natsfr/VNAV1.2/board/VNAV1/dxf/adccore-F.Cu.dxf

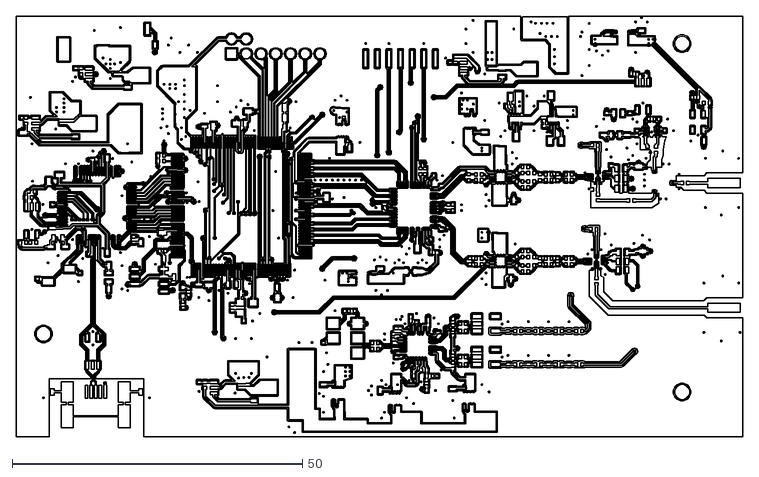
[picture p1: CAD file, 2022-05-22]
board/VNAV1/dxf/adccore-F.Cu.dxf
125.2 x 72.5
