natsfr/VNAV1.2/board/VNAV1/dxf/adccore-Edge.Cuts.dxf

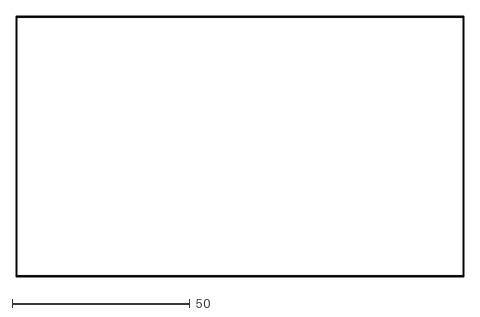
[picture p2: CAD file, 2022-05-22]
board/VNAV1/dxf/adccore-Edge.Cuts.dxf
125.9 x 73.1
