natsfr/VNAV1.2/(list of files, cad)

Other CAD files:
board/VNAV1/dxf/adccore-B.SilkS.dxf
