natsfr/VNAV1.2/board/VNAV1/doc/adccore.pdf

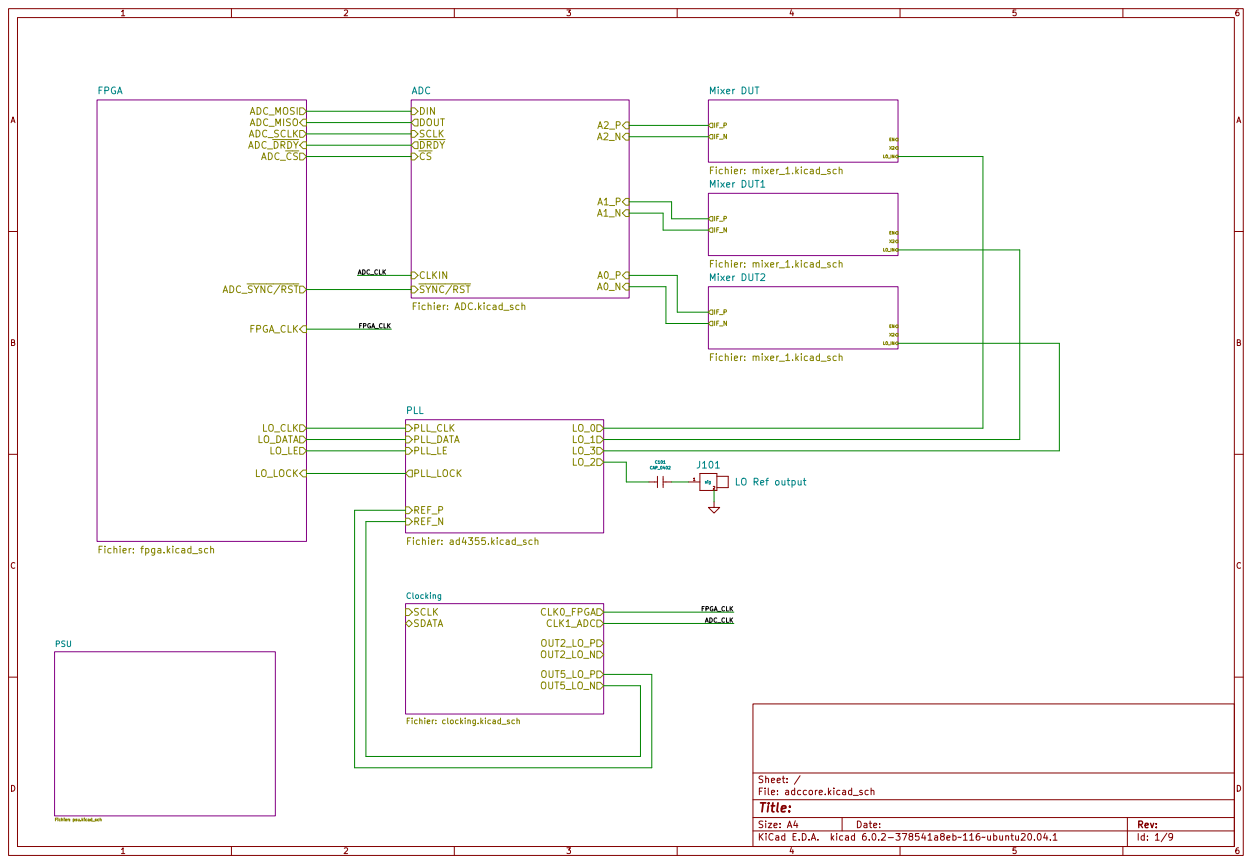
[picture p3: page 1]

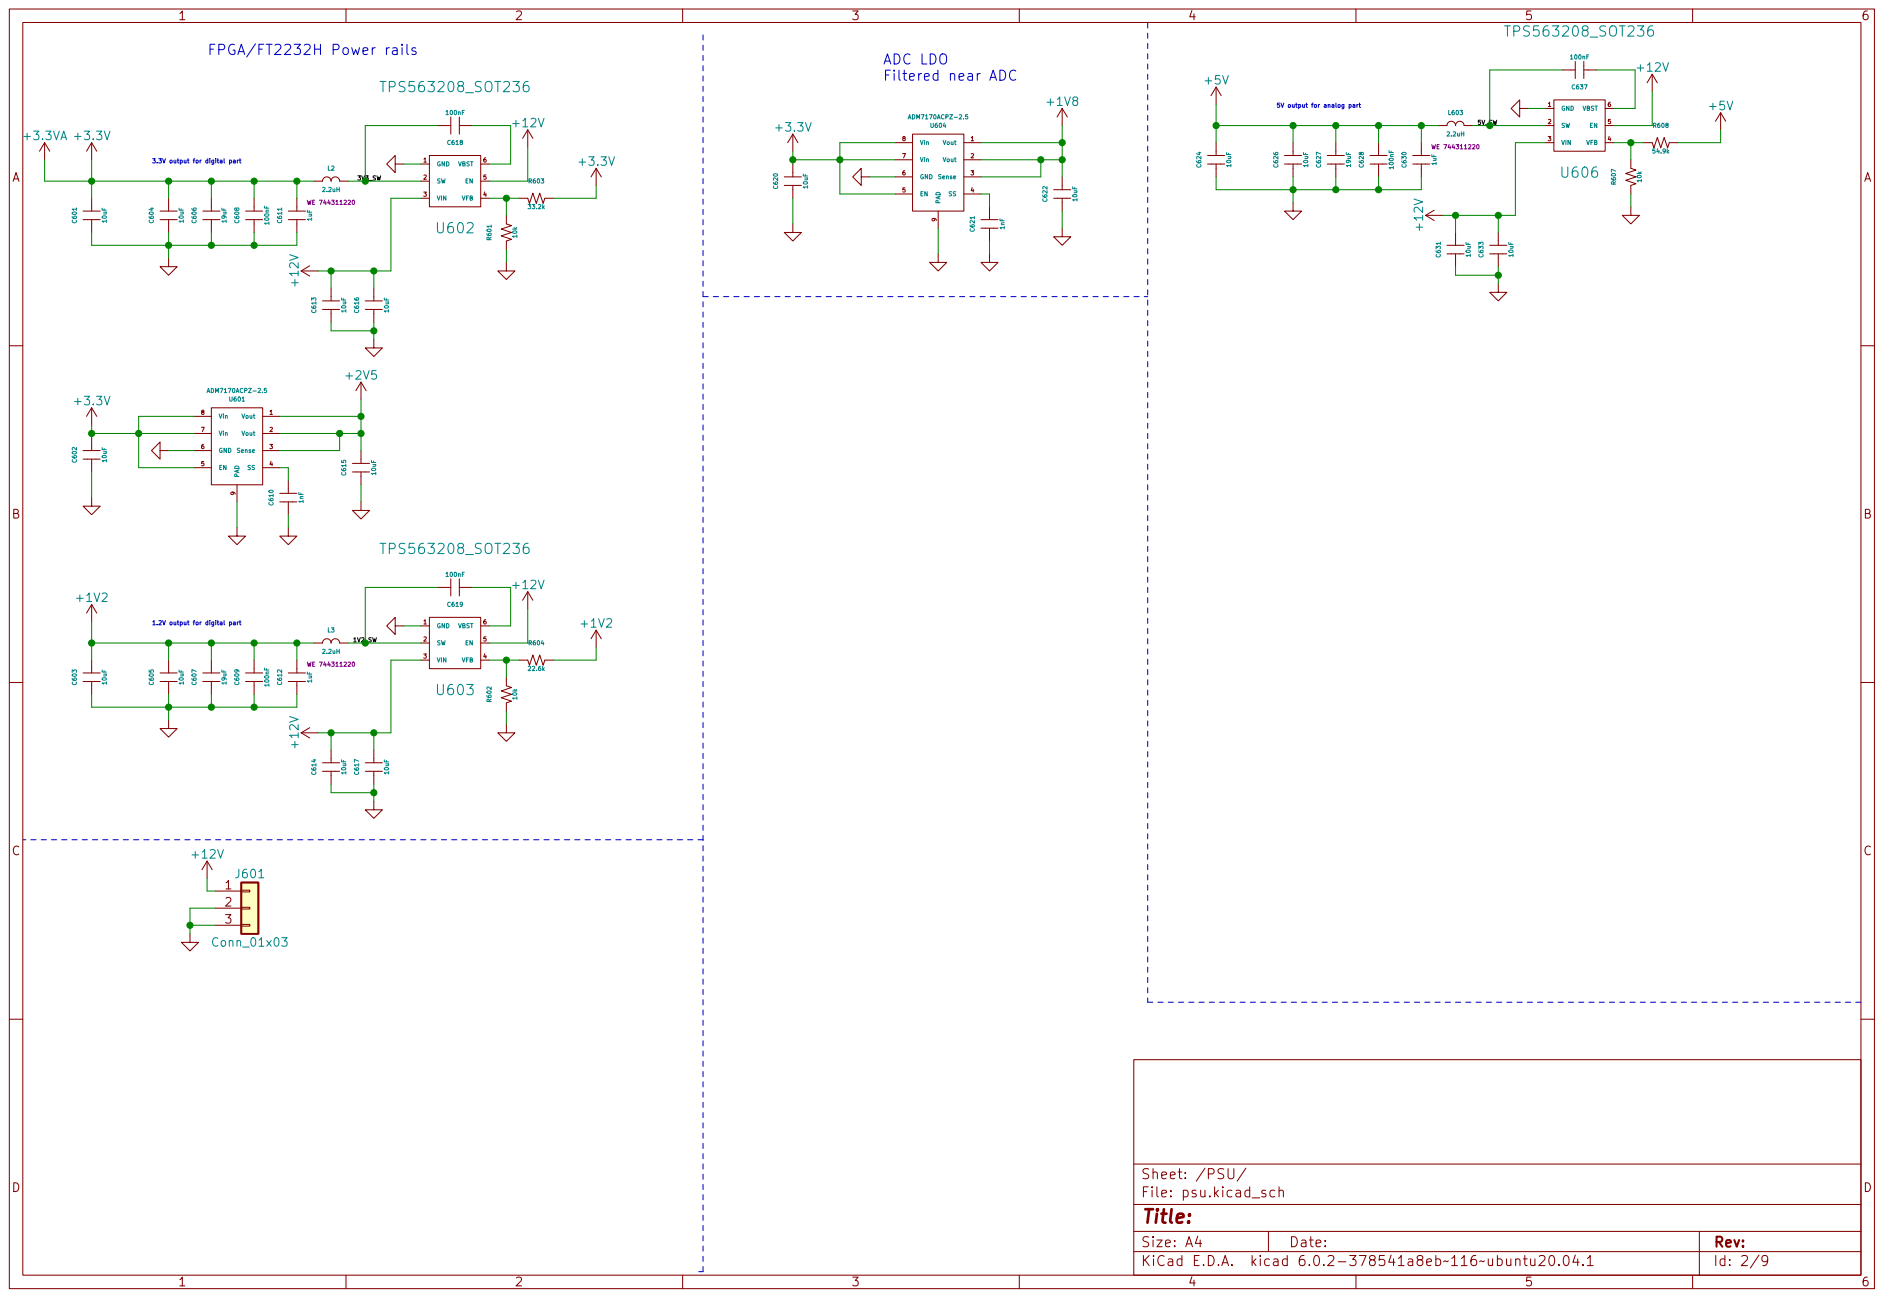
[picture p4: page 2]

5V output for analog part FPGA/FT2232H Power rails

1.2V output for digital part

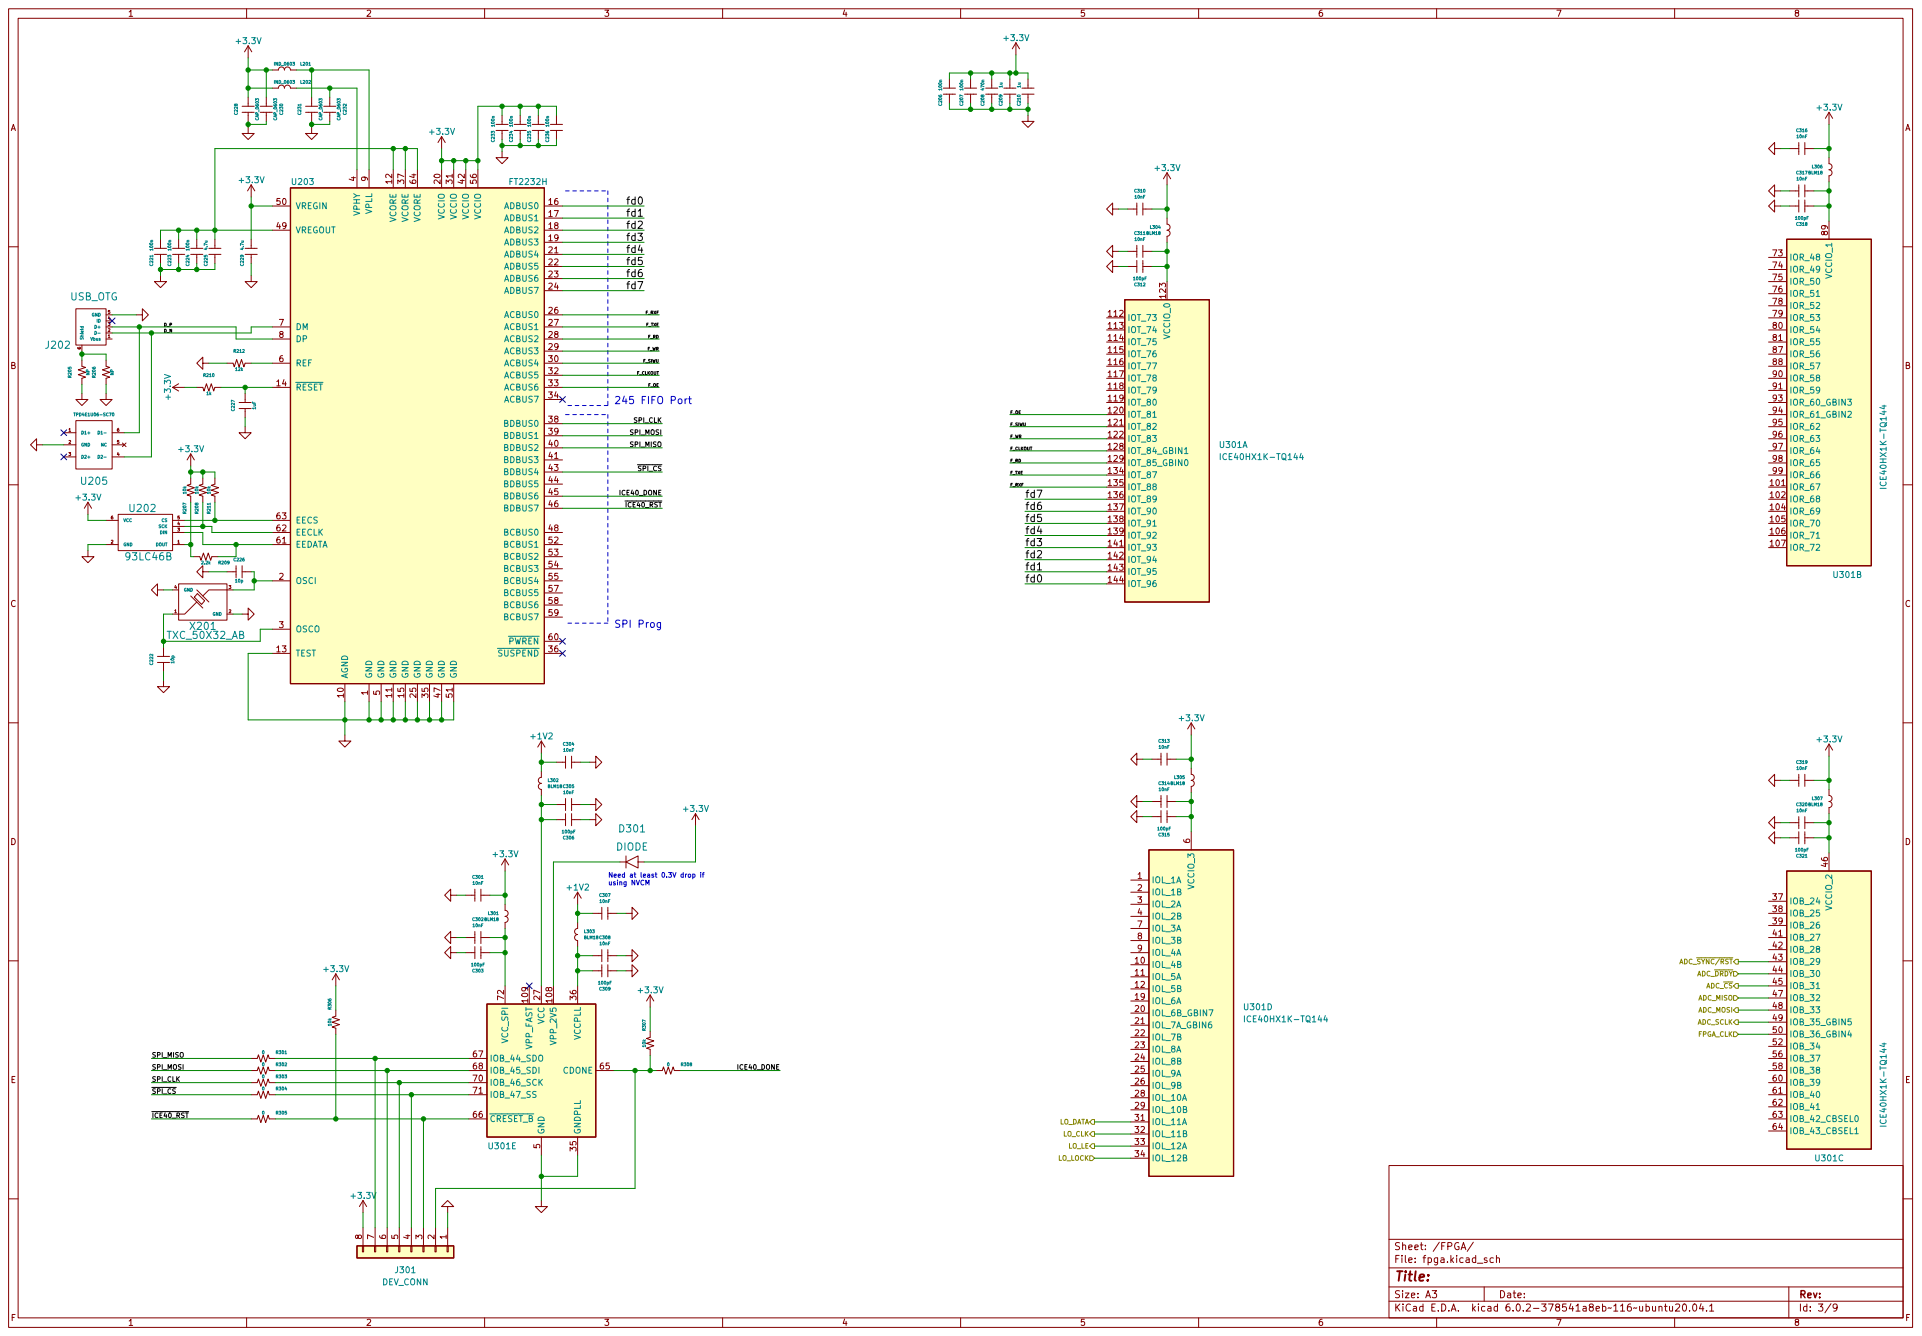
[picture p5: page 3]

File: fpga.kicad_sch Sheet: /FPGA/ C210 1u

fd1
fd2
fd3

Need at least 0.3V drop if using NVCM

ADC_~{DRDY} ADC_~{CS} ADC_MOSI ADC_~{SYNC/RST} ADC_MISO

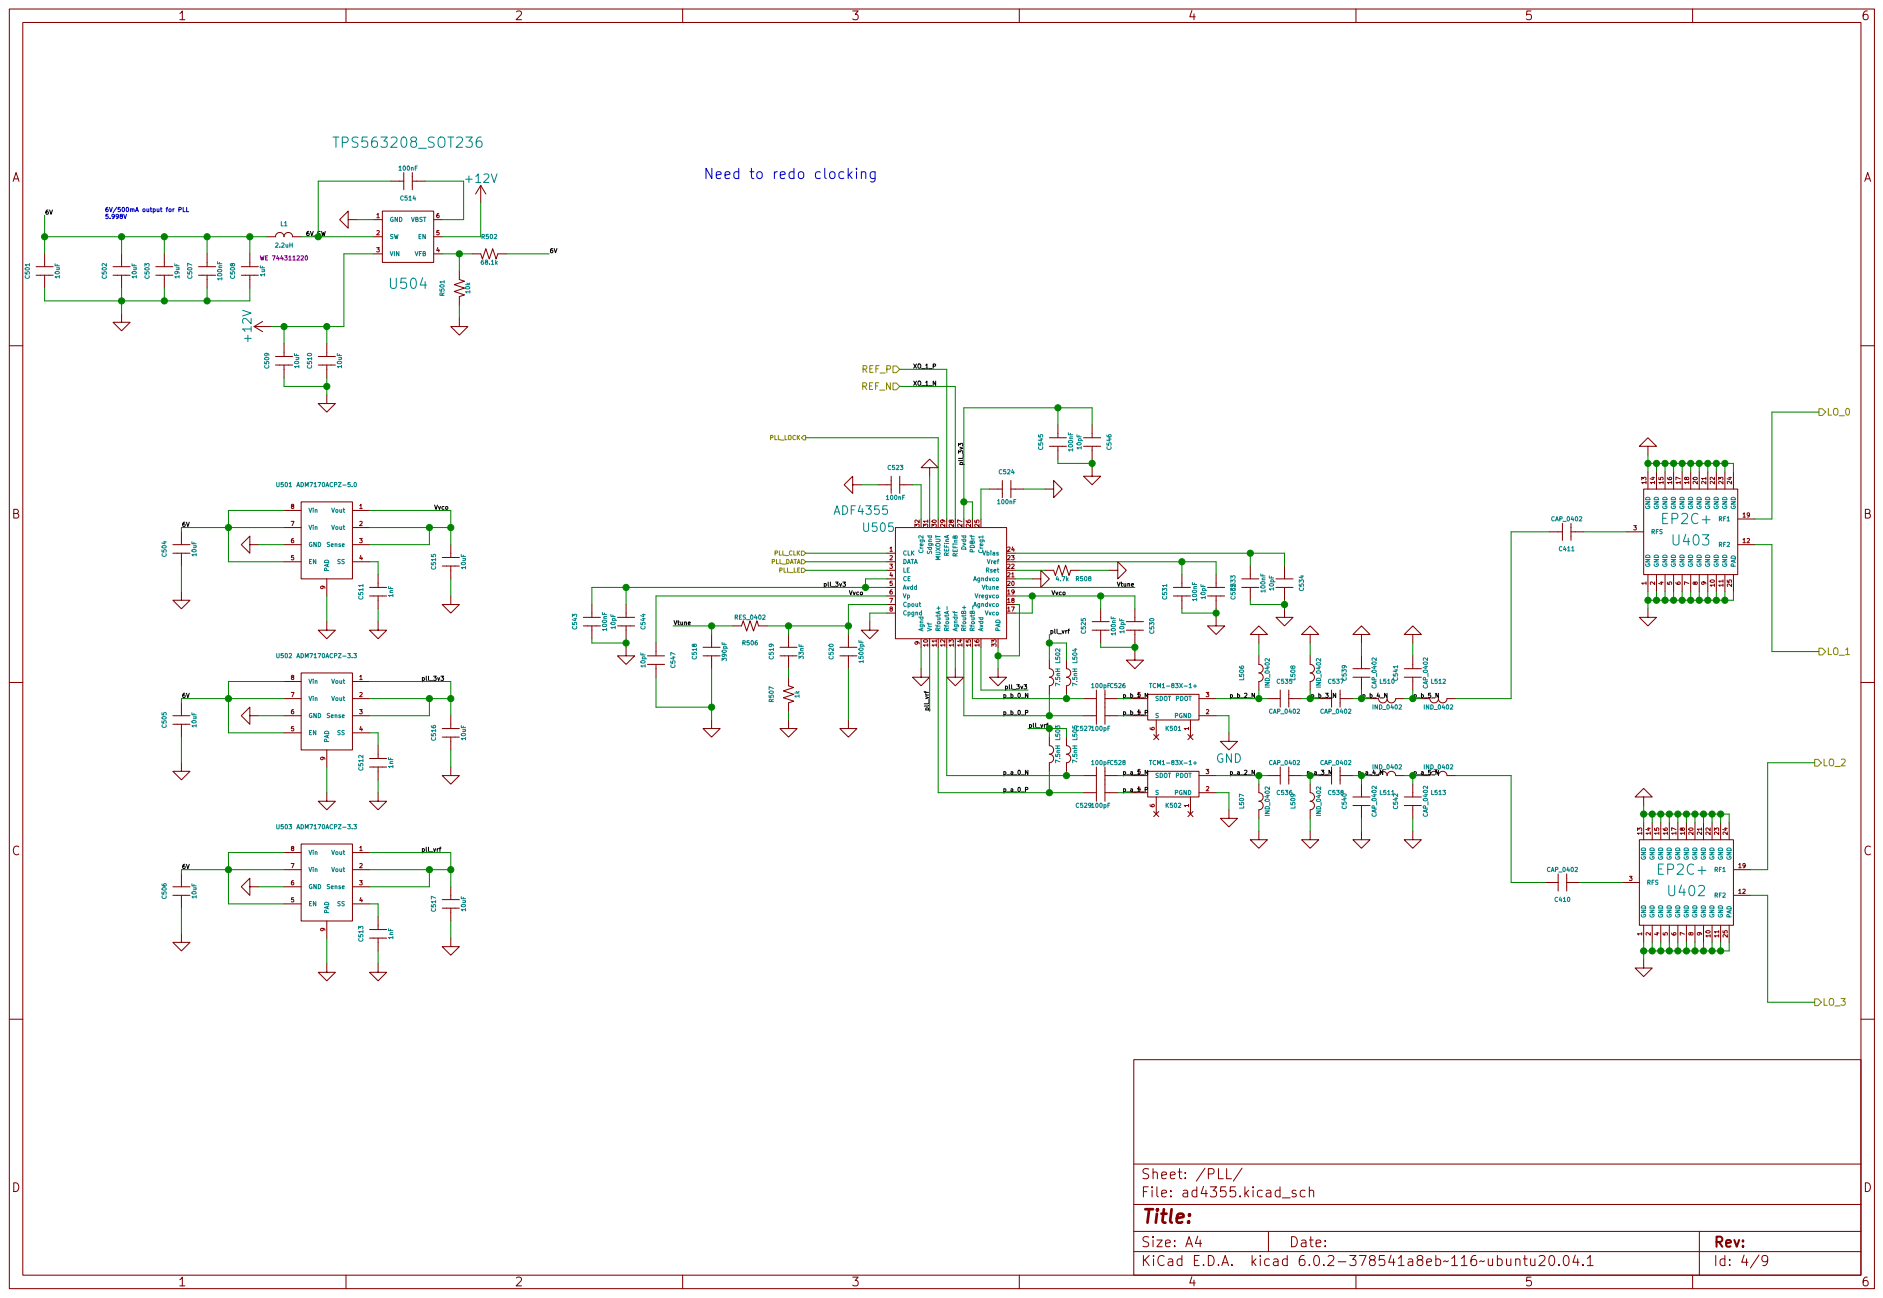
[picture p6: page 4]

9 U501 ADM7170ACPZ-5.0 C512 1nF C507 100nF C508 1uF C504 10uF C501 10uF C510 10uF C502 10uF C503 19uF +12V C509 10uF C515 10uF GND 1 SW 2 VIN 3 VFB 4 EN 5 VBST 6 U504 TPS563208_SOT236

2 GND 20 GND 21 GND 22 GND 23 GND 24 PAD 25 RFS 3 GND

1 GND 10 GND 11 RF2 12 GND 13 GND 14 GND 15 GND 16 GND 17 GND 18 RF1 19 GND

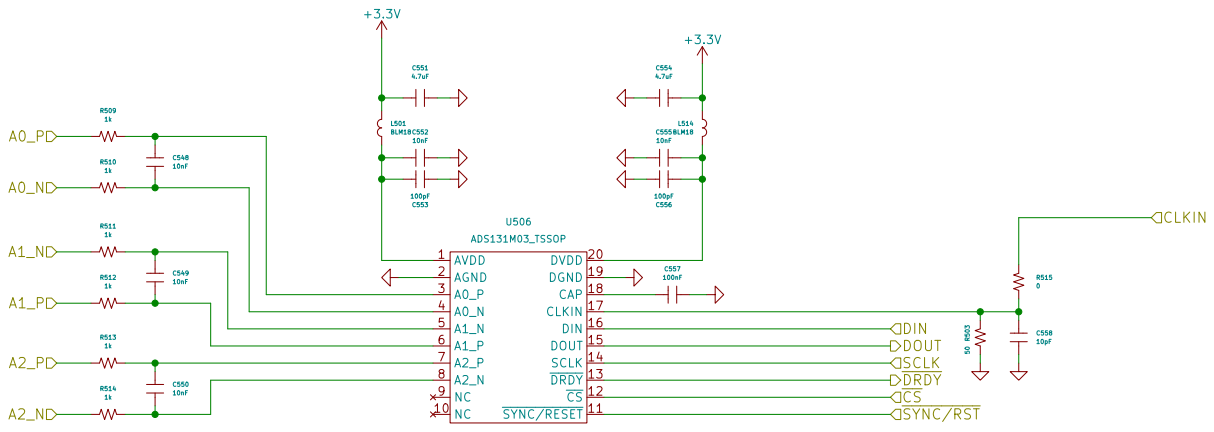
[picture p7: page 5]

File: ADC.kicad_sch Sheet: /ADC/
Id: 5/9 Title:

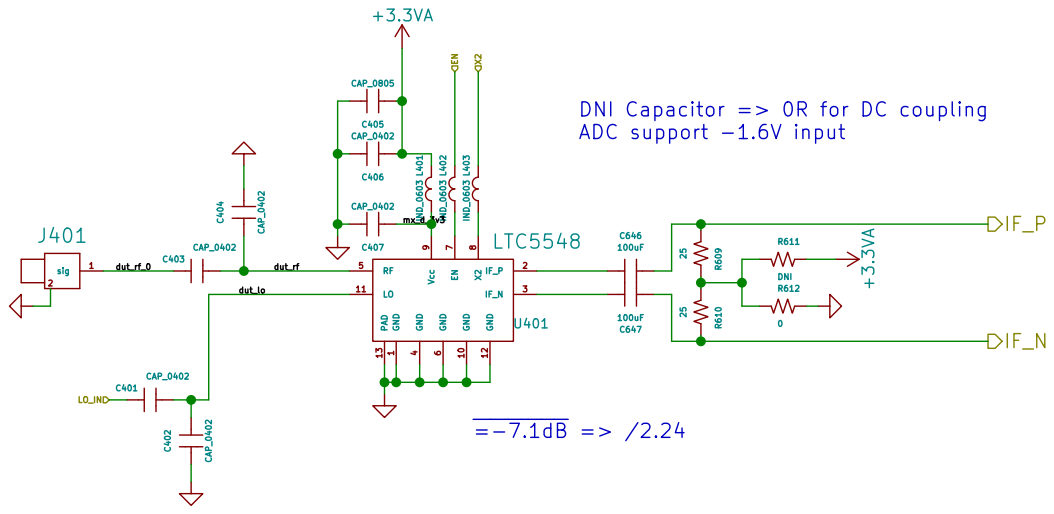
[picture p8: page 6]

File: mixer_1.kicad_sch Sheet: /Mixer DUT/
Id: 6/9 Title:

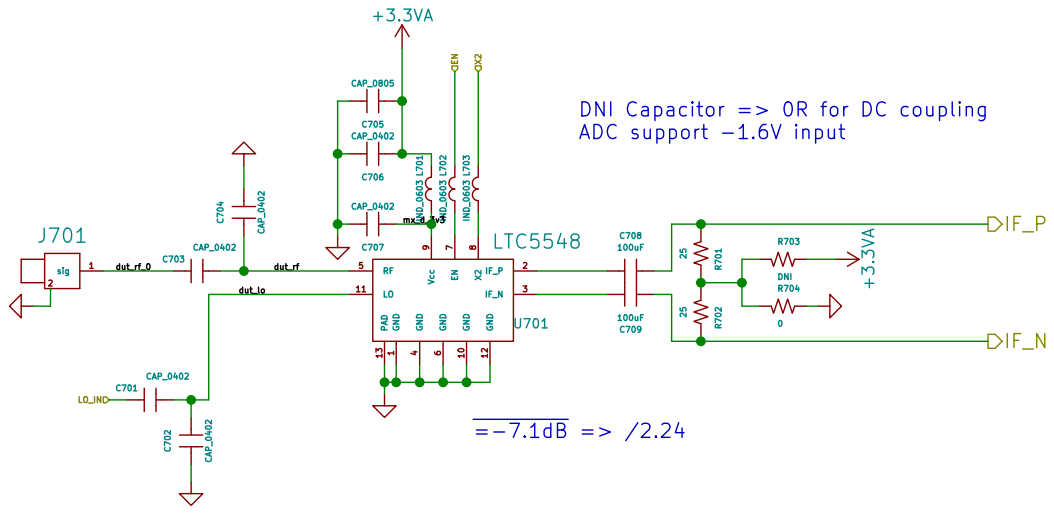
[picture p9: page 7]

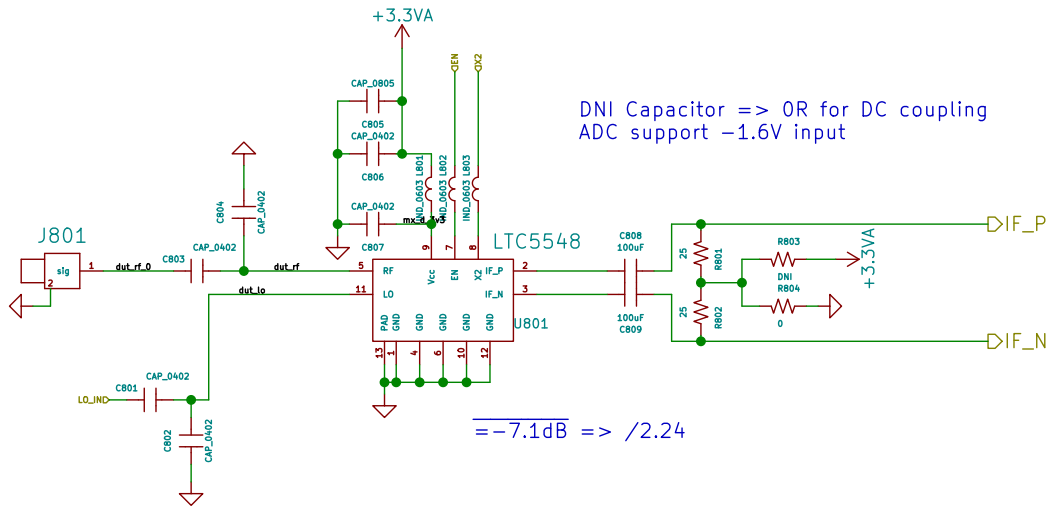
[picture p10: page 8]

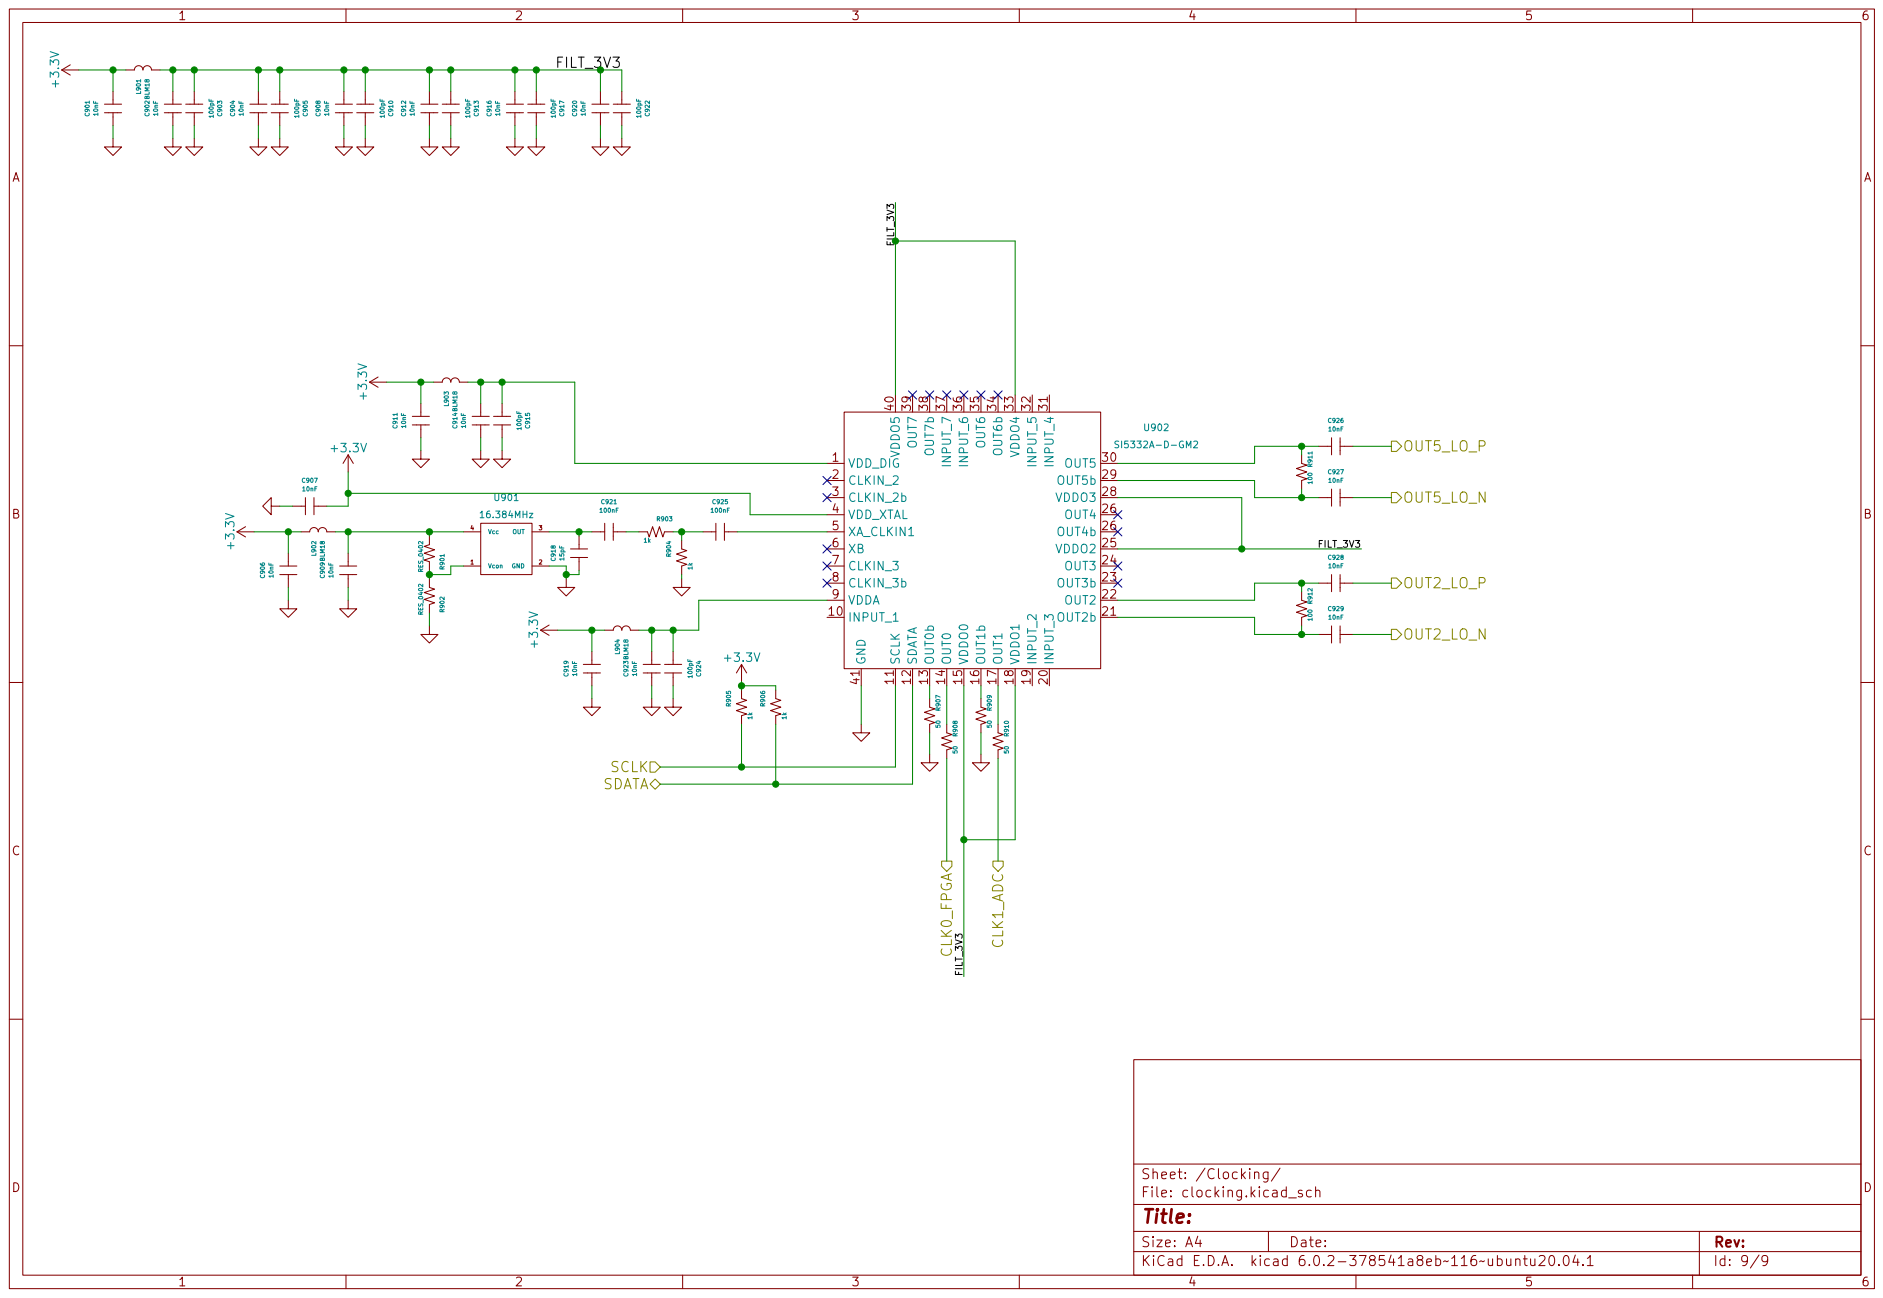
[picture p11: page 9]
