natsfr/VNAV1.2/board/VNAV1/adccore.kicad_pcb

## KiCad design board/VNAV1/adccore.kicad_pcb (2022-05-22)

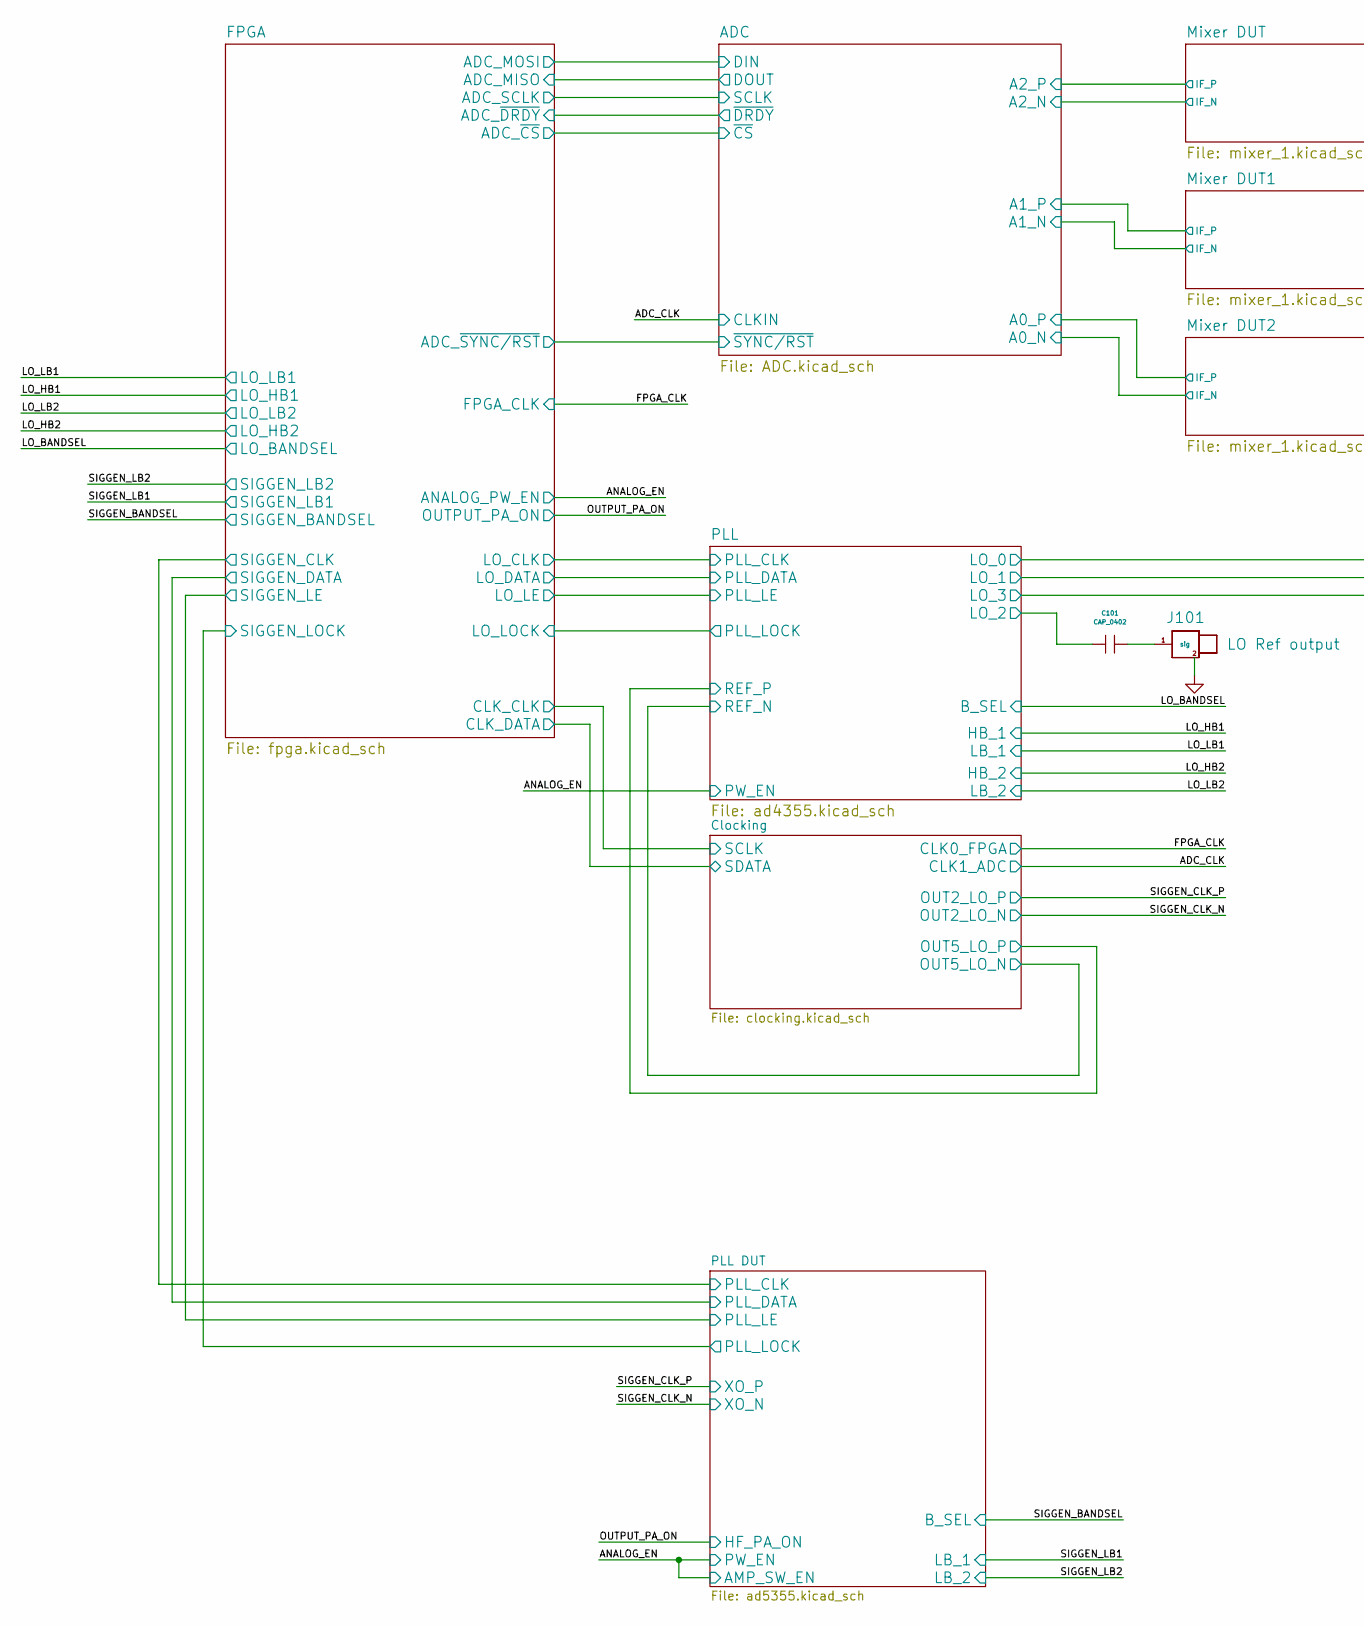
[picture p20: schematic adccore.kicad_sch, part in row 1, column 1]

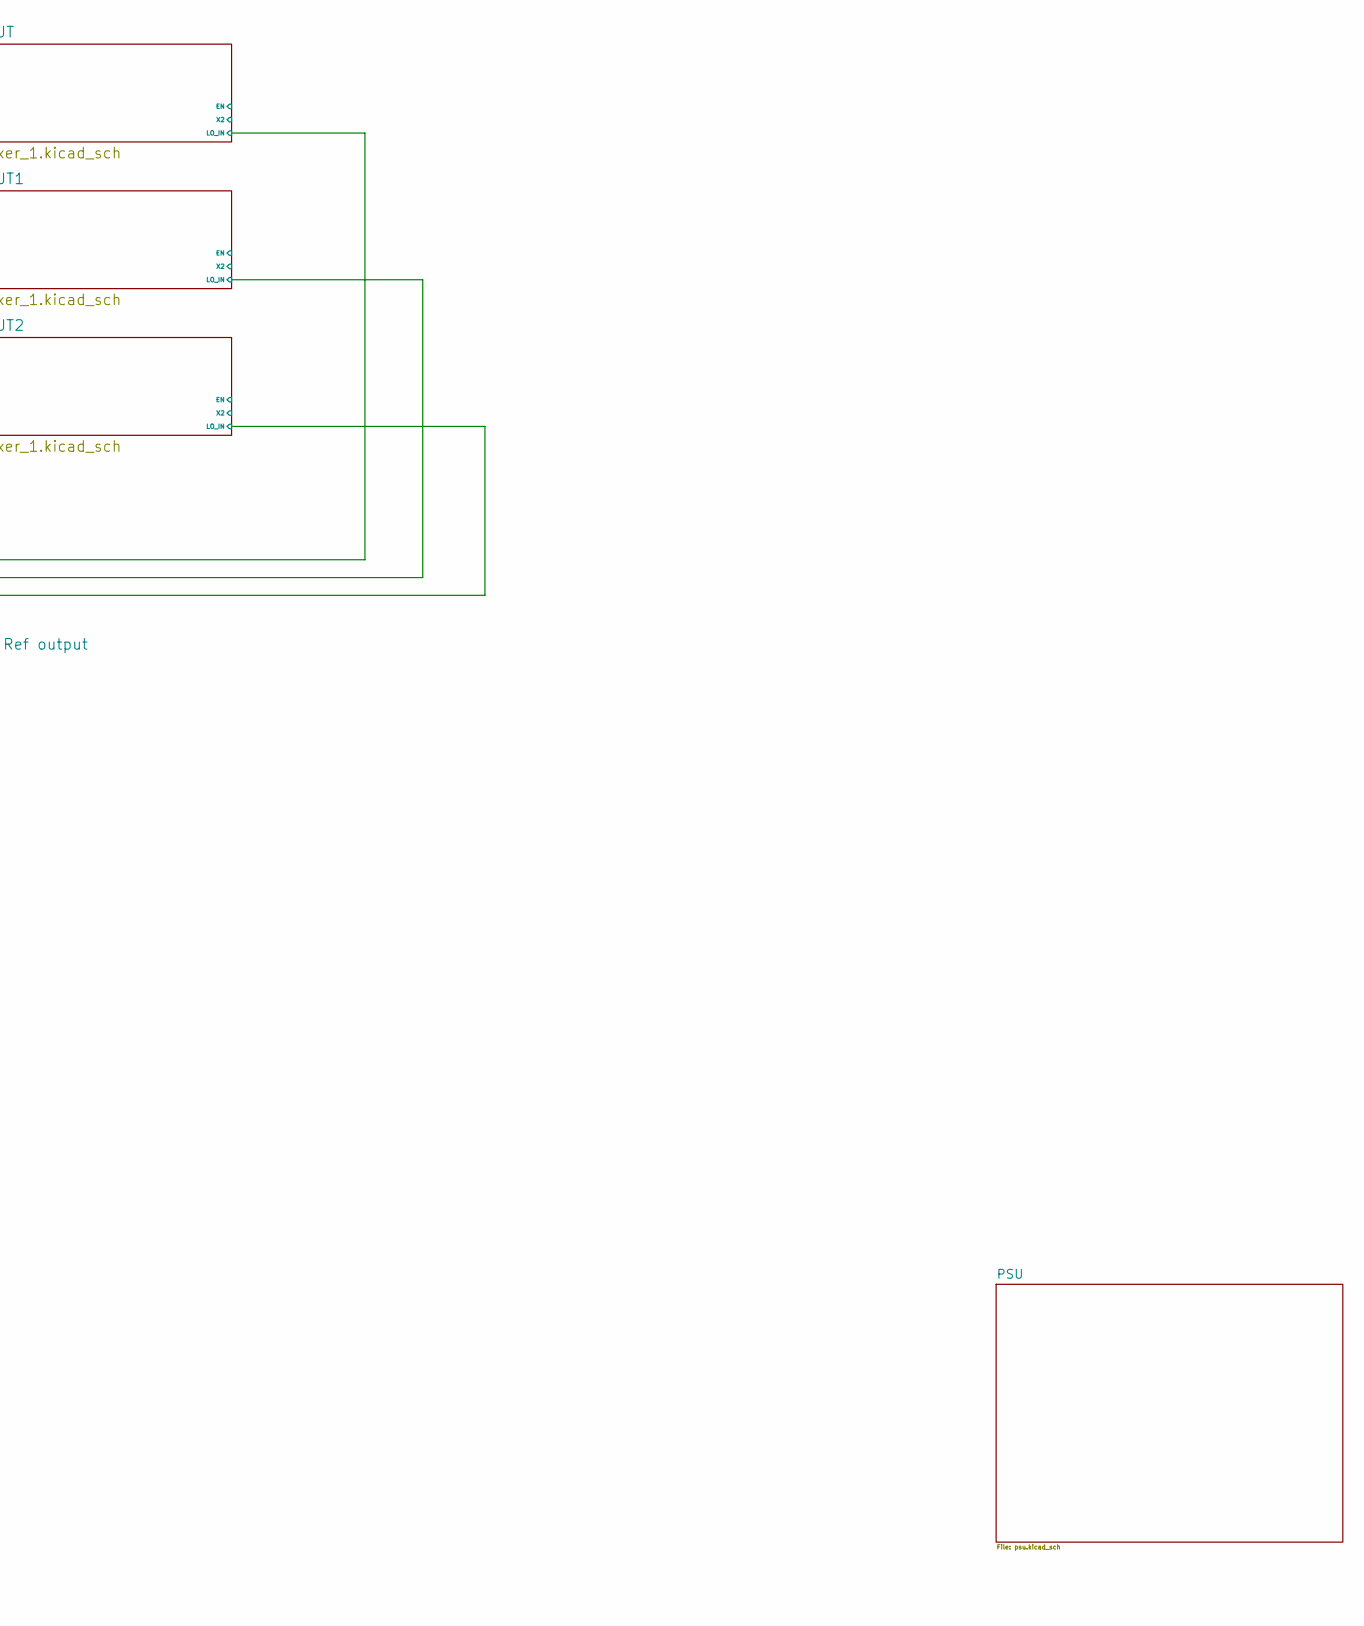
[picture p21: schematic adccore.kicad_sch, part in row 1, column 2]

Parts:
C101: CAP_0402; SM0402
J101: LO Ref output; SMA_AMP_132255-12

Connections:
/PLL/LO_2: C101.1; also elsewhere on the board
GND: J101.2; also elsewhere on the board
unnamed: C101.2, J101.1 (sig)

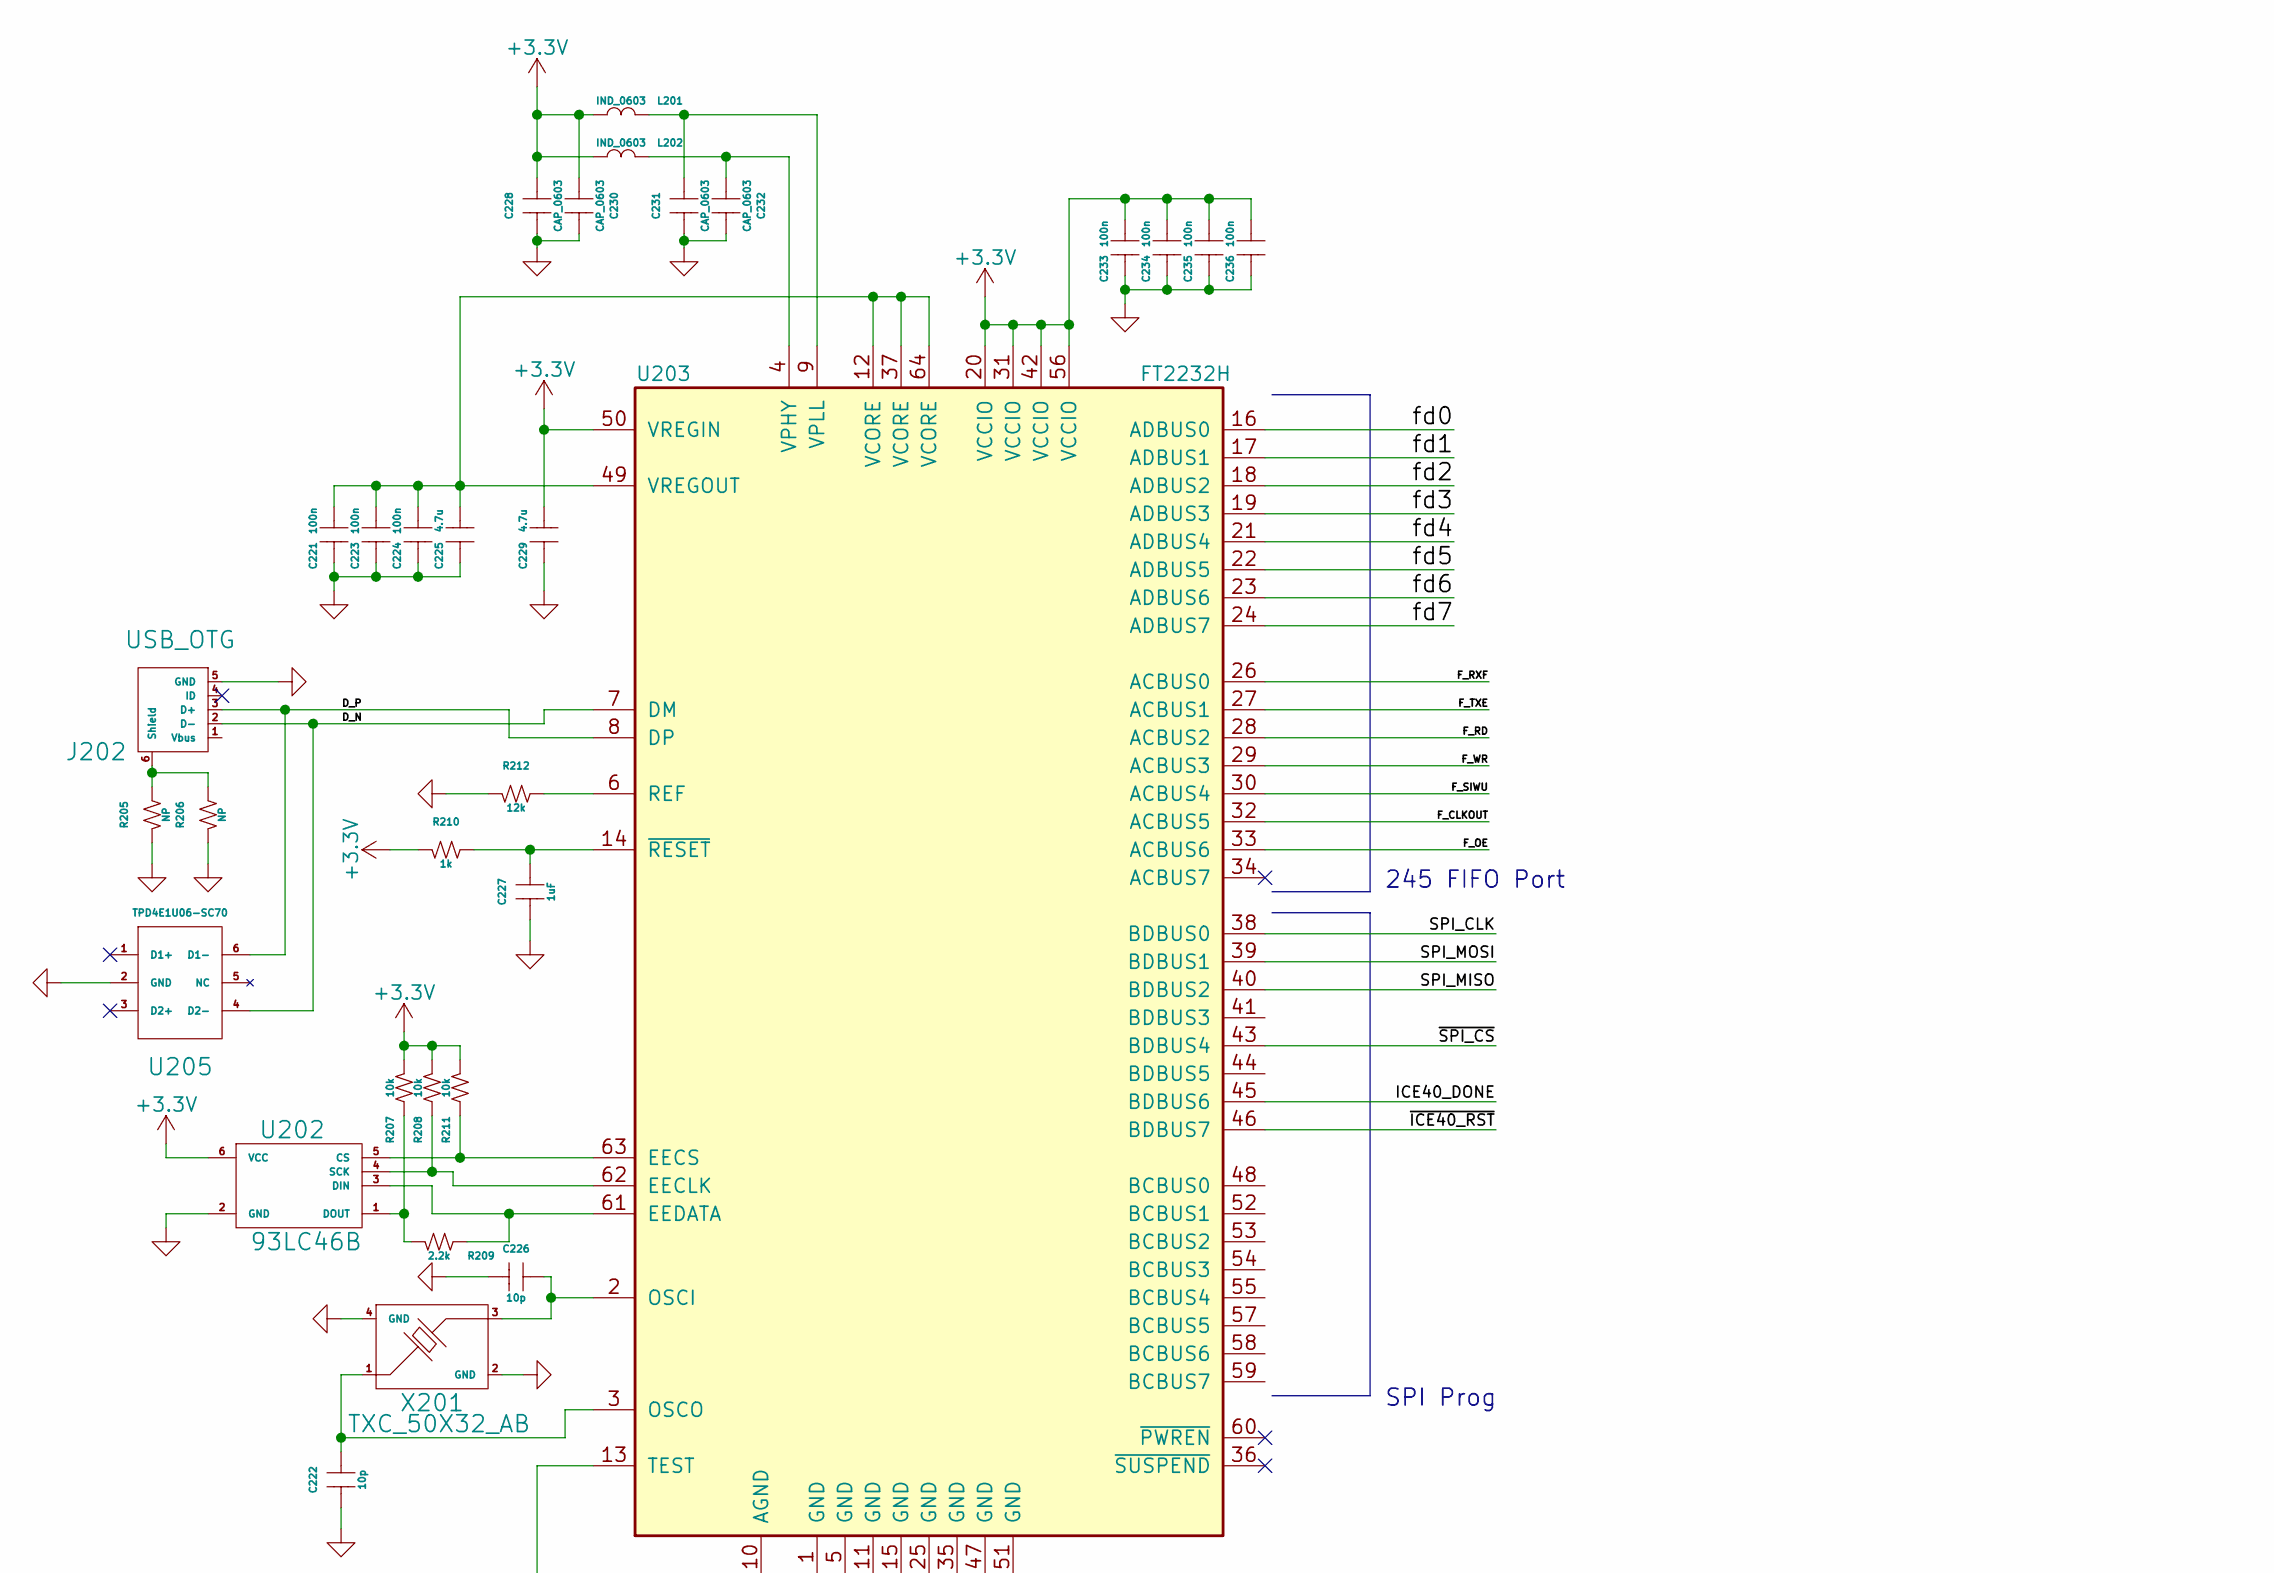
[picture p22: schematic fpga.kicad_sch, part in row 1, column 1]

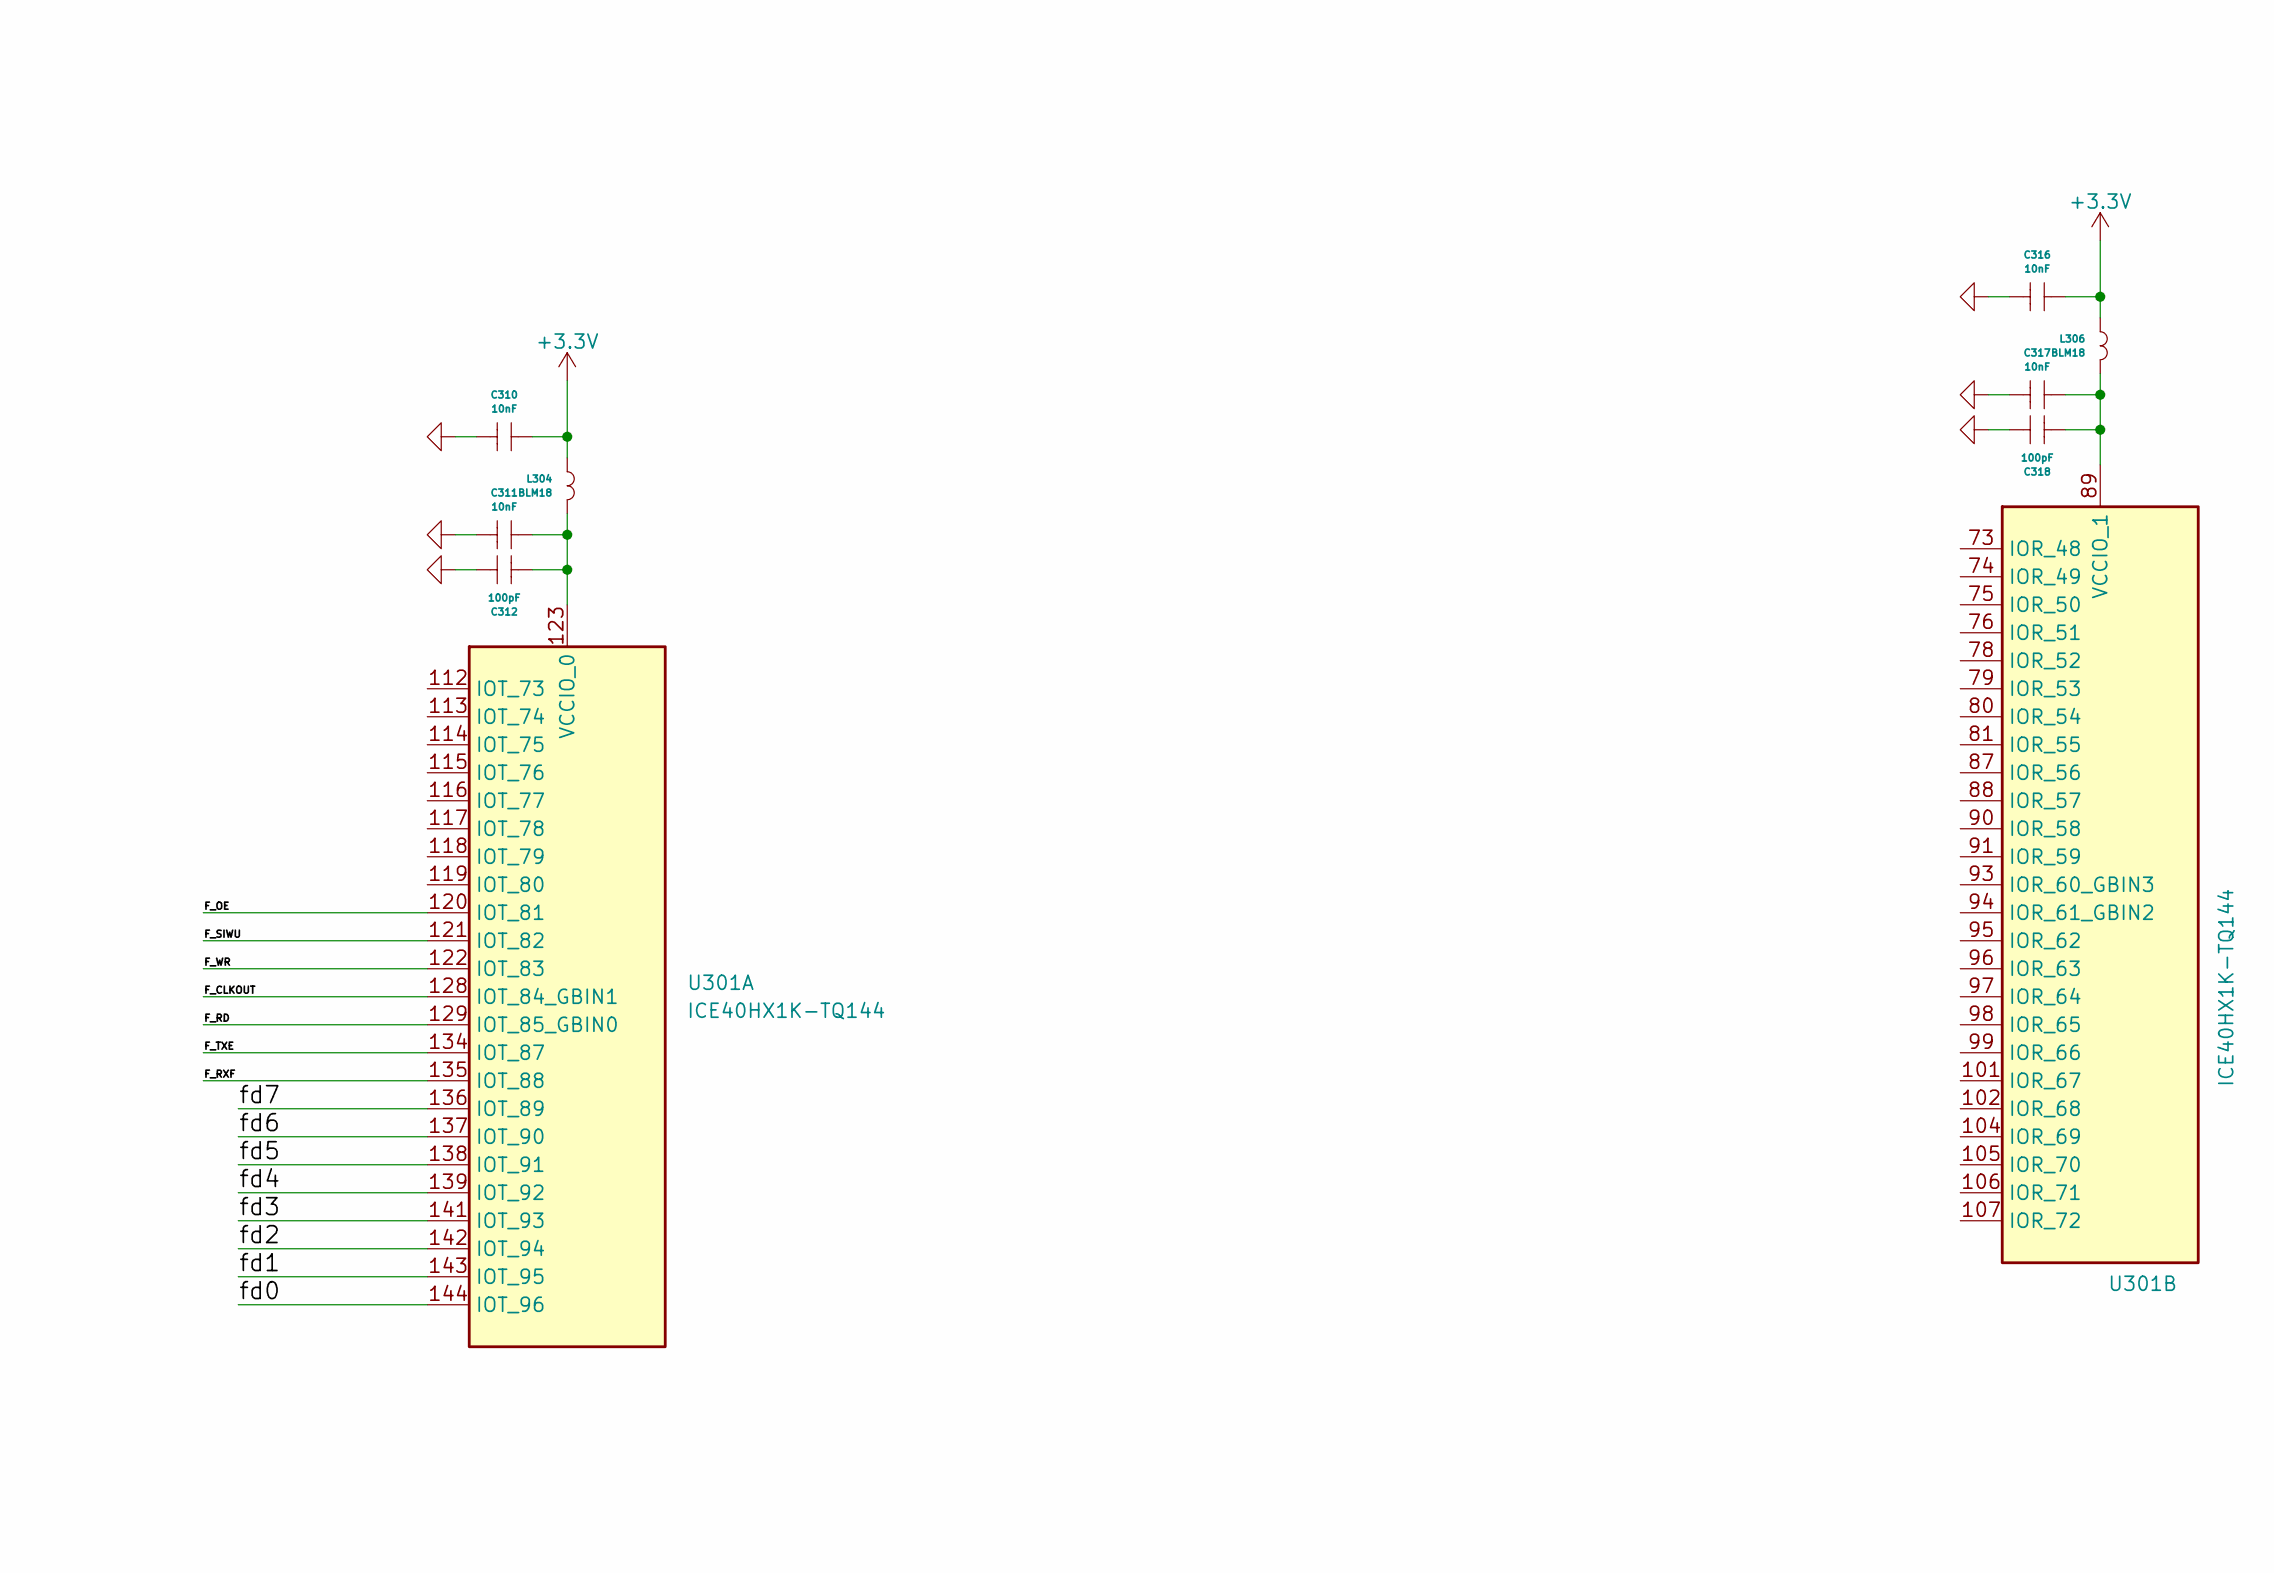
[picture p23: schematic fpga.kicad_sch, part in row 1, column 2]

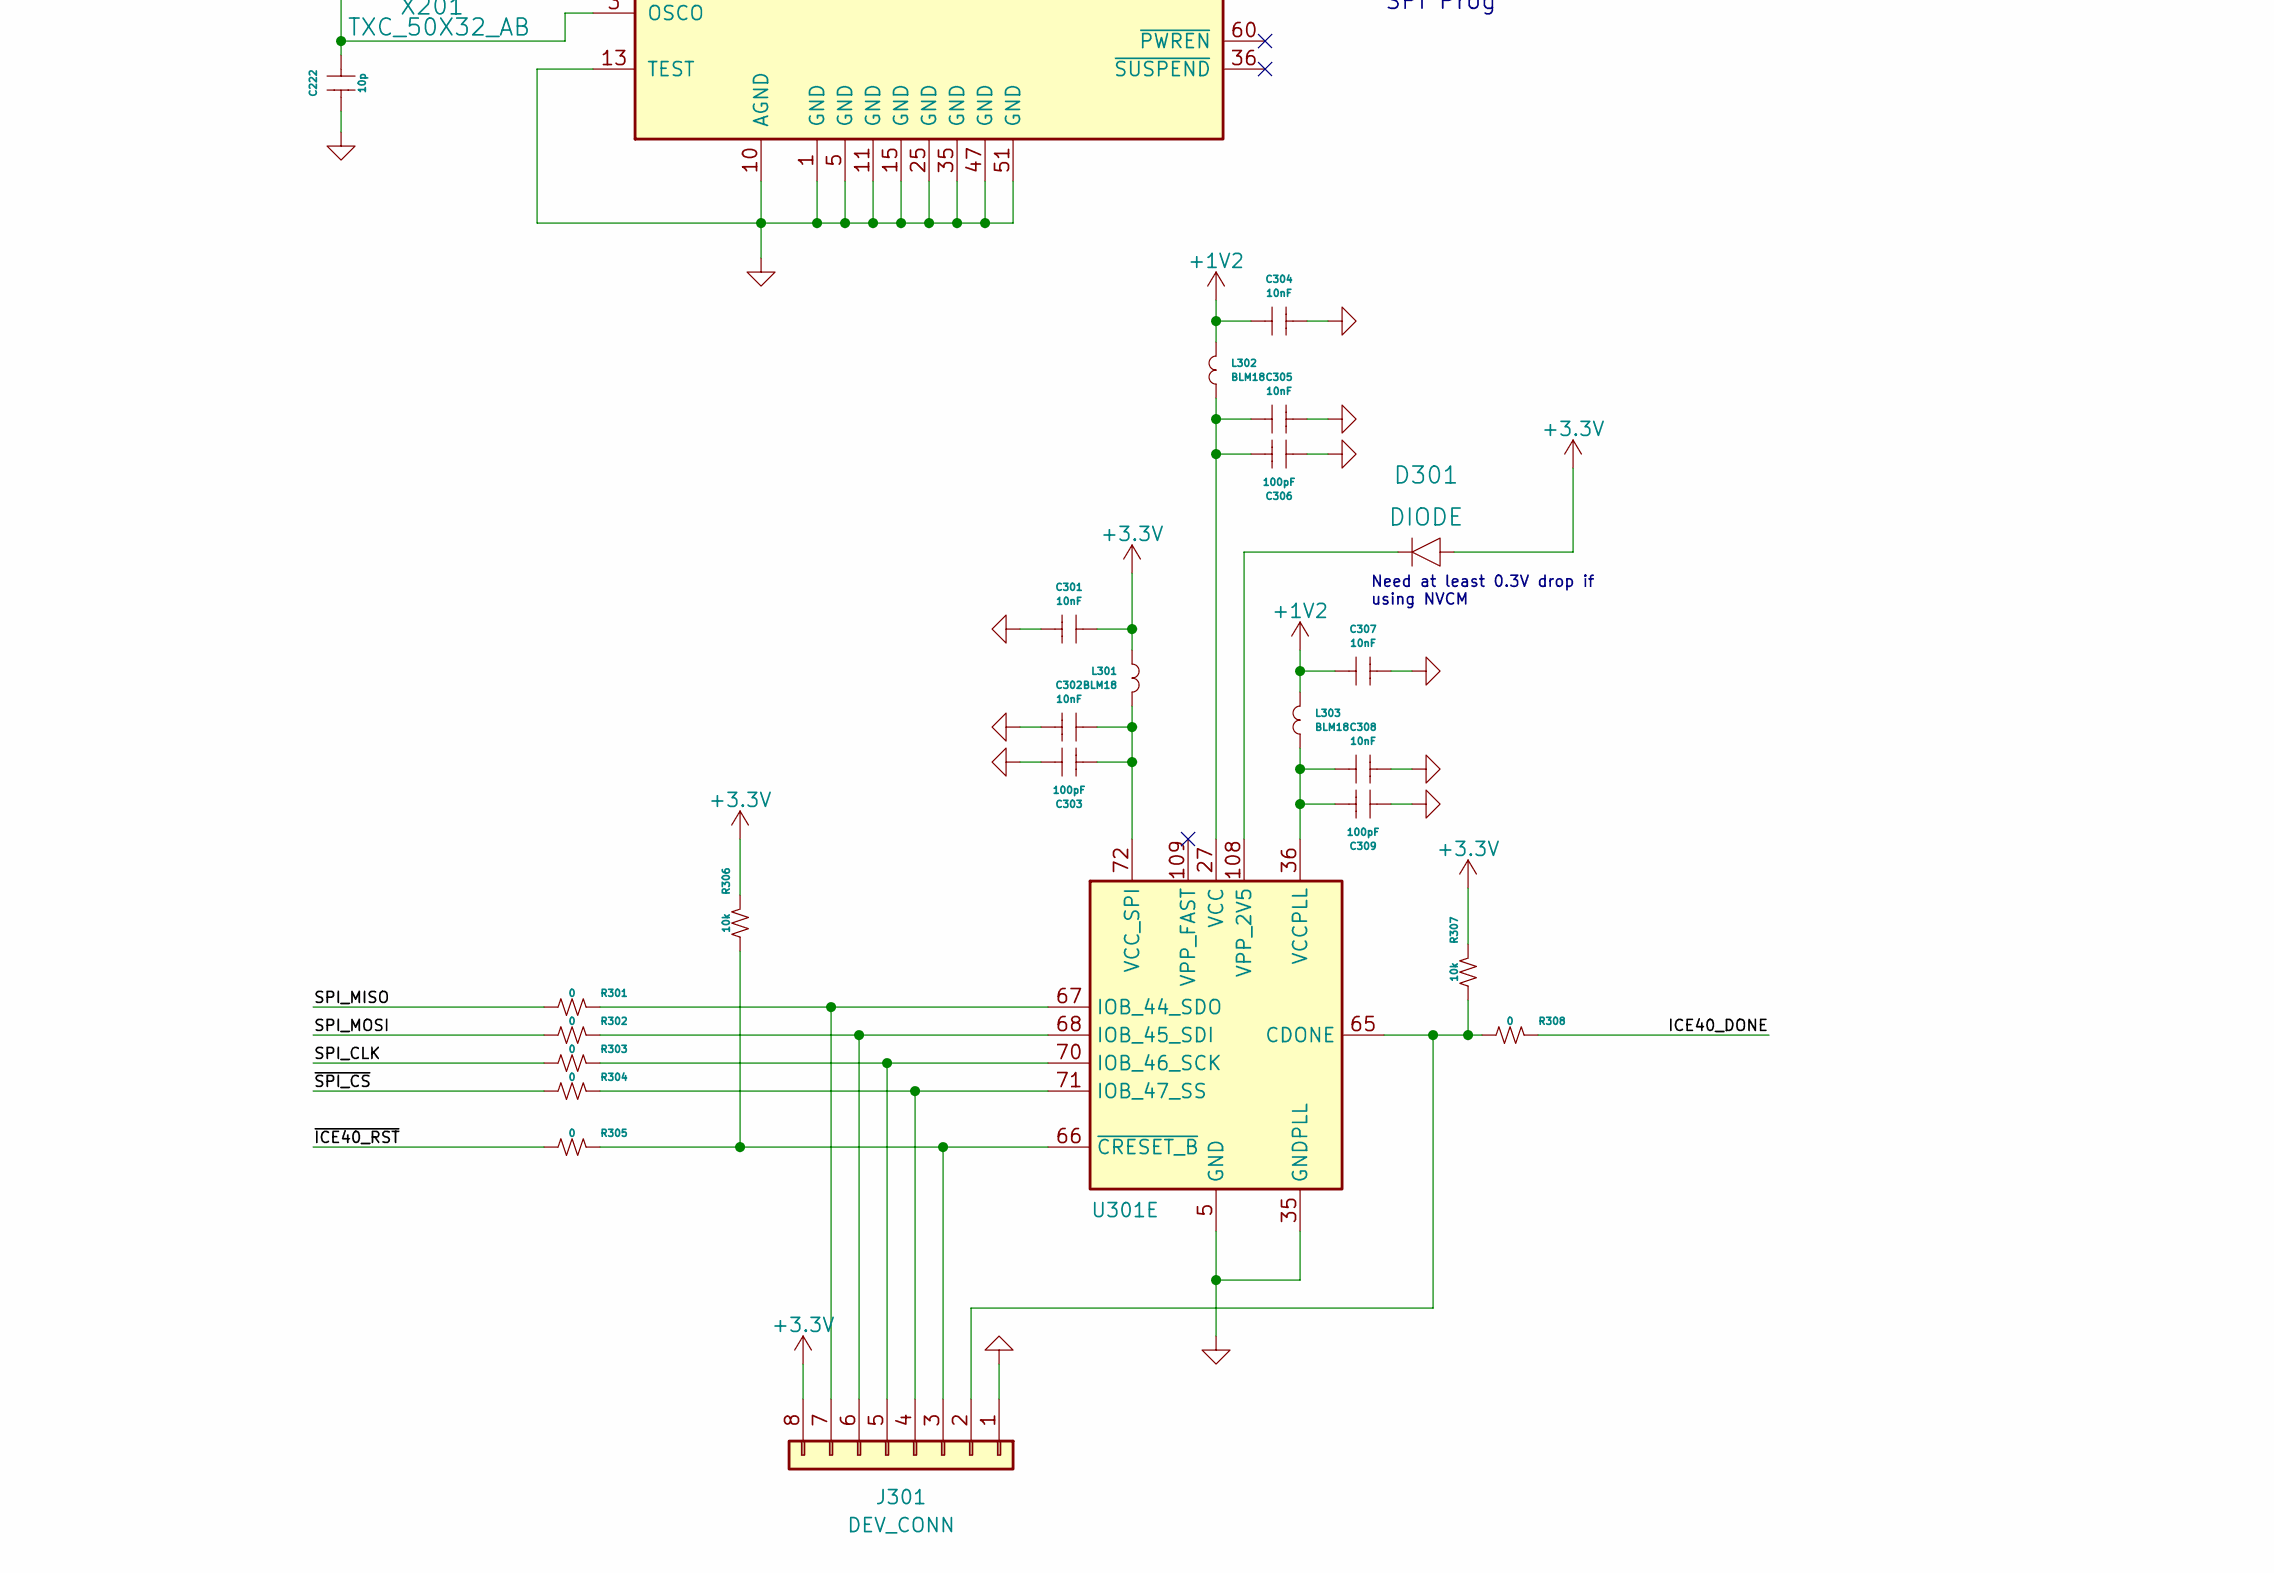
[picture p24: schematic fpga.kicad_sch, part in row 2, column 1]

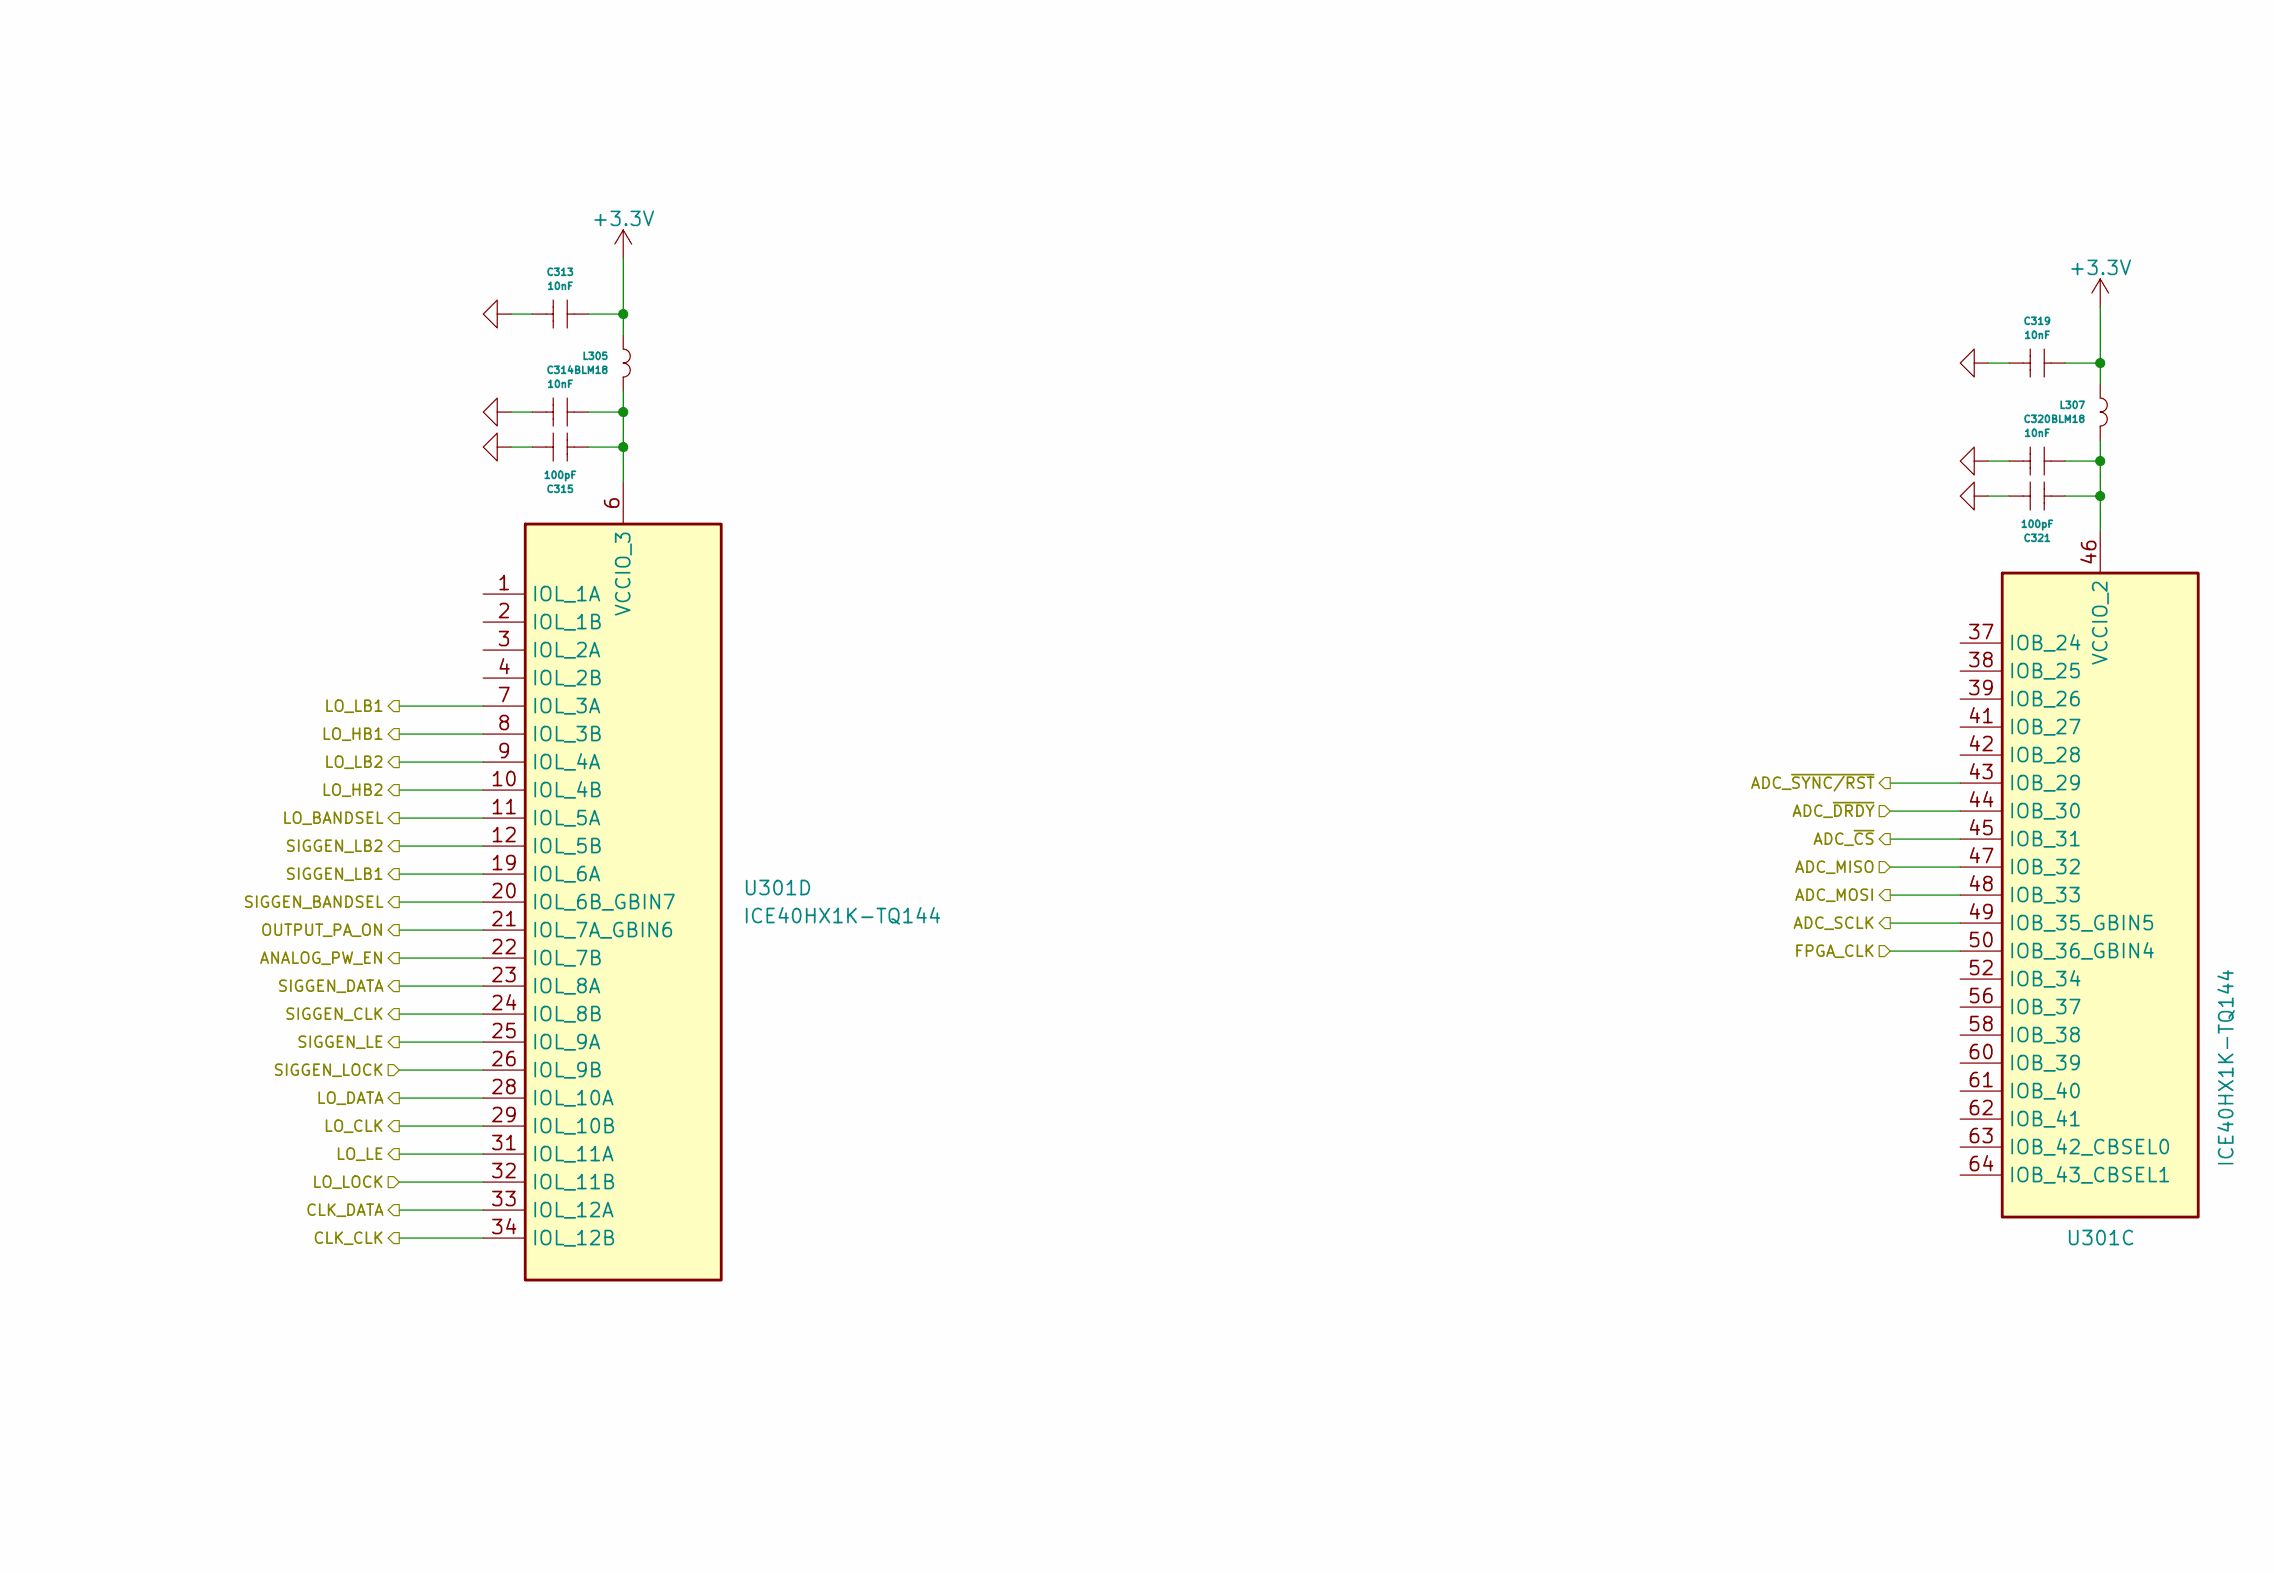
[picture p25: schematic fpga.kicad_sch, part in row 2, column 2]

Parts:
C221, C223, C224: 100n; SM0603
C222, C226: 10p; SM0402
C225, C229: 4.7u; SM0805
C227: 1uF; SM0603
C228, C230, C231, C232: CAP_0603; SM0603
C233, C234, C235, C236: 100n; SM0402
C301, C302, C304, C305, C307, C308, C310, C311, C313, C314, C316, C317, C319, C320: 10nF; SM0402
C303, C306, C309, C312, C315, C318, C321: 100pF; SM0402
D301: DIODE; SOD-123
J202: USB_OTG; USB_Micro-B_Wuerth_629105150521_CircularHoles
J301: DEV_CONN
L201, L202: IND_0603; SM0603
L301, L302, L303, L304, L305, L306, L307: BLM18; SM0603
R205, R206: NP; SM0603
R207, R208, R211, R306, R307: 10k; SM0402
R209: 2.2k; SM0402
R210: 1k; SM0402
R212: 12k; SM0402
R301, R302, R303, R304, R305, R308: 0; SM0402
U202: 93LC46B; SOT-236-095mm
U203: FT2232H; LQFP_64
U205: TPD4E1U06-SC70; SOT-236-095mm
U301: ICE40HX1K-TQ144; TQFP-144_20x20mm_P0.5mm
X201: TXC_50X32_AB; XTAL_5.0x3.2mm

Connections:
+1V2: C304.1, C307.1, L302.2, L303.2; also elsewhere on the board
+3.3VA: C228.1, C229.2, C230.1, C233.1, C234.1, C235.1, C236.1, C301.1, C310.1, C313.1, C316.1, C319.1, D301.A, J301.8, L201.1, L202.1, L301.2, L304.2, L305.2, L306.2, L307.2, R207.2, R208.2, R210.2, R211.2, R306.1, R307.1, U202.6 (VCC), U203.20 (VCCIO), U203.31 (VCCIO), U203.42 (VCCIO), U203.50 (VREGIN), U203.56 (VCCIO); also elsewhere on the board
/ADC/DIN: U301.48 (IOB_33); also elsewhere on the board
/ADC/DOUT: U301.47 (IOB_32); also elsewhere on the board
/ADC/SCLK: U301.49 (IOB_35_GBIN5); also elsewhere on the board
/ADC/~CS: U301.45 (IOB_31); also elsewhere on the board
/ADC/~DRDY: U301.44 (IOB_30); also elsewhere on the board
/ADC/~SYNC/RST: U301.43 (IOB_29); also elsewhere on the board
/ANALOG_EN: U301.22 (IOL_7B); also elsewhere on the board
/Clocking/SCLK: U301.34 (IOL_12B); also elsewhere on the board
/Clocking/SDATA: U301.33 (IOL_12A); also elsewhere on the board
/FPGA/D_N: J202.2 (D-), U203.7 (DM), U205.4 (D2-)
/FPGA/D_P: J202.3 (D+), U203.8 (DP), U205.6 (D1-)
/FPGA/F_CLKOUT: U203.32 (ACBUS5), U301.128 (IOT_84_GBIN1)
/FPGA/F_OE: U203.33 (ACBUS6), U301.120 (IOT_81)
/FPGA/F_RD: U203.28 (ACBUS2), U301.129 (IOT_85_GBIN0)
/FPGA/F_RXF: U203.26 (ACBUS0), U301.135 (IOT_88)
/FPGA/F_SIWU: U203.30 (ACBUS4), U301.121 (IOT_82)
/FPGA/F_TXE: U203.27 (ACBUS1), U301.134 (IOT_87)
/FPGA/F_WR: U203.29 (ACBUS3), U301.122 (IOT_83)
/FPGA/ICE40_DONE: R308.1, U203.45 (BDBUS6)
/FPGA/LO_CLK: U301.29 (IOL_10B); also elsewhere on the board
/FPGA/LO_DATA: U301.28 (IOL_10A); also elsewhere on the board
/FPGA/LO_LE: U301.31 (IOL_11A); also elsewhere on the board
/FPGA/LO_LOCK: U301.32 (IOL_11B); also elsewhere on the board
/FPGA/SIGGEN_CLK: U301.24 (IOL_8B); also elsewhere on the board
/FPGA/SIGGEN_DATA: U301.23 (IOL_8A); also elsewhere on the board
/FPGA/SIGGEN_LE: U301.25 (IOL_9A); also elsewhere on the board
/FPGA/SIGGEN_LOCK: U301.26 (IOL_9B); also elsewhere on the board
/FPGA/SPI_CLK: R303.2, U203.38 (BDBUS0)
/FPGA/SPI_MISO: R301.2, U203.40 (BDBUS2)
/FPGA/SPI_MOSI: R302.2, U203.39 (BDBUS1)
/FPGA/fd0: U203.16 (ADBUS0), U301.144 (IOT_96)
/FPGA/fd1: U203.17 (ADBUS1), U301.143 (IOT_95)
/FPGA/fd2: U203.18 (ADBUS2), U301.142 (IOT_94)
/FPGA/fd3: U203.19 (ADBUS3), U301.141 (IOT_93)
/FPGA/fd4: U203.21 (ADBUS4), U301.139 (IOT_92)
/FPGA/fd5: U203.22 (ADBUS5), U301.138 (IOT_91)
/FPGA/fd6: U203.23 (ADBUS6), U301.137 (IOT_90)
/FPGA/fd7: U203.24 (ADBUS7), U301.136 (IOT_89)
/FPGA/~ICE40_RST: R305.2, U203.46 (BDBUS7)
/FPGA/~SPI_CS: R304.2, U203.43 (BDBUS4)
/FPGA_CLK: U301.50 (IOB_36_GBIN4); also elsewhere on the board
/LO_BANDSEL: U301.11 (IOL_5A); also elsewhere on the board
/LO_HB1: U301.8 (IOL_3B); also elsewhere on the board
/LO_HB2: U301.10 (IOL_4B); also elsewhere on the board
/LO_LB1: U301.7 (IOL_3A); also elsewhere on the board
/LO_LB2: U301.9 (IOL_4A); also elsewhere on the board
/OUTPUT_PA_ON: U301.21 (IOL_7A_GBIN6); also elsewhere on the board
/SIGGEN_BANDSEL: U301.20 (IOL_6B_GBIN7); also elsewhere on the board
/SIGGEN_LB1: U301.19 (IOL_6A); also elsewhere on the board
/SIGGEN_LB2: U301.12 (IOL_5B); also elsewhere on the board
GND: C221.2, C222.2, C223.2, C224.2, C225.1, C226.2, C227.2, C228.2, C229.1, C230.2, C231.2, C232.2, C233.2, C234.2, C235.2, C236.2, C301.2, C302.2, C303.1, C304.2, C305.2, C306.1, C307.2, C308.2, C309.1, C310.2, C311.2, C312.1, C313.2, C314.2, C315.1, C316.2, C317.2, C318.1, C319.2, C320.2, C321.1, J202.5 (GND), J301.1, R205.2, R206.2, R212.2, U202.2 (GND), U203.1 (GND), U203.5 (GND), U203.10 (AGND), U203.11 (GND), U203.13 (TEST), U203.15 (GND), U203.25 (GND), U203.35 (GND), U203.47 (GND), U203.51 (GND), U205.2 (GND), U301.5 (GND), U301.13 (GND), U301.14 (GND), U301.35 (GNDPLL), U301.59 (GND), U301.69 (GND), U301.86 (GND), U301.103 (GND), U301.132 (GND), U301.140 (GND), X201.2 (GND), X201.4 (GND); also elsewhere on the board
unnamed: C221.1, C223.1, C224.1, C225.2, U203.12 (VCORE), U203.37 (VCORE), U203.49 (VREGOUT), U203.64 (VCORE)
unnamed: C222.1, U203.3 (OSCO), X201.1
unnamed: C226.1, U203.2 (OSCI), X201.3
unnamed: C227.1, R210.1, U203.14 (~RESET)
unnamed: C231.1, L201.2, U203.9 (VPLL)
unnamed: C232.1, L202.2, U203.4 (VPHY)
unnamed: C302.1, C303.2, L301.1, U301.72 (VCC_SPI)
unnamed: C305.1, C306.2, L302.1, U301.27 (VCC), U301.51 (VCC), U301.92 (VCC), U301.111 (VCC)
unnamed: C308.1, C309.2, L303.1, U301.36 (VCCPLL)
unnamed: C311.1, C312.2, L304.1, U301.123 (VCCIO_0), U301.133 (VCCIO_0)
unnamed: C314.1, C315.2, L305.1, U301.6 (VCCIO_3), U301.30 (VCCIO_3)
unnamed: C317.1, C318.2, L306.1, U301.89 (VCCIO_1), U301.100 (VCCIO_1)
unnamed: C320.1, C321.2, L307.1, U301.46 (VCCIO_2), U301.57 (VCCIO_2)
unnamed: D301.K, U301.108 (VPP_2V5)
unnamed: J202.6 (Shield), R205.1, R206.1
unnamed: J301.2, R307.2, R308.2, U301.65 (CDONE)
unnamed: J301.3, R305.1, R306.2, U301.66 (~CRESET_B)
unnamed: J301.4, R304.1, U301.71 (IOB_47_SS)
unnamed: J301.5, R303.1, U301.70 (IOB_46_SCK)
unnamed: J301.6, R302.1, U301.68 (IOB_45_SDI)
unnamed: J301.7, R301.1, U301.67 (IOB_44_SDO)
unnamed: R207.1, R209.2, U202.1 (DOUT)
unnamed: R208.1, U202.4 (SCK), U203.62 (EECLK)
unnamed: R209.1, U202.3 (DIN), U203.61 (EEDATA)
unnamed: R211.1, U202.5 (CS), U203.63 (EECS)
unnamed: R212.1, U203.6 (REF)

Notes on the sheet:
245 FIFO Port
Need at least 0.3V drop if using NVCM
SPI Prog
