natsfr/VNAV1.2/board/VNAV1/adccore.kicad_pcb

## KiCad design board/VNAV1/adccore.kicad_pcb (continued)

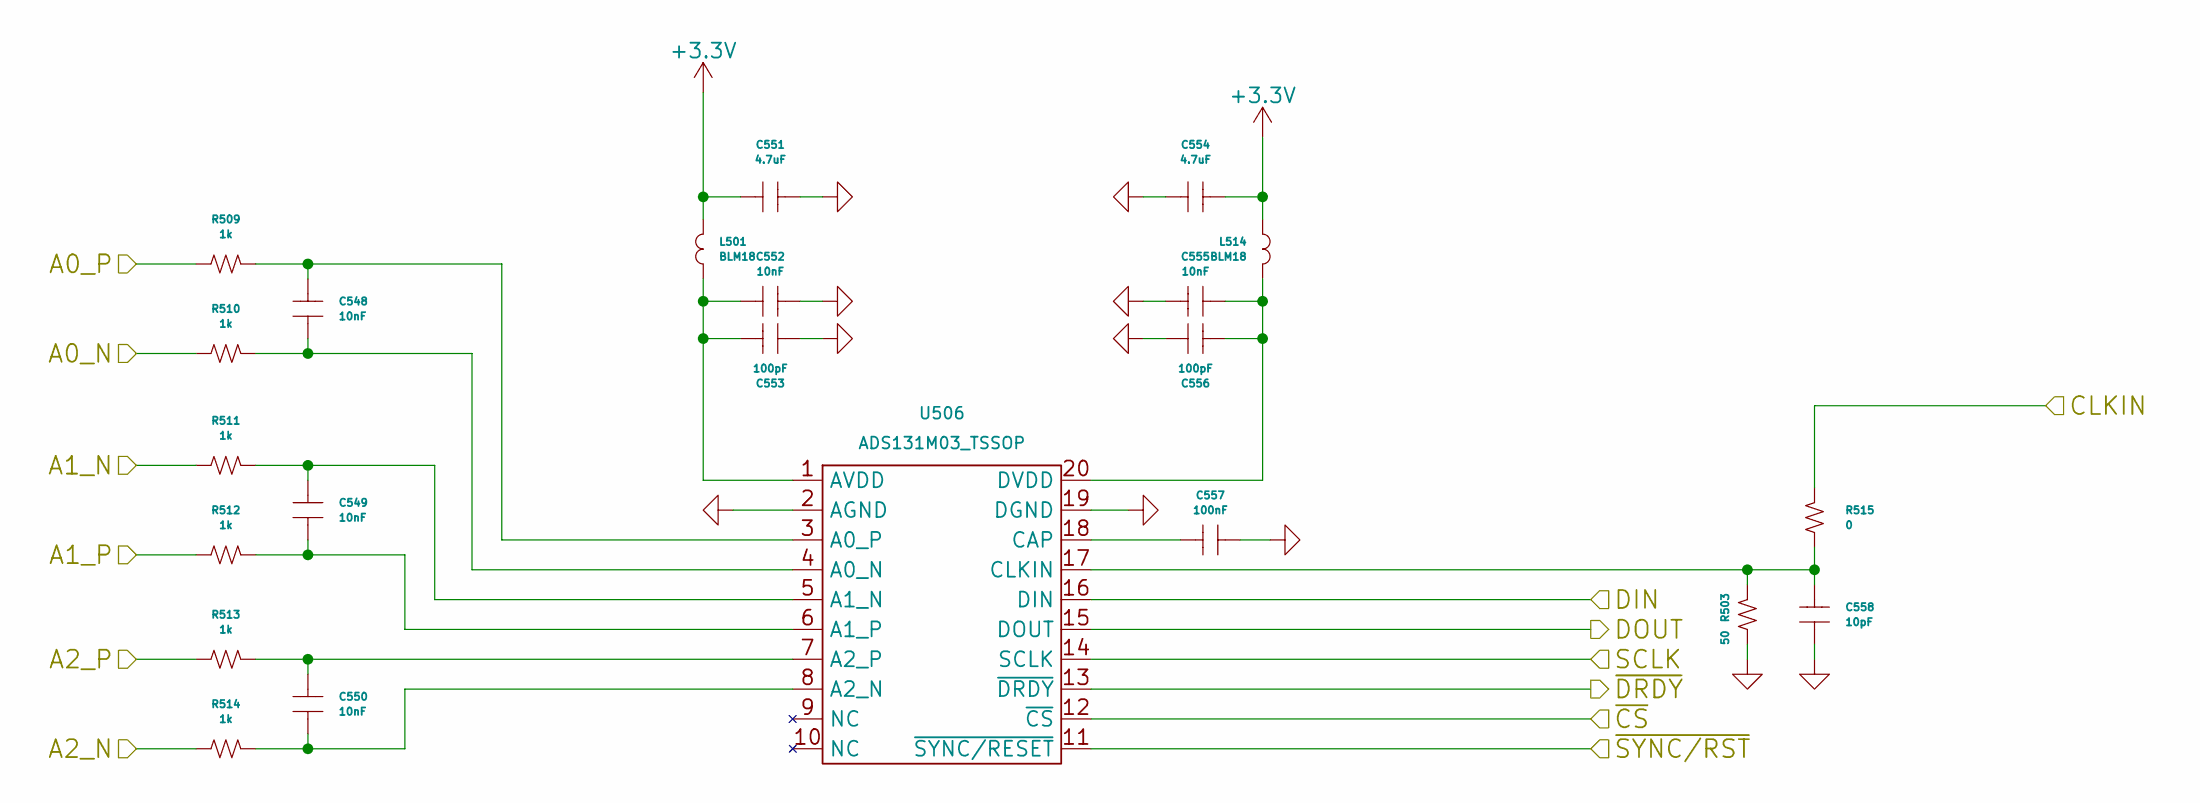
[picture p26: schematic ADC.kicad_sch]

Parts:
C548, C549, C550, C552, C555: 10nF; SM0402
C551, C554: 4.7uF; SM0805
C553, C556: 100pF; SM0402
C557: 100nF; SM0402
C558: 10pF; SM0402
L501, L514: BLM18; SM0603
R503: 50; SM0402
R509, R510, R511, R512, R513, R514: 1k; SM0402
R515: 0; SM0402
U506: ADS131M03_TSSOP; TSSOP20_5.8W

Connections:
+3.3VA: C551.1, C554.2, L501.2, L514.2; also elsewhere on the board
/ADC/A0_N: R510.1; also elsewhere on the board
/ADC/A0_P: R509.1; also elsewhere on the board
/ADC/A1_N: R511.1; also elsewhere on the board
/ADC/A1_P: R512.1; also elsewhere on the board
/ADC/A2_N: R514.1; also elsewhere on the board
/ADC/A2_P: R513.1; also elsewhere on the board
/ADC/DIN: U506.16 (DIN); also elsewhere on the board
/ADC/DOUT: U506.15 (DOUT); also elsewhere on the board
/ADC/SCLK: U506.14 (SCLK); also elsewhere on the board
/ADC/~CS: U506.12 (~CS); also elsewhere on the board
/ADC/~DRDY: U506.13 (~DRDY); also elsewhere on the board
/ADC/~SYNC/RST: U506.11 (~SYNC/RESET); also elsewhere on the board
/ADC_CLK: R515.2; also elsewhere on the board
GND: C551.2, C552.2, C553.1, C554.1, C555.2, C556.1, C557.1, C558.1, R503.1, U506.2 (AGND), U506.19 (DGND); also elsewhere on the board
unnamed: C548.1, R510.2, U506.4 (A0_N)
unnamed: C548.2, R509.2, U506.3 (A0_P)
unnamed: C549.1, R512.2, U506.6 (A1_P)
unnamed: C549.2, R511.2, U506.5 (A1_N)
unnamed: C550.1, R514.2, U506.8 (A2_N)
unnamed: C550.2, R513.2, U506.7 (A2_P)
unnamed: C552.1, C553.2, L501.1, U506.1 (AVDD)
unnamed: C555.1, C556.2, L514.1, U506.20 (DVDD)
unnamed: C557.2, U506.18 (CAP)
unnamed: C558.2, R503.2, R515.1, U506.17 (CLKIN)

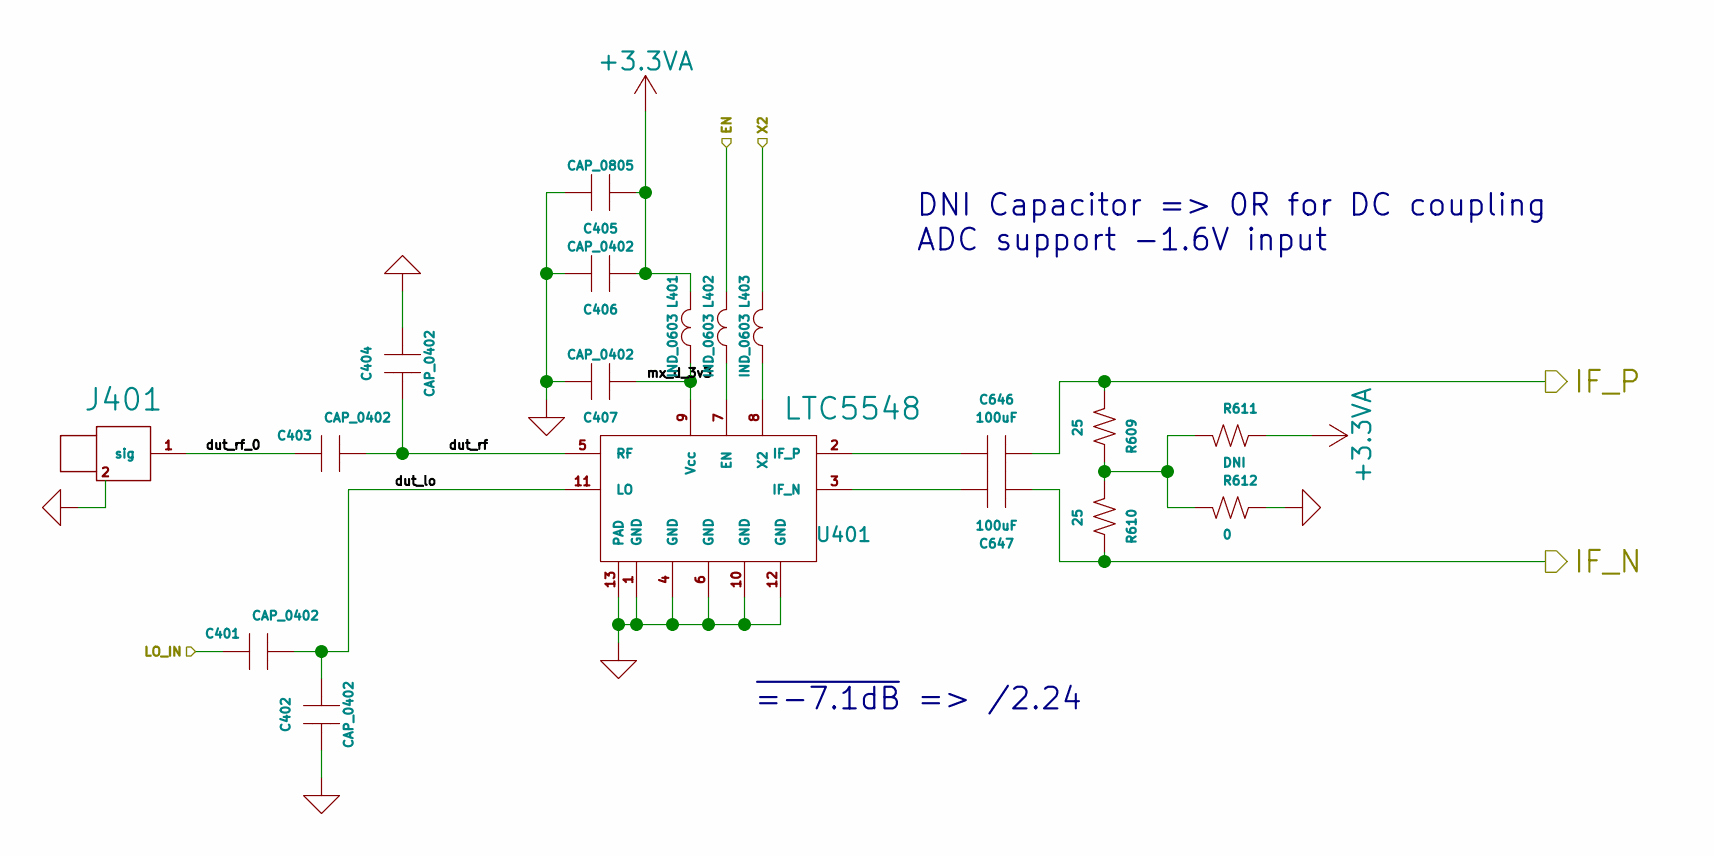
[picture p27: schematic mixer_1.kicad_sch]

Parts:
C401, C402, C403, C404, C406, C407: CAP_0402; SM0402
C405: CAP_0805; SM0805
C646, C647: 100uF; SM0805
J401: SMA_PCB; SMA_AMP_132255-12
L401, L402, L403: IND_0603; SM0603
R609, R610: 25; SM0402
R611: DNI; SM0402
R612: 0; SM0402
U401: LTC5548; QFN12_2x3mm_UDB_LT

Connections:
+3.3VA: C405.2, C406.2, L401.2, R611.1; also elsewhere on the board
/ADC/A2_N: C647.2, R610.1; also elsewhere on the board
/ADC/A2_P: C646.2, R609.2; also elsewhere on the board
/Mixer DUT/EN: L402.2
/Mixer DUT/X2: L403.2
/Mixer DUT/dut_lo: C401.2, C402.1, U401.11 (LO)
/Mixer DUT/dut_rf: C403.2, C404.2, U401.5 (RF)
/Mixer DUT/dut_rf_0: C403.1, J401.1 (sig)
/Mixer DUT/mx_d_3v3: C407.2, L401.1, U401.9 (Vcc)
/PLL/LO_0: C401.1; also elsewhere on the board
GND: C402.2, C404.1, C405.1, C406.1, C407.1, J401.2, R612.1, U401.1 (GND), U401.4 (GND), U401.6 (GND), U401.10 (GND), U401.12 (GND), U401.13 (PAD); also elsewhere on the board
unnamed: C646.1, U401.2 (IF_P)
unnamed: C647.1, U401.3 (IF_N)
unnamed: L402.1, U401.7 (EN)
unnamed: L403.1, U401.8 (X2)
unnamed: R609.1, R610.2, R611.2, R612.2

Notes on the sheet:
DNI Capacitor => 0R for DC coupling ADC support -1.6V input
~{=-7.1dB} => /2.24

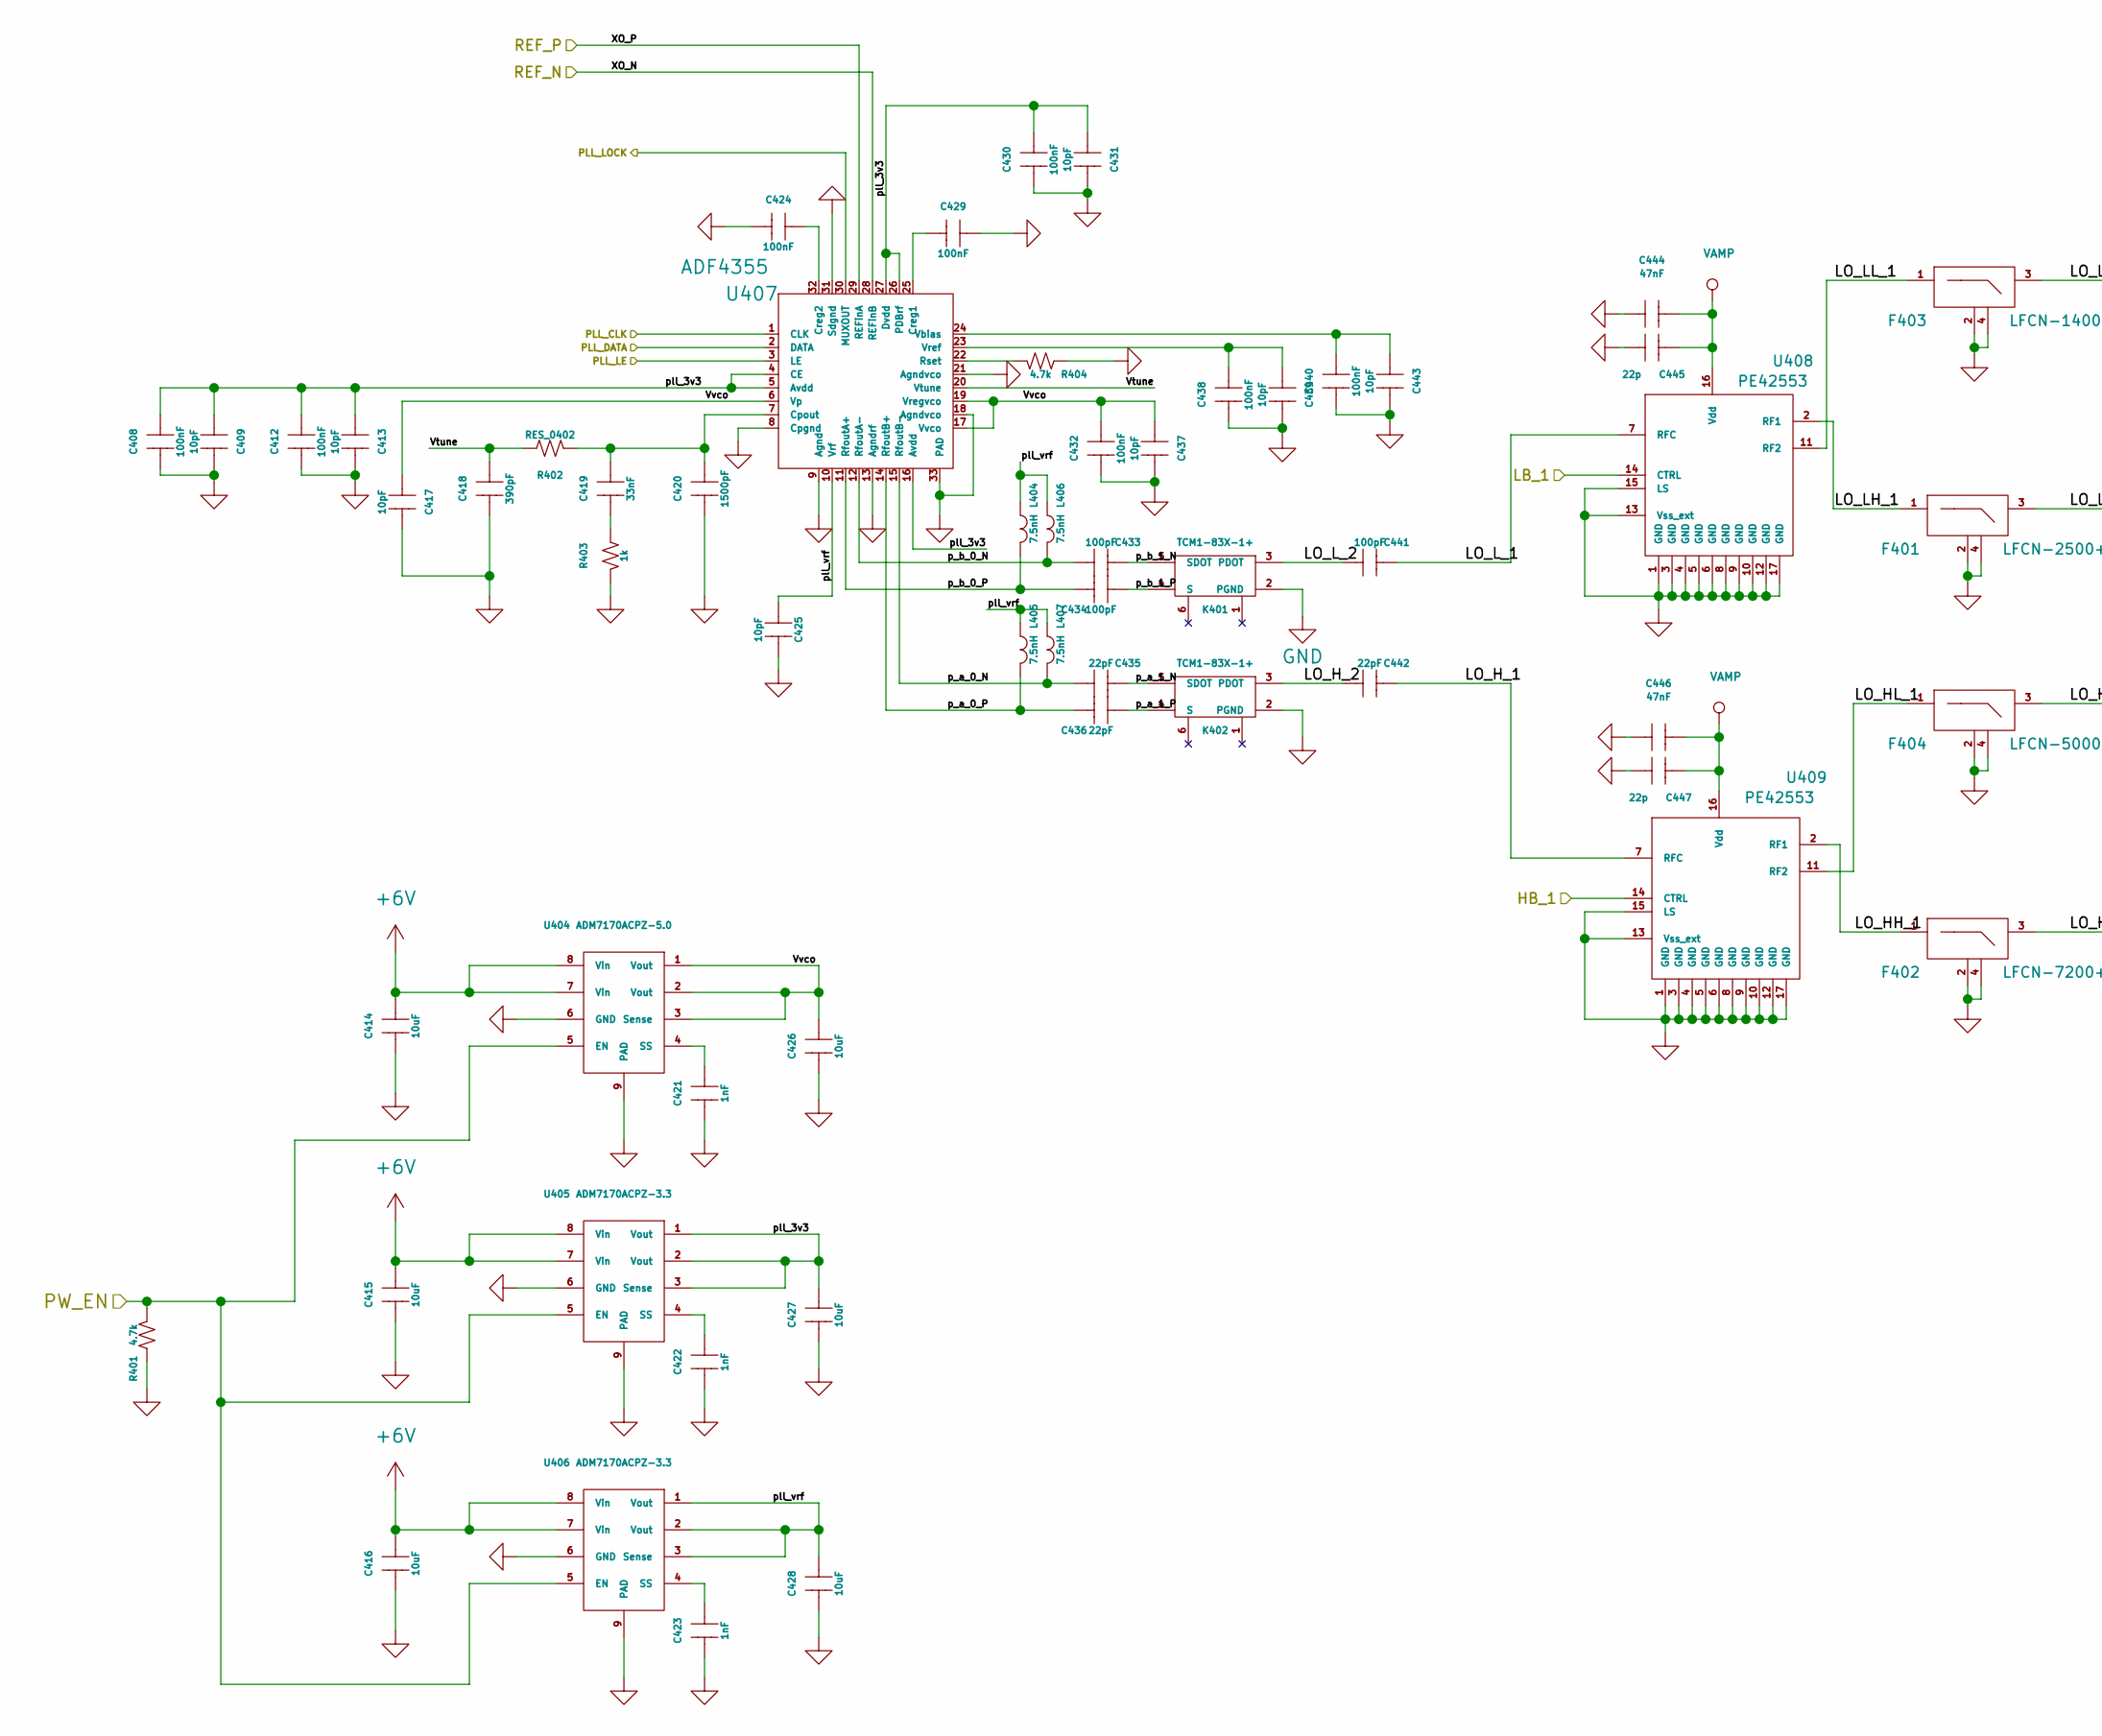
[picture p28: schematic ad4355.kicad_sch, part in row 1, column 1]

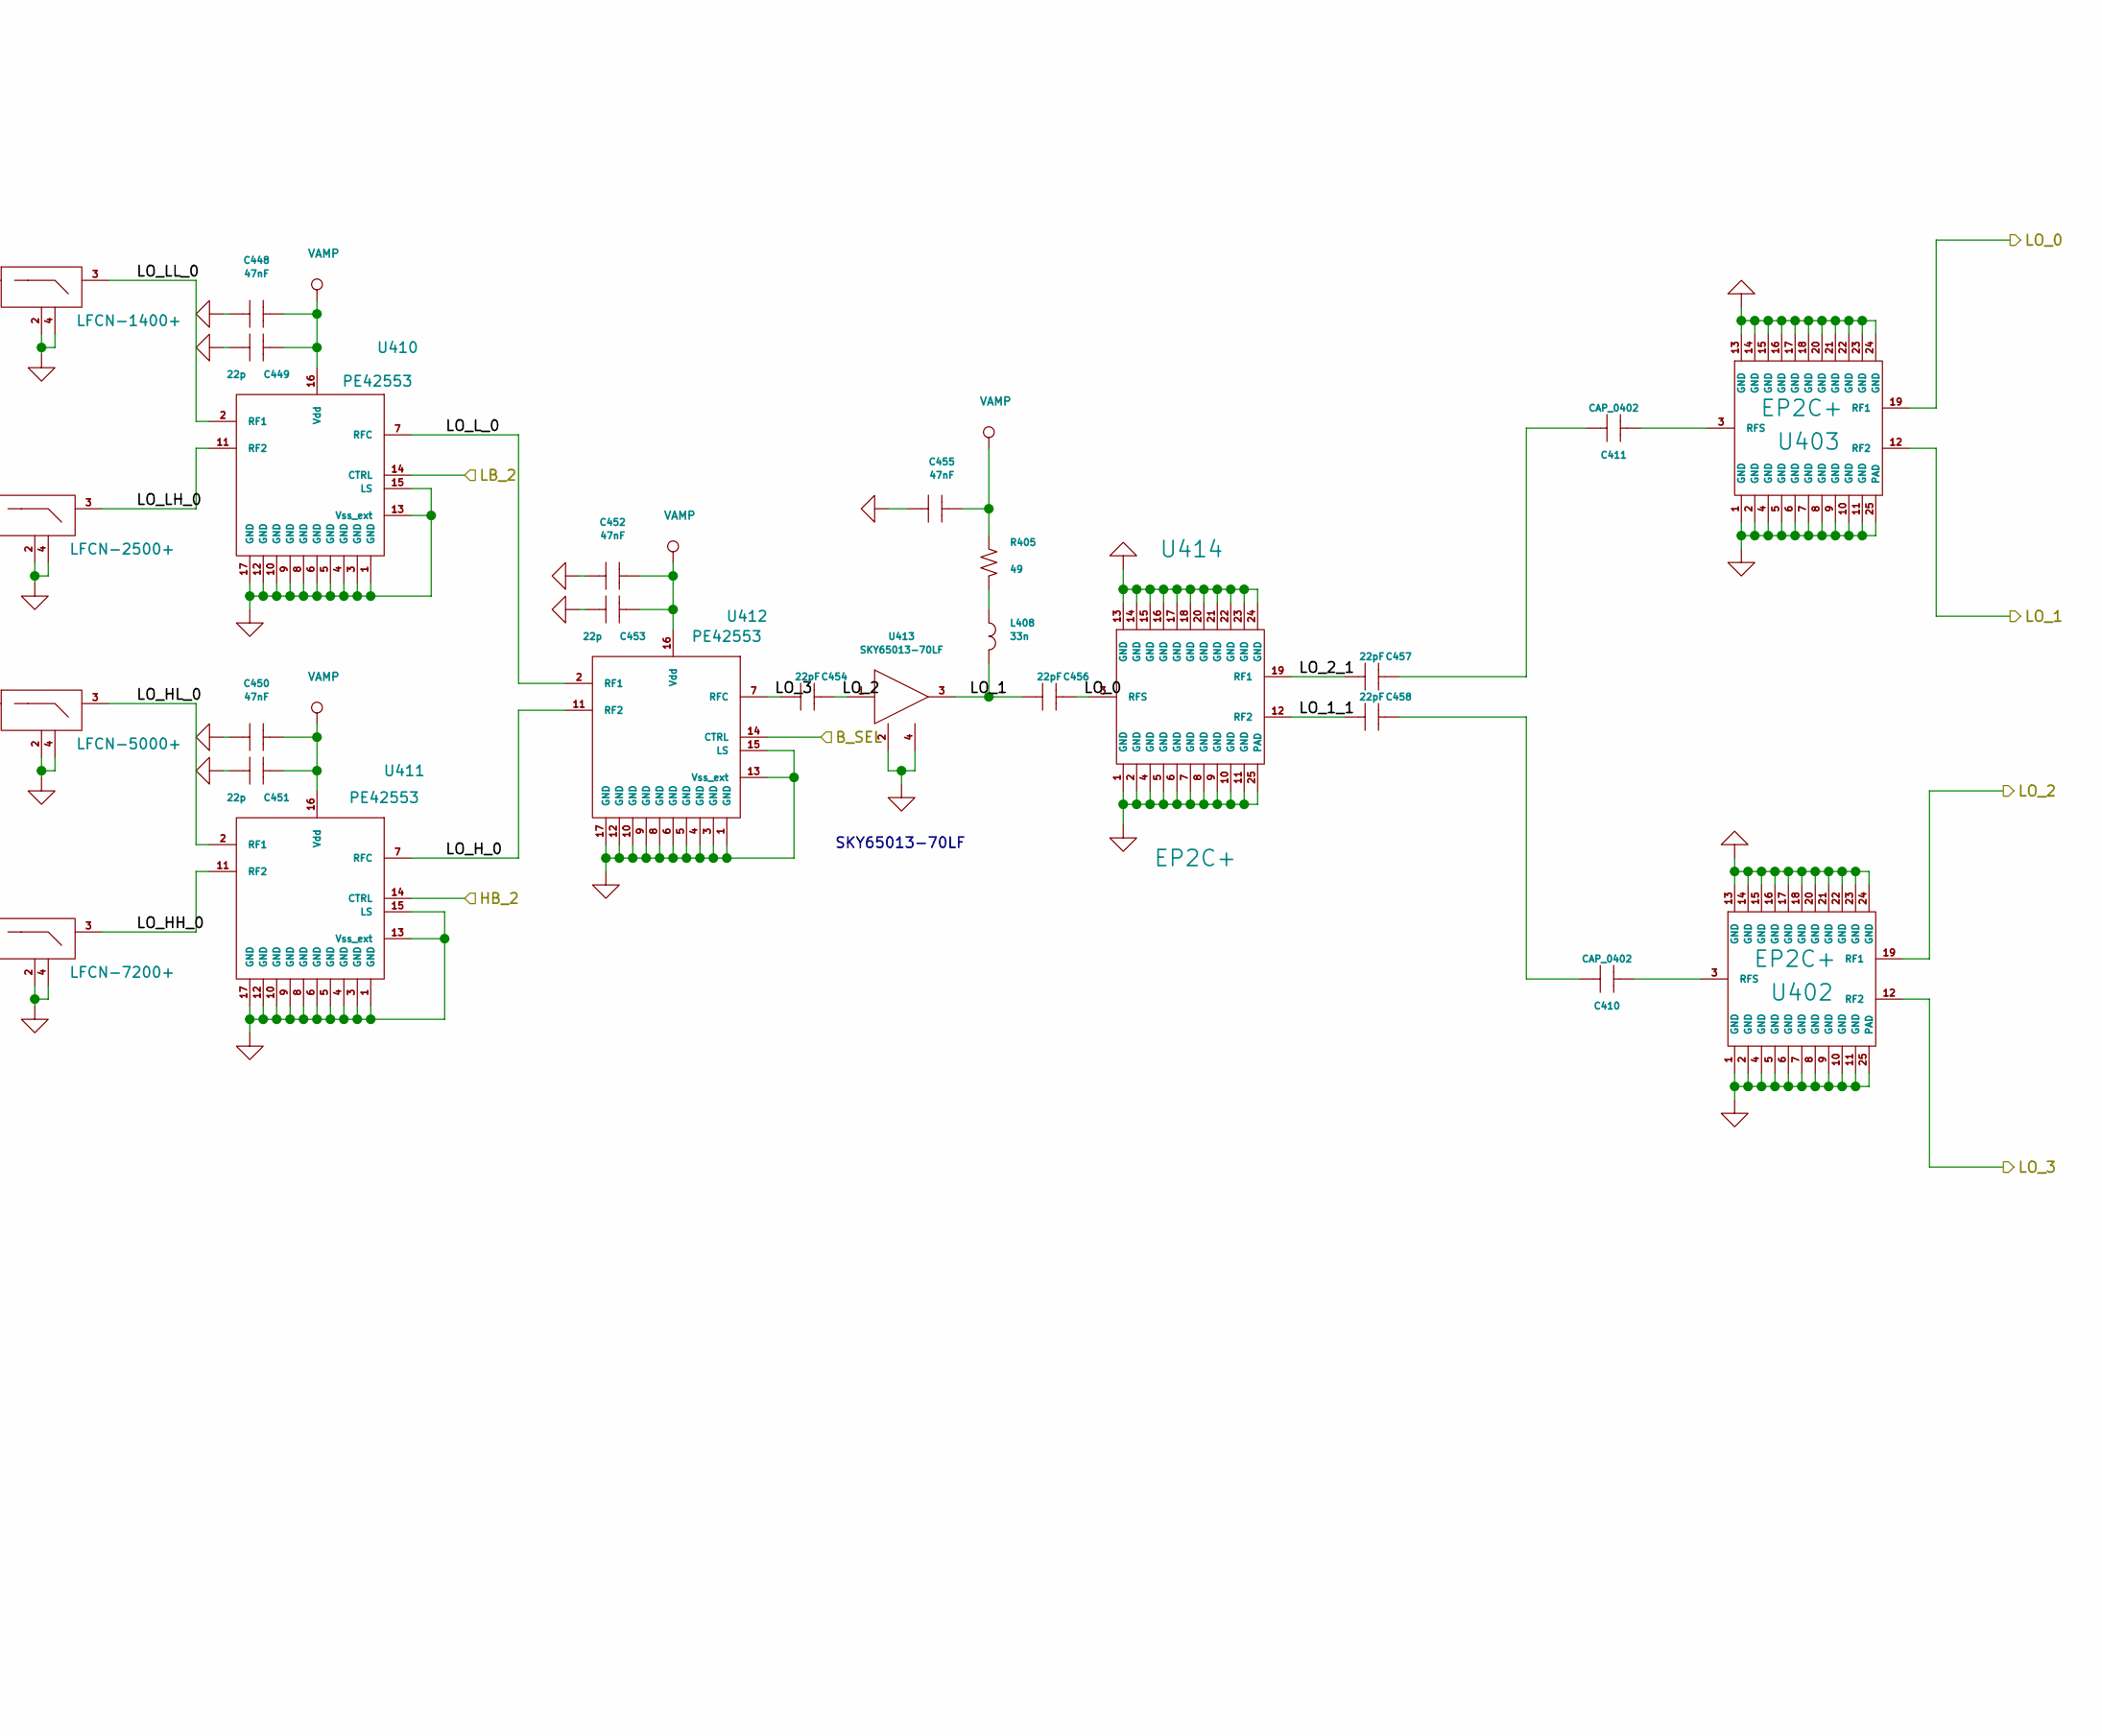
[picture p29: schematic ad4355.kicad_sch, part in row 1, column 2]

Parts:
C408, C412, C424, C429, C430, C432, C438, C440: 100nF; SM0402
C409, C413, C417, C425, C431, C437, C439, C443: 10pF; SM0402
C410, C411: CAP_0402; SM0402
C414, C415, C416, C426, C427, C428: 10uF; SM0805
C418: 390pF; SM0402
C419: 33nF; SM0402
C420: 1500pF; SM0402
C421, C422, C423: 1nF; SM0603
C433, C434, C441: 100pF; SM0402
C435, C436, C442, C454, C456, C457, C458: 22pF; SM0402
C444, C446, C448, C450, C452, C455: 47nF; SM0603
C445, C447, C449, C451, C453: 22p; SM0402
F401: LFCN-2500+; FV1206
F402: LFCN-7200+; FV1206
F403: LFCN-1400+; FV1206
F404: LFCN-5000+; FV1206
K401, K402: TCM1-83X-1+; DB1627
L404, L405, L406, L407: 7.5nH; SM0402
L408: 33n; SM0603
R401, R404: 4.7k; SM0402
R402: RES_0402; SM0402
R403: 1k; SM0402
R405: 49; SM0603
U402, U403, U414: EP2C+; QFN24_4x4_0.5mm
U404: ADM7170ACPZ-5.0; DFN8_3x3mm
U405, U406: ADM7170ACPZ-3.3; DFN8_3x3mm
U407: ADF4355; QFN32_5x5mm_3.6mm
U408, U409, U410, U411, U412: PE42553; QFN-16_EP_3x3_Pitch0.5mm
U413: SKY65013-70LF; SOT89-SKY65013-70

Connections:
+6V: C414.1, C415.1, C416.1, U404.7 (Vin), U404.8 (Vin), U405.7 (Vin), U405.8 (Vin), U406.7 (Vin), U406.8 (Vin); also elsewhere on the board
/ANALOG_EN: R401.2, U404.5 (EN), U405.5 (EN), U406.5 (EN); also elsewhere on the board
/FPGA/LO_CLK: U407.1 (CLK); also elsewhere on the board
/FPGA/LO_DATA: U407.2 (DATA); also elsewhere on the board
/FPGA/LO_LE: U407.3 (LE); also elsewhere on the board
/FPGA/LO_LOCK: U407.30 (MUXOUT); also elsewhere on the board
/LO_BANDSEL: U412.14 (CTRL); also elsewhere on the board
/LO_HB1: U409.14 (CTRL); also elsewhere on the board
/LO_HB2: U411.14 (CTRL); also elsewhere on the board
/LO_LB1: U408.14 (CTRL); also elsewhere on the board
/LO_LB2: U410.14 (CTRL); also elsewhere on the board
/PLL/LO_0: C456.2, U403.19 (RF1), U414.3 (RFS); also elsewhere on the board
/PLL/LO_1: C456.1, L408.2, U403.12 (RF2), U413.3 (OUT); also elsewhere on the board
/PLL/LO_1_1: C458.1, U414.12 (RF2)
/PLL/LO_2: C454.2, U402.19 (RF1), U413.1 (IN); also elsewhere on the board
/PLL/LO_2_1: C457.1, U414.19 (RF1)
/PLL/LO_3: C454.1, U402.12 (RF2), U412.7 (RFC); also elsewhere on the board
/PLL/LO_HH_0: F402.3 (RFOUT), U411.11 (RF2)
/PLL/LO_HH_1: F402.1 (RFIN), U409.2 (RF1)
/PLL/LO_HL_0: F404.3 (RFOUT), U411.2 (RF1)
/PLL/LO_HL_1: F404.1 (RFIN), U409.11 (RF2)
/PLL/LO_H_0: U411.7 (RFC), U412.11 (RF2)
/PLL/LO_H_1: C442.2, U409.7 (RFC)
/PLL/LO_H_2: C442.1, K402.3 (PDOT)
/PLL/LO_LH_0: F401.3 (RFOUT), U410.11 (RF2)
/PLL/LO_LH_1: F401.1 (RFIN), U408.2 (RF1)
/PLL/LO_LL_0: F403.3 (RFOUT), U410.2 (RF1)
/PLL/LO_LL_1: F403.1 (RFIN), U408.11 (RF2)
/PLL/LO_L_0: U410.7 (RFC), U412.2 (RF1)
/PLL/LO_L_1: C441.2, U408.7 (RFC)
/PLL/LO_L_2: C441.1, K401.3 (PDOT)
/PLL/Vtune: C418.1, R402.1, U407.20 (Vtune)
/PLL/Vvco: C417.1, C426.1, C432.1, C437.1, U404.1 (Vout), U404.2 (Vout), U404.3 (Sense), U407.6 (Vp), U407.17 (Vvco), U407.19 (Vregvco)
/PLL/XO_N: U407.28 (REFinB); also elsewhere on the board
/PLL/XO_P: U407.29 (REFinA); also elsewhere on the board
/PLL/p_a_0_N: C435.1, L407.2, U407.15 (RfoutB-)
/PLL/p_a_0_P: C436.2, L405.2, U407.14 (RfoutB+)
/PLL/p_a_1_N: C435.2, K402.5 (SDOT)
/PLL/p_a_1_P: C436.1, K402.4 (S)
/PLL/p_b_0_N: C433.1, L406.2, U407.12 (RfoutA-)
/PLL/p_b_0_P: C434.2, L404.2, U407.11 (RfoutA+)
/PLL/p_b_1_N: C433.2, K401.5 (SDOT)
/PLL/p_b_1_P: C434.1, K401.4 (S)
/PLL/pll_3v3: C408.1, C409.1, C412.1, C413.1, C427.1, C430.1, C431.1, U405.1 (Vout), U405.2 (Vout), U405.3 (Sense), U407.4 (CE), U407.5 (Avdd), U407.16 (Avdd), U407.26 (PDBrf), U407.27 (Dvdd)
/PLL/pll_vrf: C425.1, C428.1, L404.1, L405.1, L406.1, L407.1, U406.1 (Vout), U406.2 (Vout), U406.3 (Sense), U407.10 (Vrf)
GND: C408.2, C409.2, C412.2, C413.2, C414.2, C415.2, C416.2, C417.2, C418.2, C420.2, C421.2, C422.2, C423.2, C424.2, C425.2, C426.2, C427.2, C428.2, C429.1, C430.2, C431.2, C432.2, C437.2, C438.2, C439.2, C440.2, C443.2, C444.1, C445.1, C446.1, C447.1, C448.1, C449.1, C450.1, C451.1, C452.1, C453.1, C455.1, F401.2 (GND), F401.4 (GND), F402.2 (GND), F402.4 (GND), F403.2 (GND), F403.4 (GND), F404.2 (GND), F404.4 (GND), K401.2 (PGND), K402.2 (PGND), R401.1, R403.2, R404.1, U402.1 (GND), U402.2 (GND), U402.4 (GND), U402.5 (GND), U402.6 (GND), U402.7 (GND), U402.8 (GND), U402.9 (GND), U402.10 (GND), U402.11 (GND), U402.13 (GND), U402.14 (GND), U402.15 (GND), U402.16 (GND), U402.17 (GND), U402.18 (GND), U402.20 (GND), U402.21 (GND), U402.22 (GND), U402.23 (GND), U402.24 (GND), U402.25 (PAD), U403.1 (GND), U403.2 (GND), U403.4 (GND), U403.5 (GND), U403.6 (GND), U403.7 (GND), U403.8 (GND), U403.9 (GND), U403.10 (GND), U403.11 (GND), U403.13 (GND), U403.14 (GND), U403.15 (GND), U403.16 (GND), U403.17 (GND), U403.18 (GND), U403.20 (GND), U403.21 (GND), U403.22 (GND), U403.23 (GND), U403.24 (GND), U403.25 (PAD), U404.6 (GND), U404.9 (PAD), U405.6 (GND), U405.9 (PAD), U406.6 (GND), U406.9 (PAD), U407.8 (Cpgnd), U407.9 (Agnd), U407.13 (Agndrf), U407.18 (Agndvco), U407.21 (Agndvco), U407.31 (Sdgnd), U407.33 (PAD), U408.1 (GND), U408.3 (GND), U408.4 (GND), U408.5 (GND), U408.6 (GND), U408.8 (GND), U408.9 (GND), U408.10 (GND), U408.12 (GND), U408.13 (Vss_ext), U408.15 (LS), U408.17 (GND), U409.1 (GND), U409.3 (GND), U409.4 (GND), U409.5 (GND), U409.6 (GND), U409.8 (GND), U409.9 (GND), U409.10 (GND), U409.12 (GND), U409.13 (Vss_ext), U409.15 (LS), U409.17 (GND), U410.1 (GND), U410.3 (GND), U410.4 (GND), U410.5 (GND), U410.6 (GND), U410.8 (GND), U410.9 (GND), U410.10 (GND), U410.12 (GND), U410.13 (Vss_ext), U410.15 (LS), U410.17 (GND), U411.1 (GND), U411.3 (GND), U411.4 (GND), U411.5 (GND), U411.6 (GND), U411.8 (GND), U411.9 (GND), U411.10 (GND), U411.12 (GND), U411.13 (Vss_ext), U411.15 (LS), U411.17 (GND), U412.1 (GND), U412.3 (GND), U412.4 (GND), U412.5 (GND), U412.6 (GND), U412.8 (GND), U412.9 (GND), U412.10 (GND), U412.12 (GND), U412.13 (Vss_ext), U412.15 (LS), U412.17 (GND), U413.2 (GND), U413.4 (GND), U414.1 (GND), U414.2 (GND), U414.4 (GND), U414.5 (GND), U414.6 (GND), U414.7 (GND), U414.8 (GND), U414.9 (GND), U414.10 (GND), U414.11 (GND), U414.13 (GND), U414.14 (GND), U414.15 (GND), U414.16 (GND), U414.17 (GND), U414.18 (GND), U414.20 (GND), U414.21 (GND), U414.22 (GND), U414.23 (GND), U414.24 (GND), U414.25 (PAD); also elsewhere on the board
unnamed: C410.1, C458.2
unnamed: C410.2, U402.3 (RFS)
unnamed: C411.1, C457.2
unnamed: C411.2, U403.3 (RFS)
unnamed: C419.1, C420.1, R402.2, U407.7 (Cpout)
unnamed: C419.2, R403.1
unnamed: C421.1, U404.4 (SS)
unnamed: C422.1, U405.4 (SS)
unnamed: C423.1, U406.4 (SS)
unnamed: C424.1, U407.32 (Creg2)
unnamed: C429.2, U407.25 (Creg1)
unnamed: C438.1, C439.1, U407.23 (Vref)
unnamed: C440.1, C443.1, U407.24 (Vbias)
unnamed: L408.1, R405.2
unnamed: R404.2, U407.22 (Rset)
VAMP: C444.2, C445.2, C446.2, C447.2, C448.2, C449.2, C450.2, C451.2, C452.2, C453.2, C455.2, R405.1, U408.16 (Vdd), U409.16 (Vdd), U410.16 (Vdd), U411.16 (Vdd), U412.16 (Vdd); also elsewhere on the board

Notes on the sheet:
SKY65013-70LF
