natsfr/VNAV1.2/board/VNAV1/adccore.kicad_pcb

## KiCad design board/VNAV1/adccore.kicad_pcb (continued)

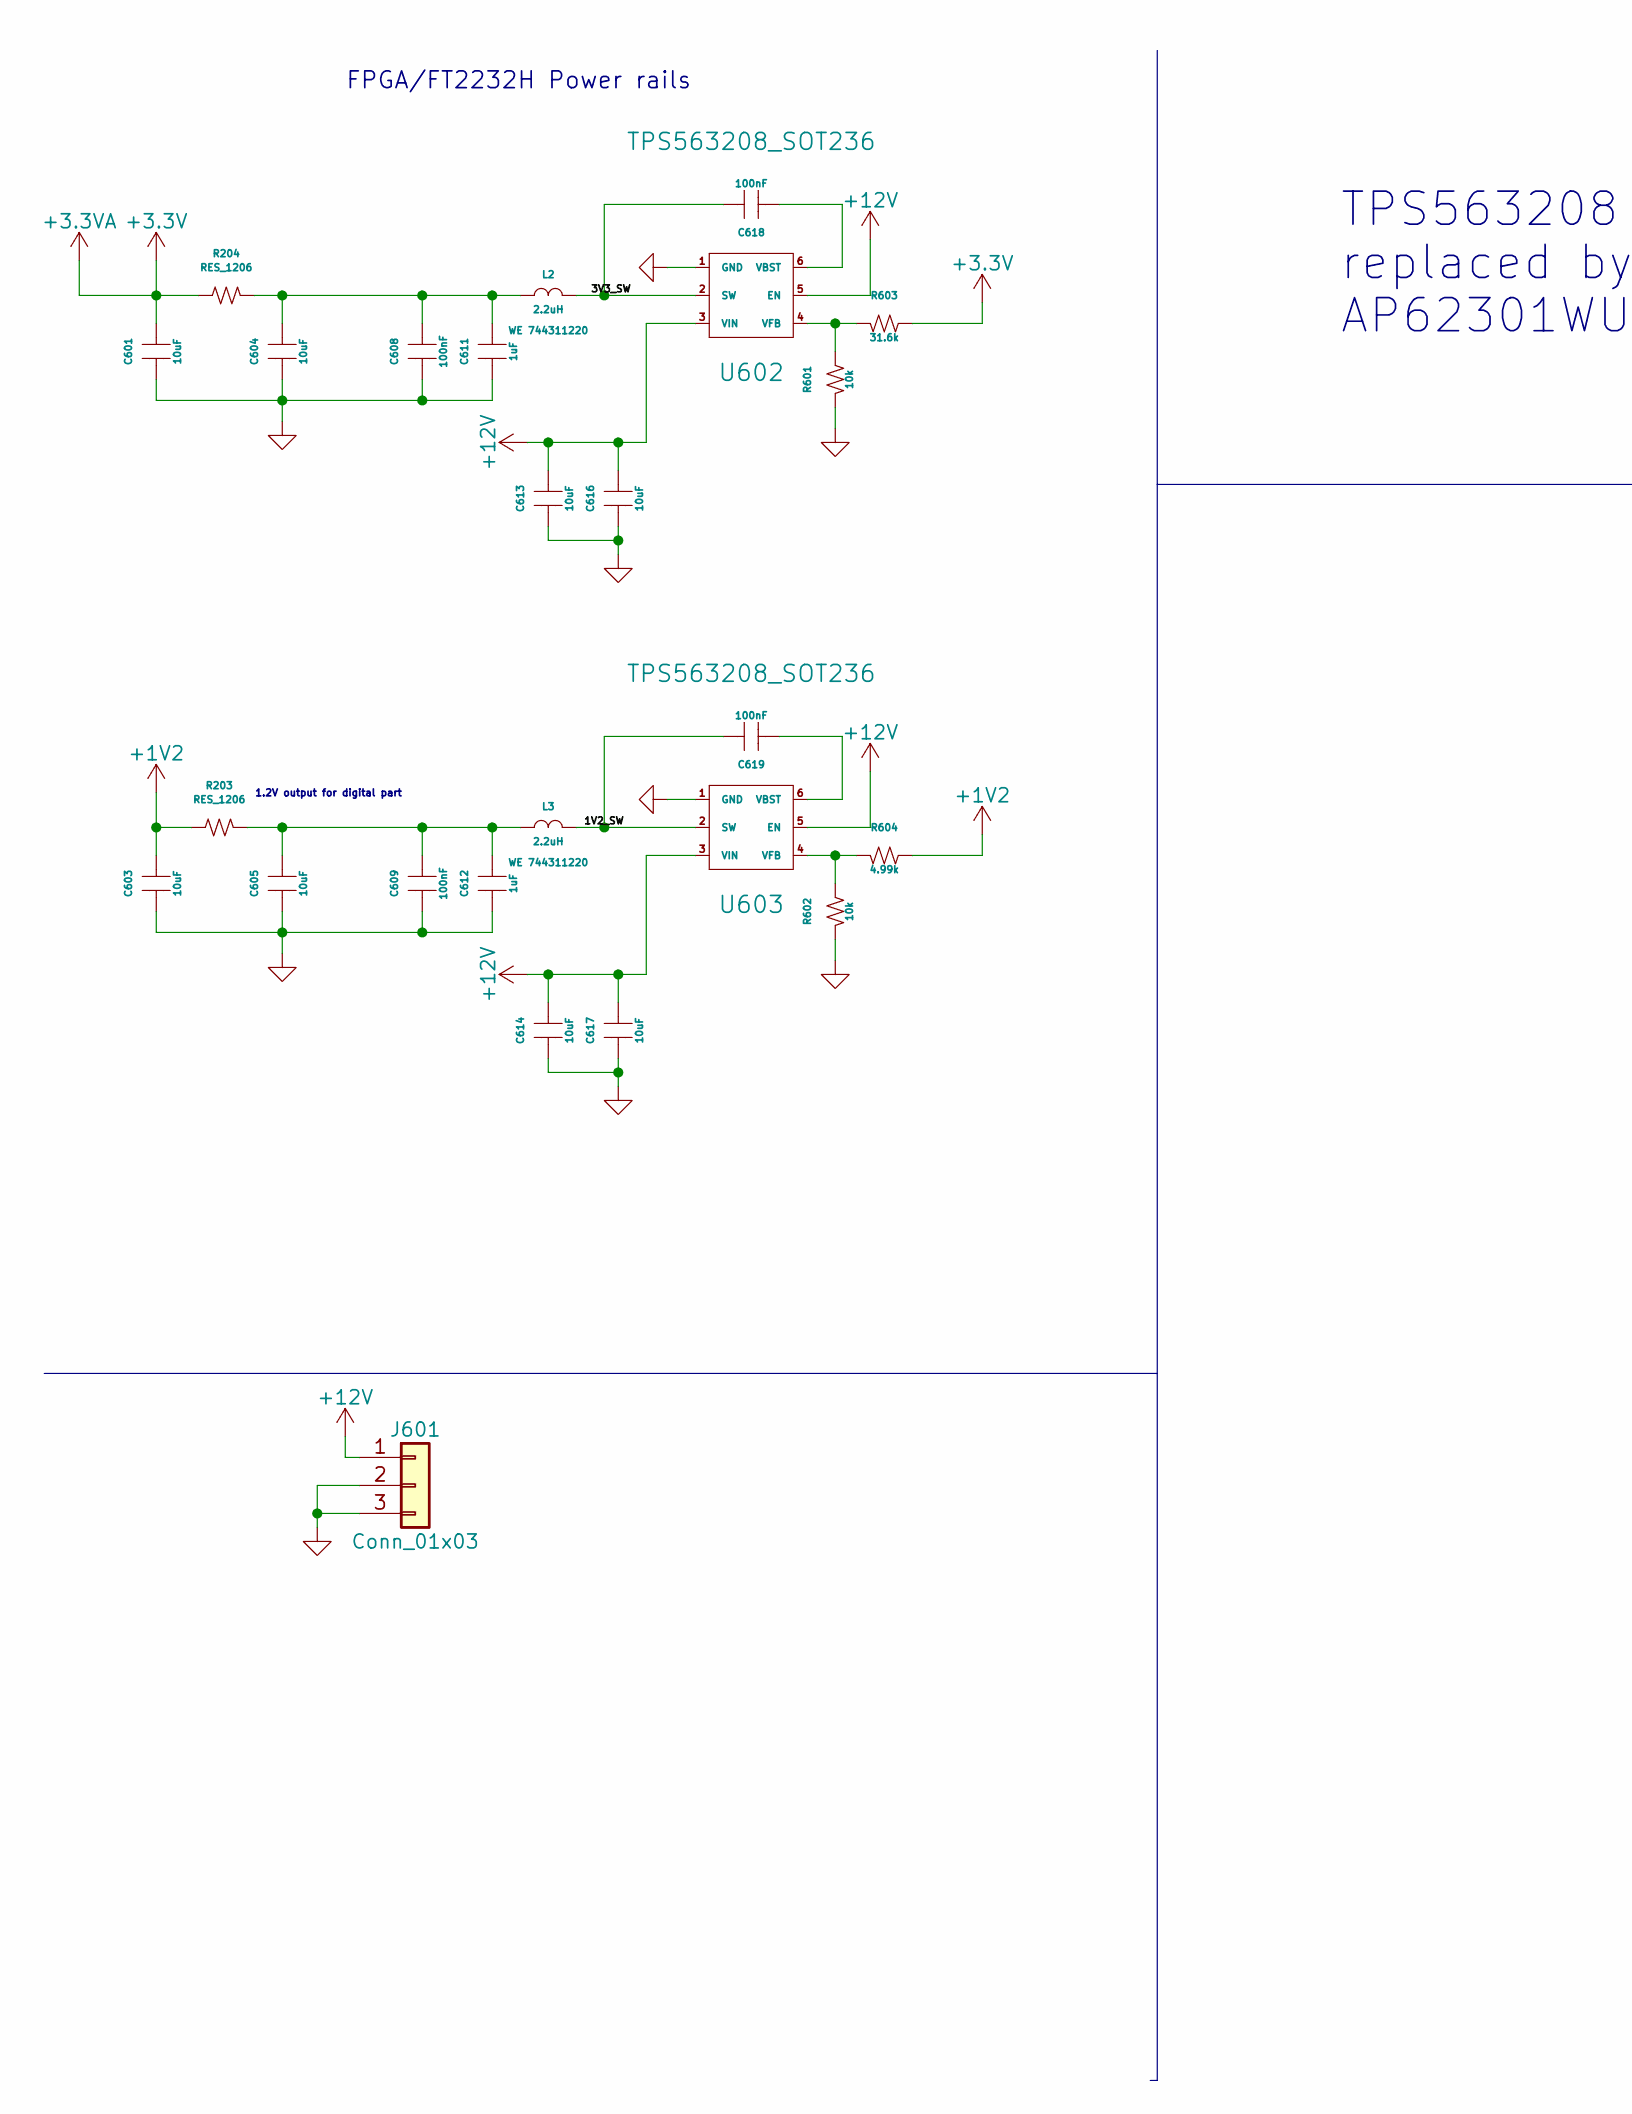
[picture p30: schematic psu.kicad_sch, part in row 1, column 1]

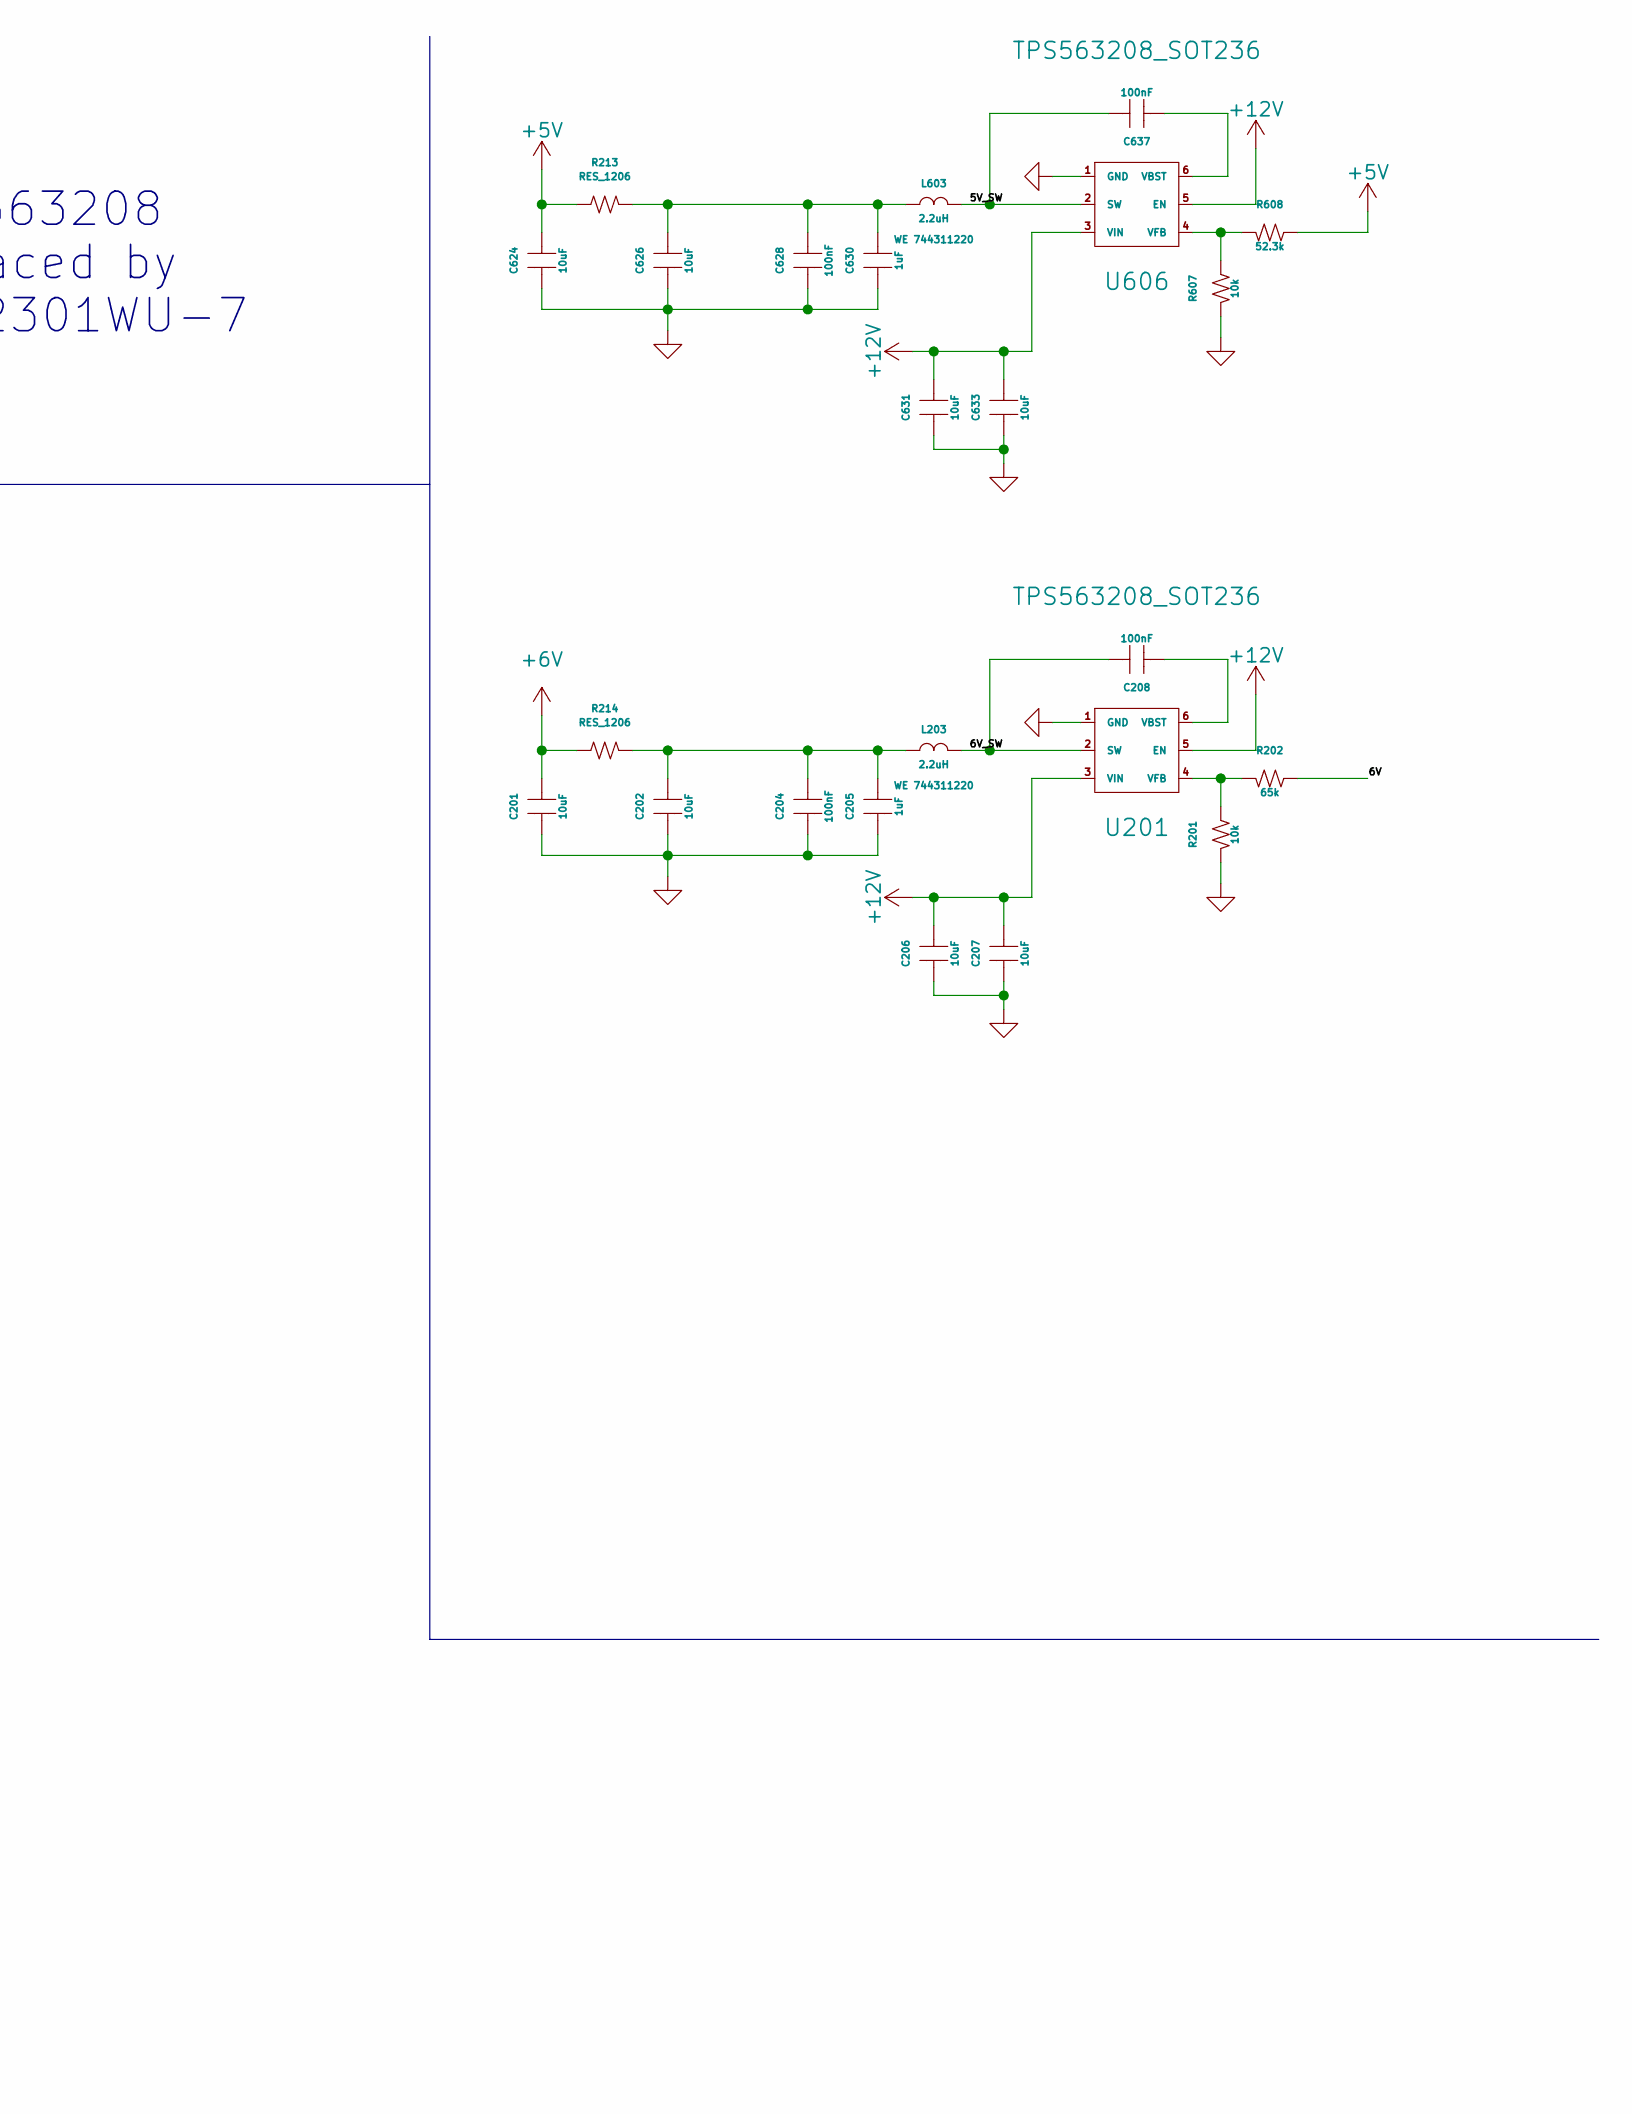
[picture p31: schematic psu.kicad_sch, part in row 1, column 2]

Parts:
C201, C202, C206, C207, C601, C603, C604, C605, C613, C614, C616, C617, C624, C626, C631, C633: 10uF; SM1206
C204, C608, C609, C628: 100nF; SM0805
C205, C611, C612, C630: 1uF; SM0805
C208, C618, C619, C637: 100nF; SM0603
J601: Conn_01x03; MICROFIT_3POS_FEM_43650-0303
L2, L3, L203, L603: 2.2uH; IND_7x7x4.5
R201, R601, R602, R607: 10k; SM0402
R202: 65k; SM0402
R203, R204, R213, R214: RES_1206; SM1206
R603: 31.6k; SM0402
R604: 4.99k; SM0402
R608: 52.3k; SM0402
U201, U602, U603, U606: TPS563208_SOT236; SOT-236-095mm

Connections:
+1V2: C603.1, R203.1, R604.1; also elsewhere on the board
+3.3VA: C601.1, R204.1, R603.1; also elsewhere on the board
+5V: C624.1, R213.1, R608.1
+6V: C201.1, R214.1; also elsewhere on the board
+12V: C206.1, C207.1, C613.1, C614.1, C616.1, C617.1, C631.1, C633.1, J601.1, U201.3 (VIN), U201.5 (EN), U602.3 (VIN), U602.5 (EN), U603.3 (VIN), U603.5 (EN), U606.3 (VIN), U606.5 (EN)
/PSU/1V2_SW: C619.1, L3.2, U603.2 (SW)
/PSU/3V3_SW: C618.1, L2.2, U602.2 (SW)
/PSU/5V_SW: C637.1, L603.2, U606.2 (SW)
/PSU/6V: R202.1
/PSU/6V_SW: C208.1, L203.2, U201.2 (SW)
GND: C201.2, C202.2, C204.2, C205.2, C206.2, C207.2, C601.2, C603.2, C604.2, C605.2, C608.2, C609.2, C611.2, C612.2, C613.2, C614.2, C616.2, C617.2, C624.2, C626.2, C628.2, C630.2, C631.2, C633.2, J601.2, J601.3, R201.2, R601.2, R602.2, R607.2, U201.1 (GND), U602.1 (GND), U603.1 (GND), U606.1 (GND); also elsewhere on the board
unnamed: C202.1, C204.1, C205.1, L203.1, R214.2
unnamed: C208.2, U201.6 (VBST)
unnamed: C604.1, C608.1, C611.1, L2.1, R204.2
unnamed: C605.1, C609.1, C612.1, L3.1, R203.2
unnamed: C618.2, U602.6 (VBST)
unnamed: C619.2, U603.6 (VBST)
unnamed: C626.1, C628.1, C630.1, L603.1, R213.2
unnamed: C637.2, U606.6 (VBST)
unnamed: R201.1, R202.2, U201.4 (VFB)
unnamed: R601.1, R603.2, U602.4 (VFB)
unnamed: R602.1, R604.2, U603.4 (VFB)
unnamed: R607.1, R608.2, U606.4 (VFB)

Notes on the sheet:
FPGA/FT2232H Power rails
1.2V output for digital part
TPS563208 replaced by AP62301WU-7
