natsfr/VNAV1.2/board/VNAV1/adccore.kicad_pcb

## KiCad design board/VNAV1/adccore.kicad_pcb (continued)

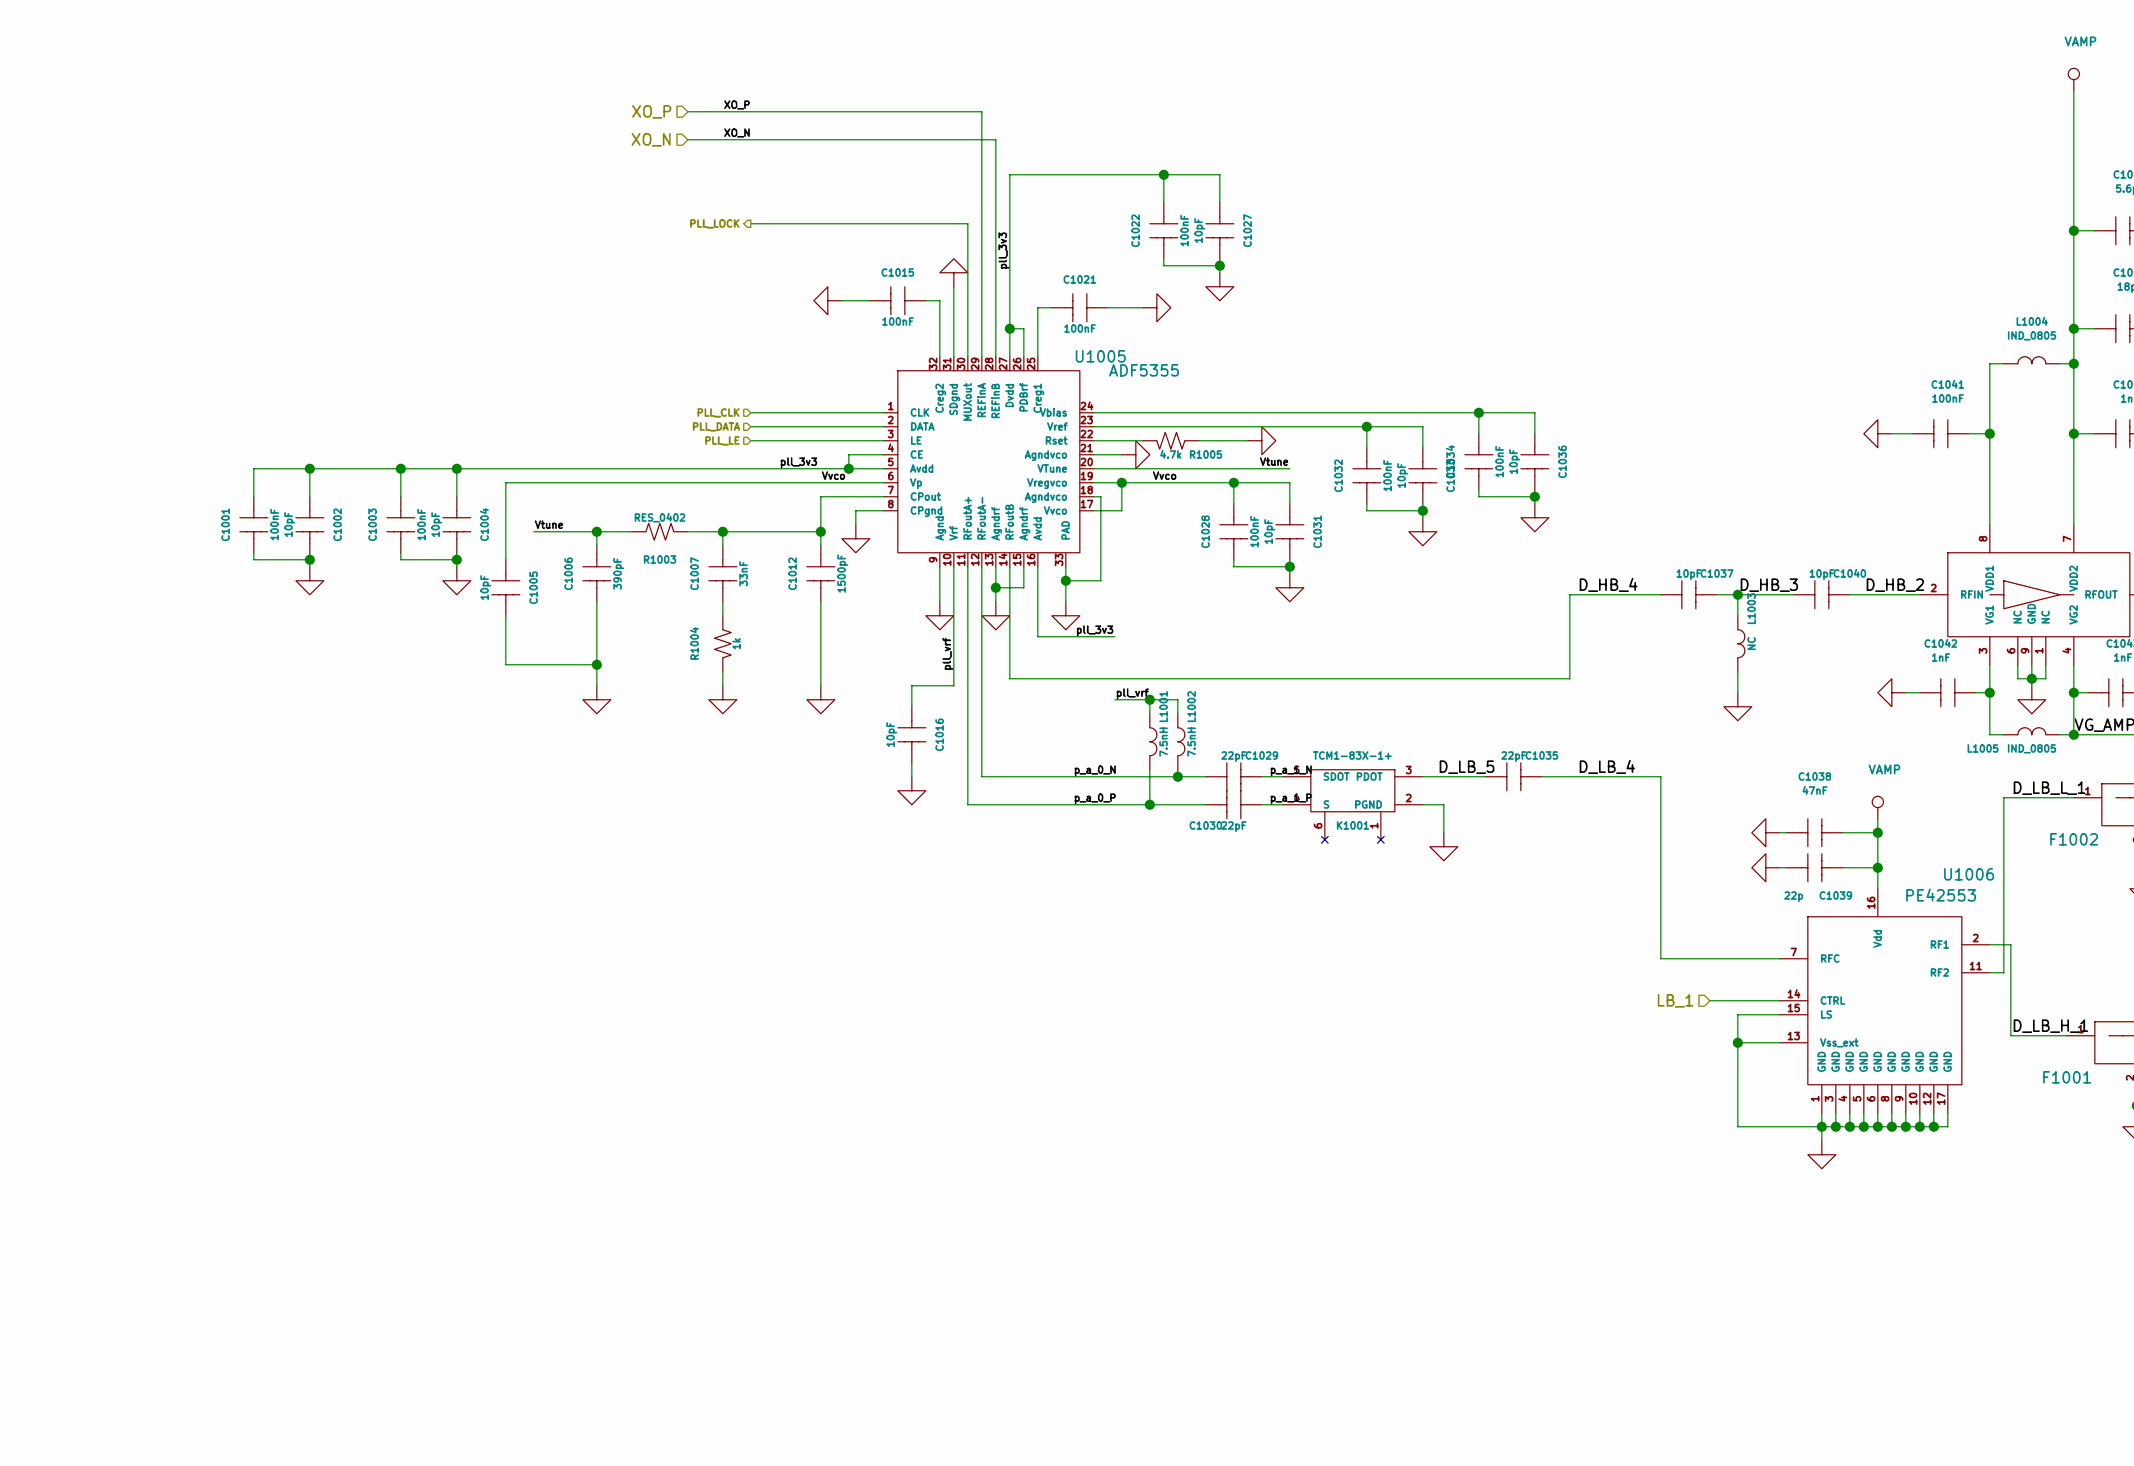
[picture p32: schematic ad5355.kicad_sch, part in row 1, column 1]

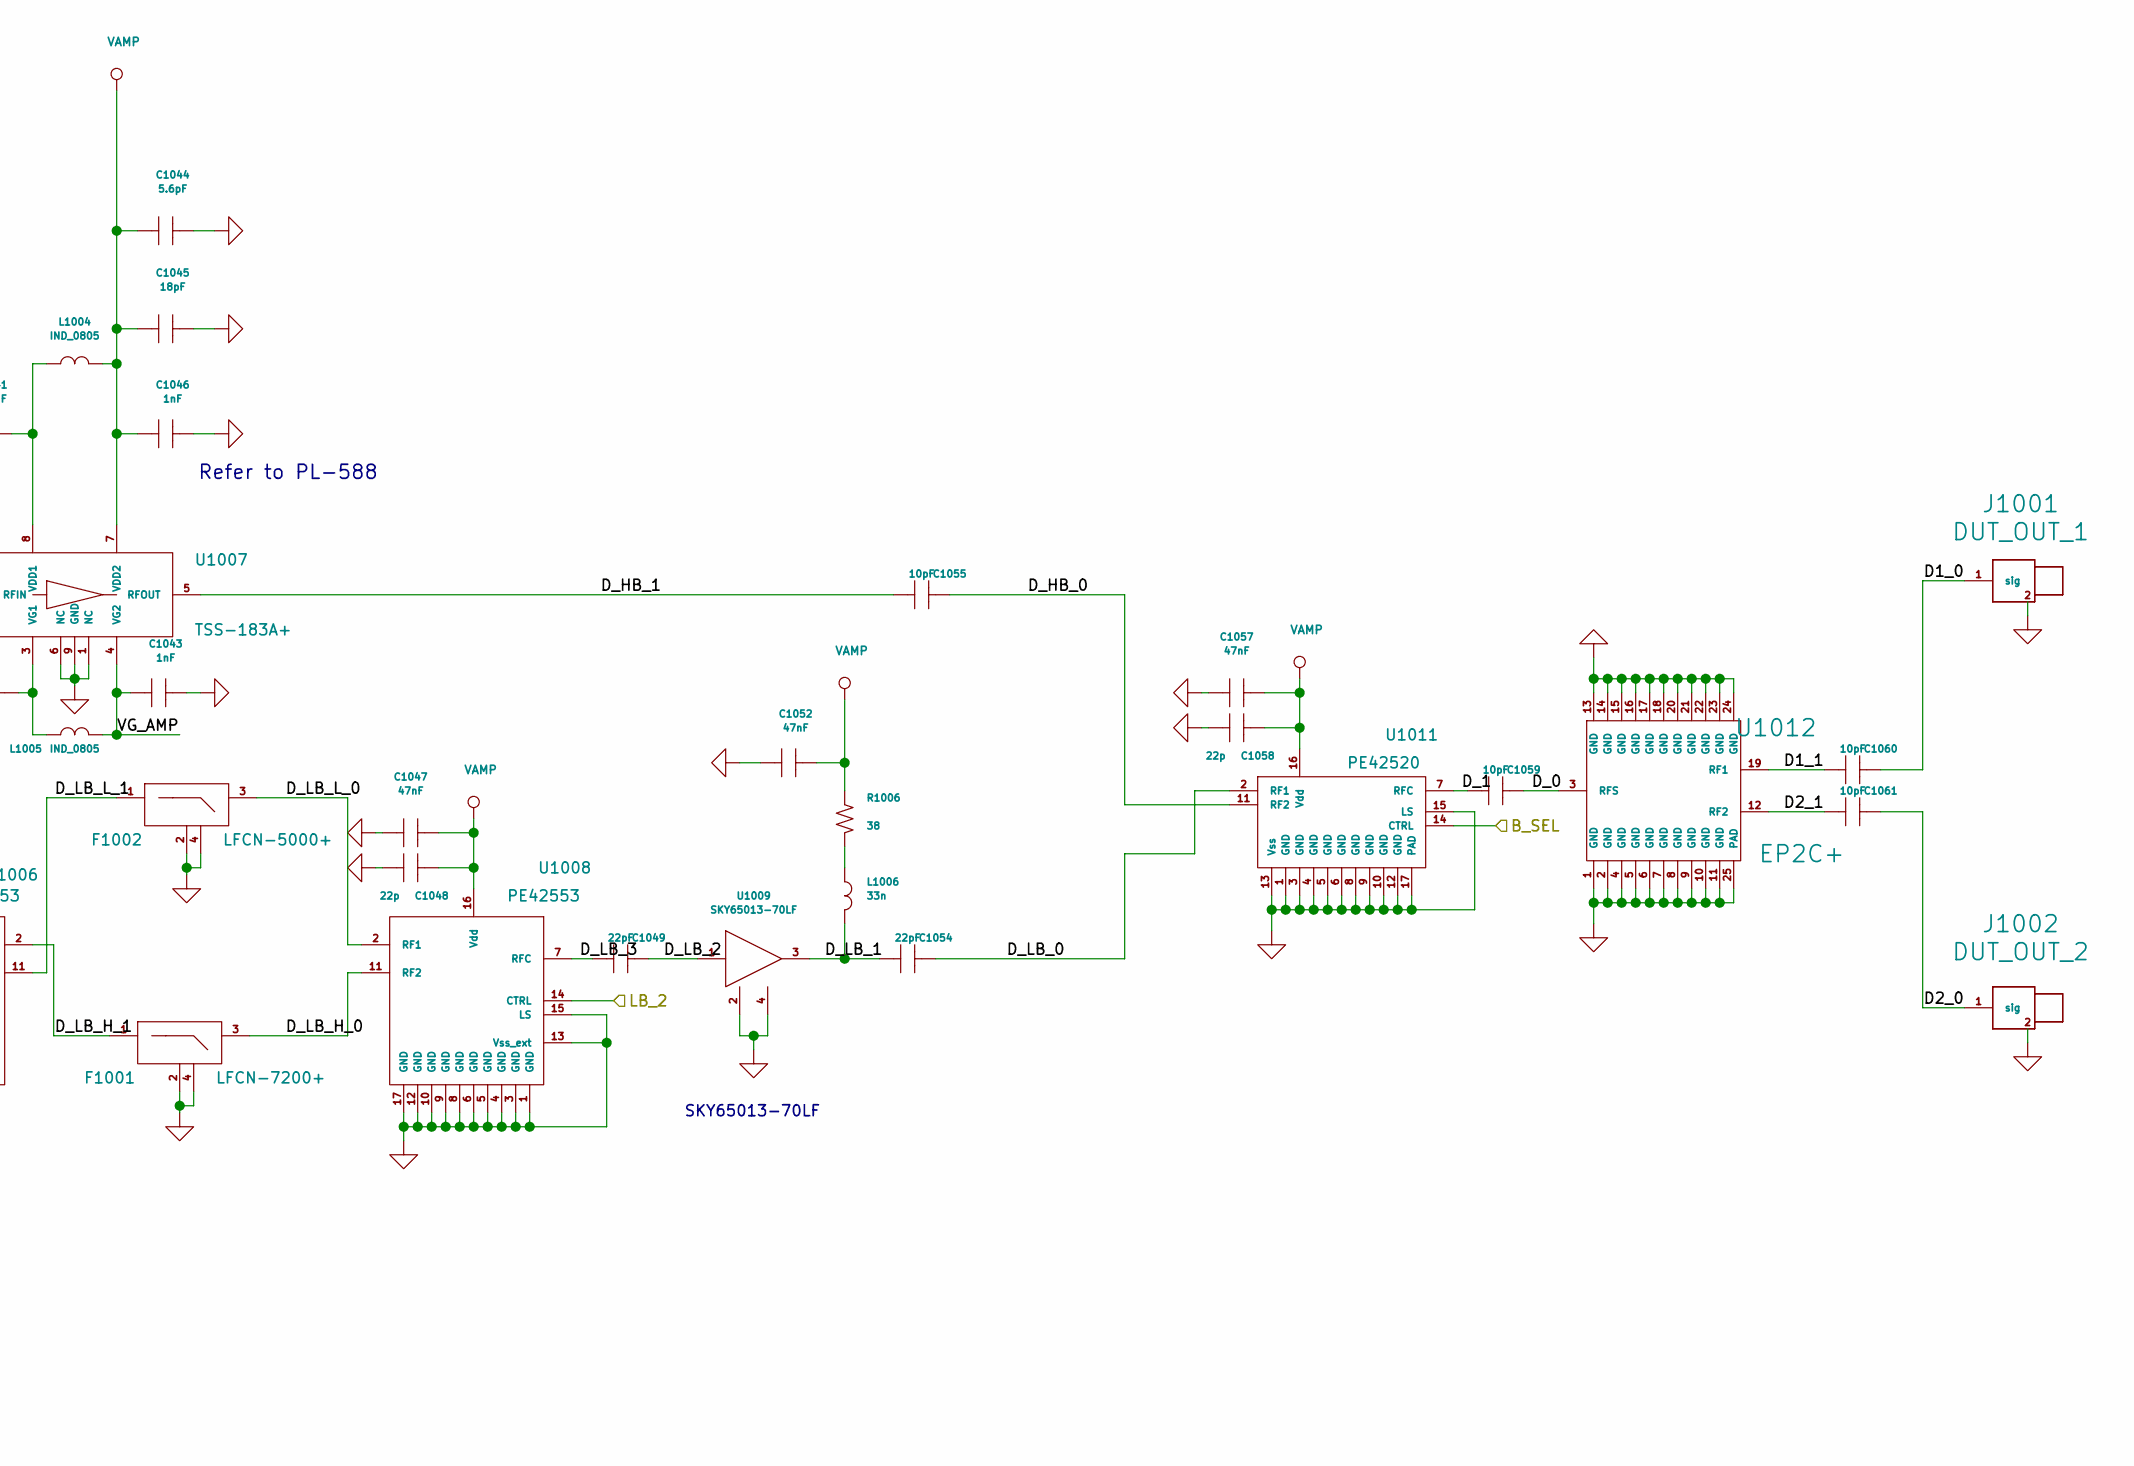
[picture p33: schematic ad5355.kicad_sch, part in row 1, column 2]

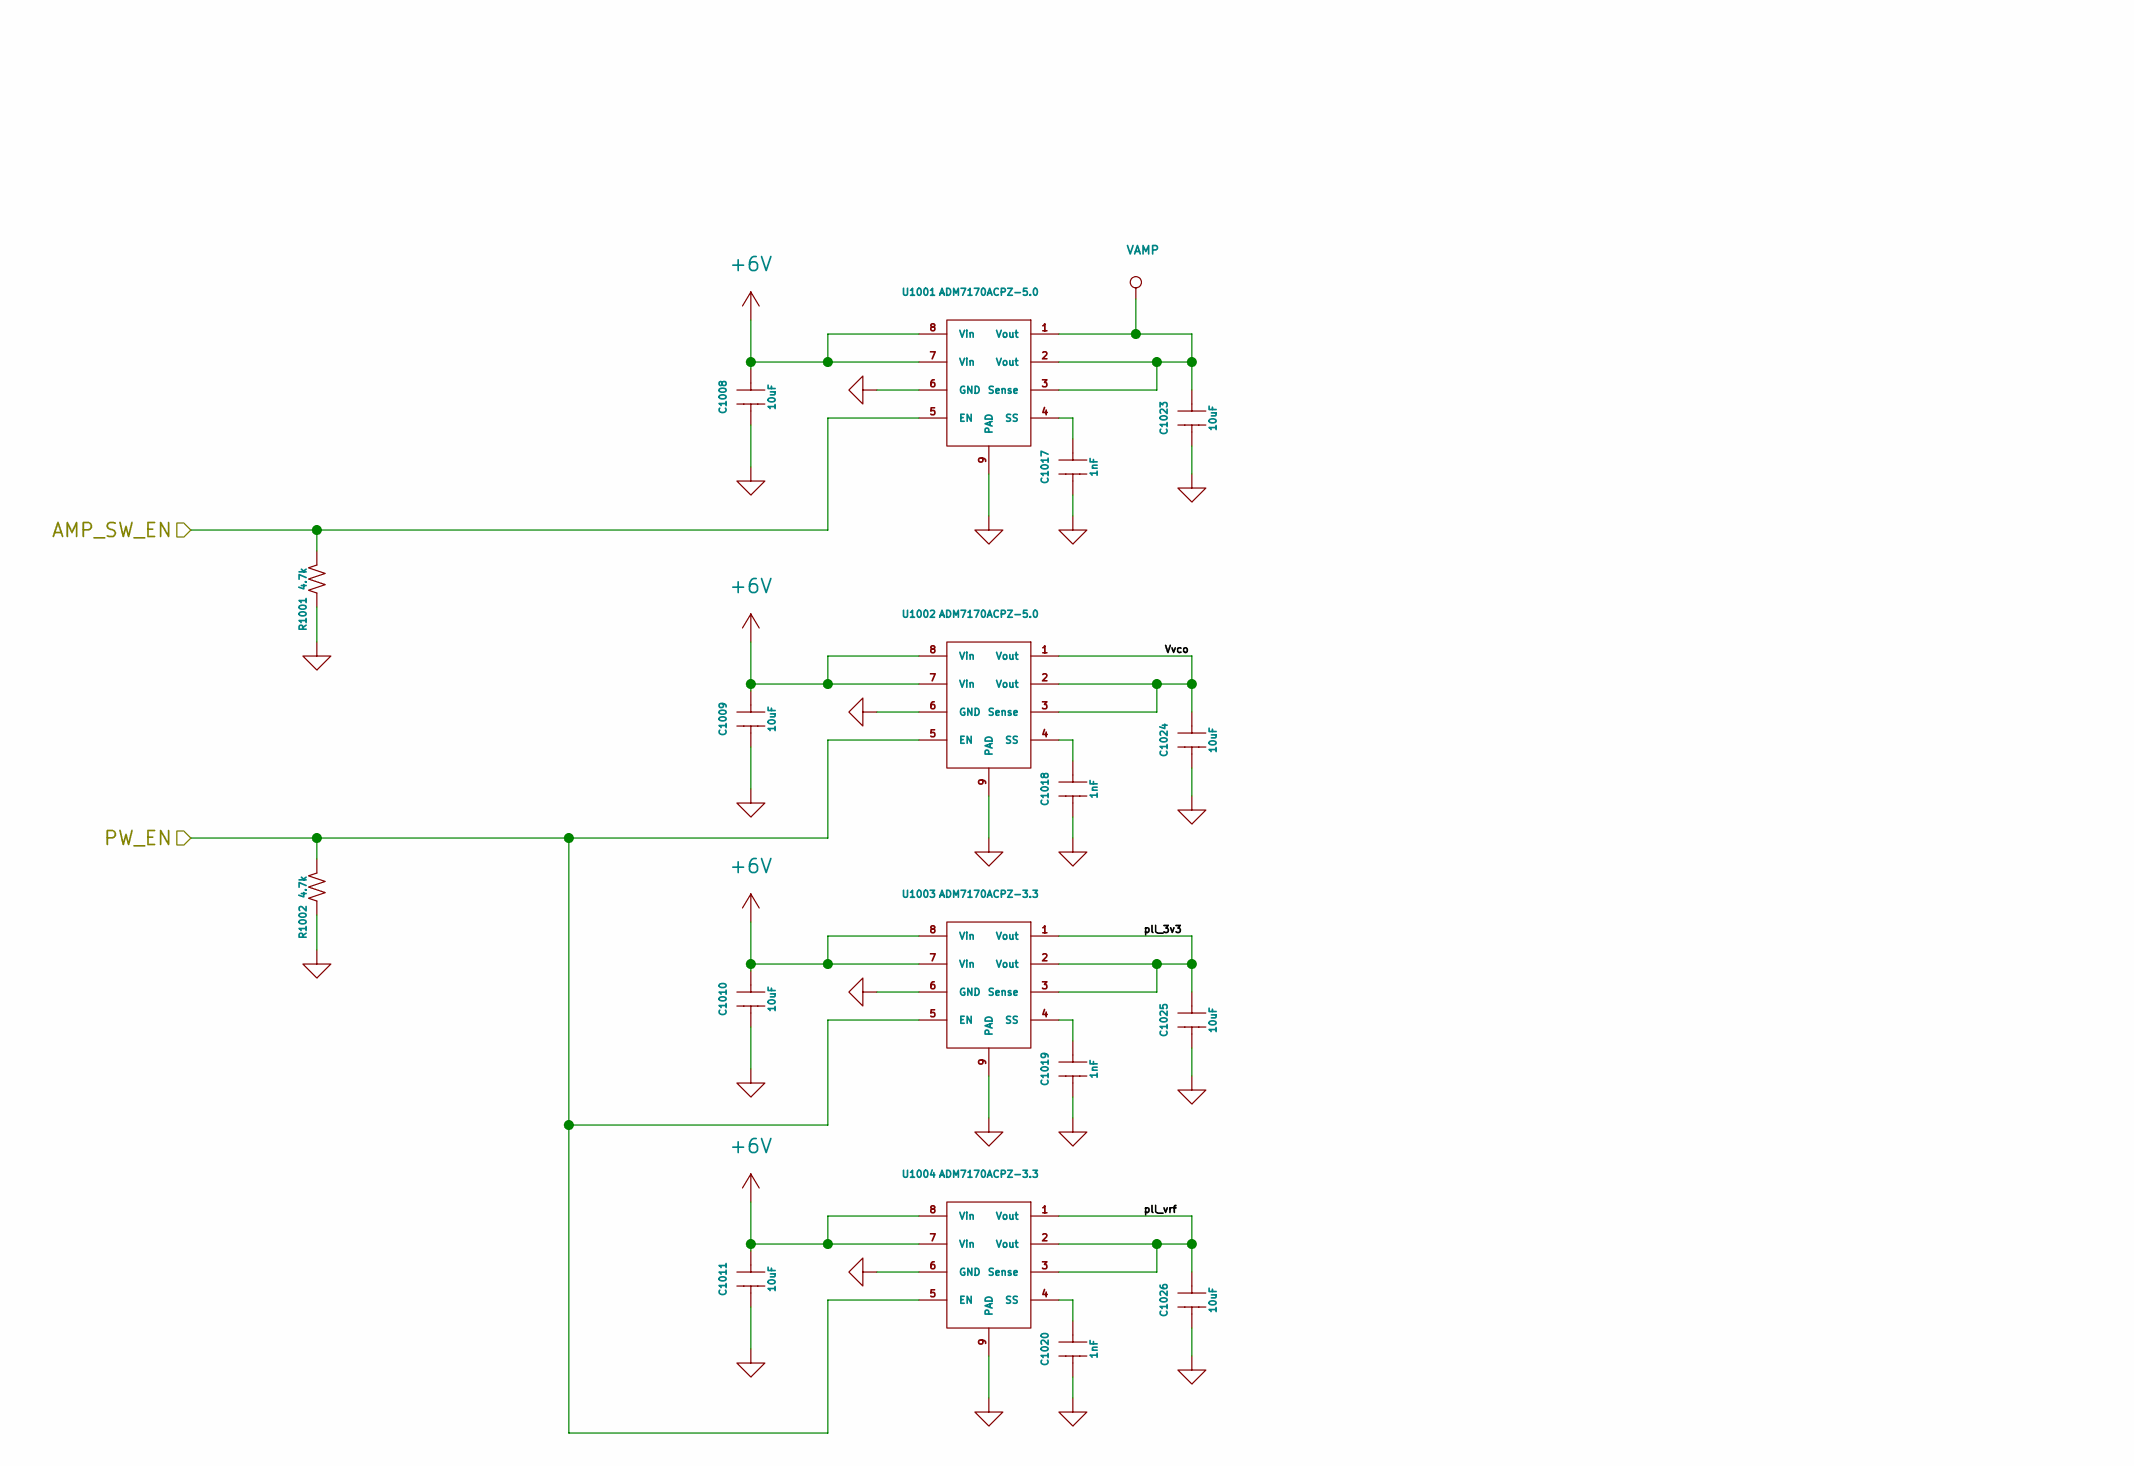
[picture p34: schematic ad5355.kicad_sch, part in row 2, column 1]

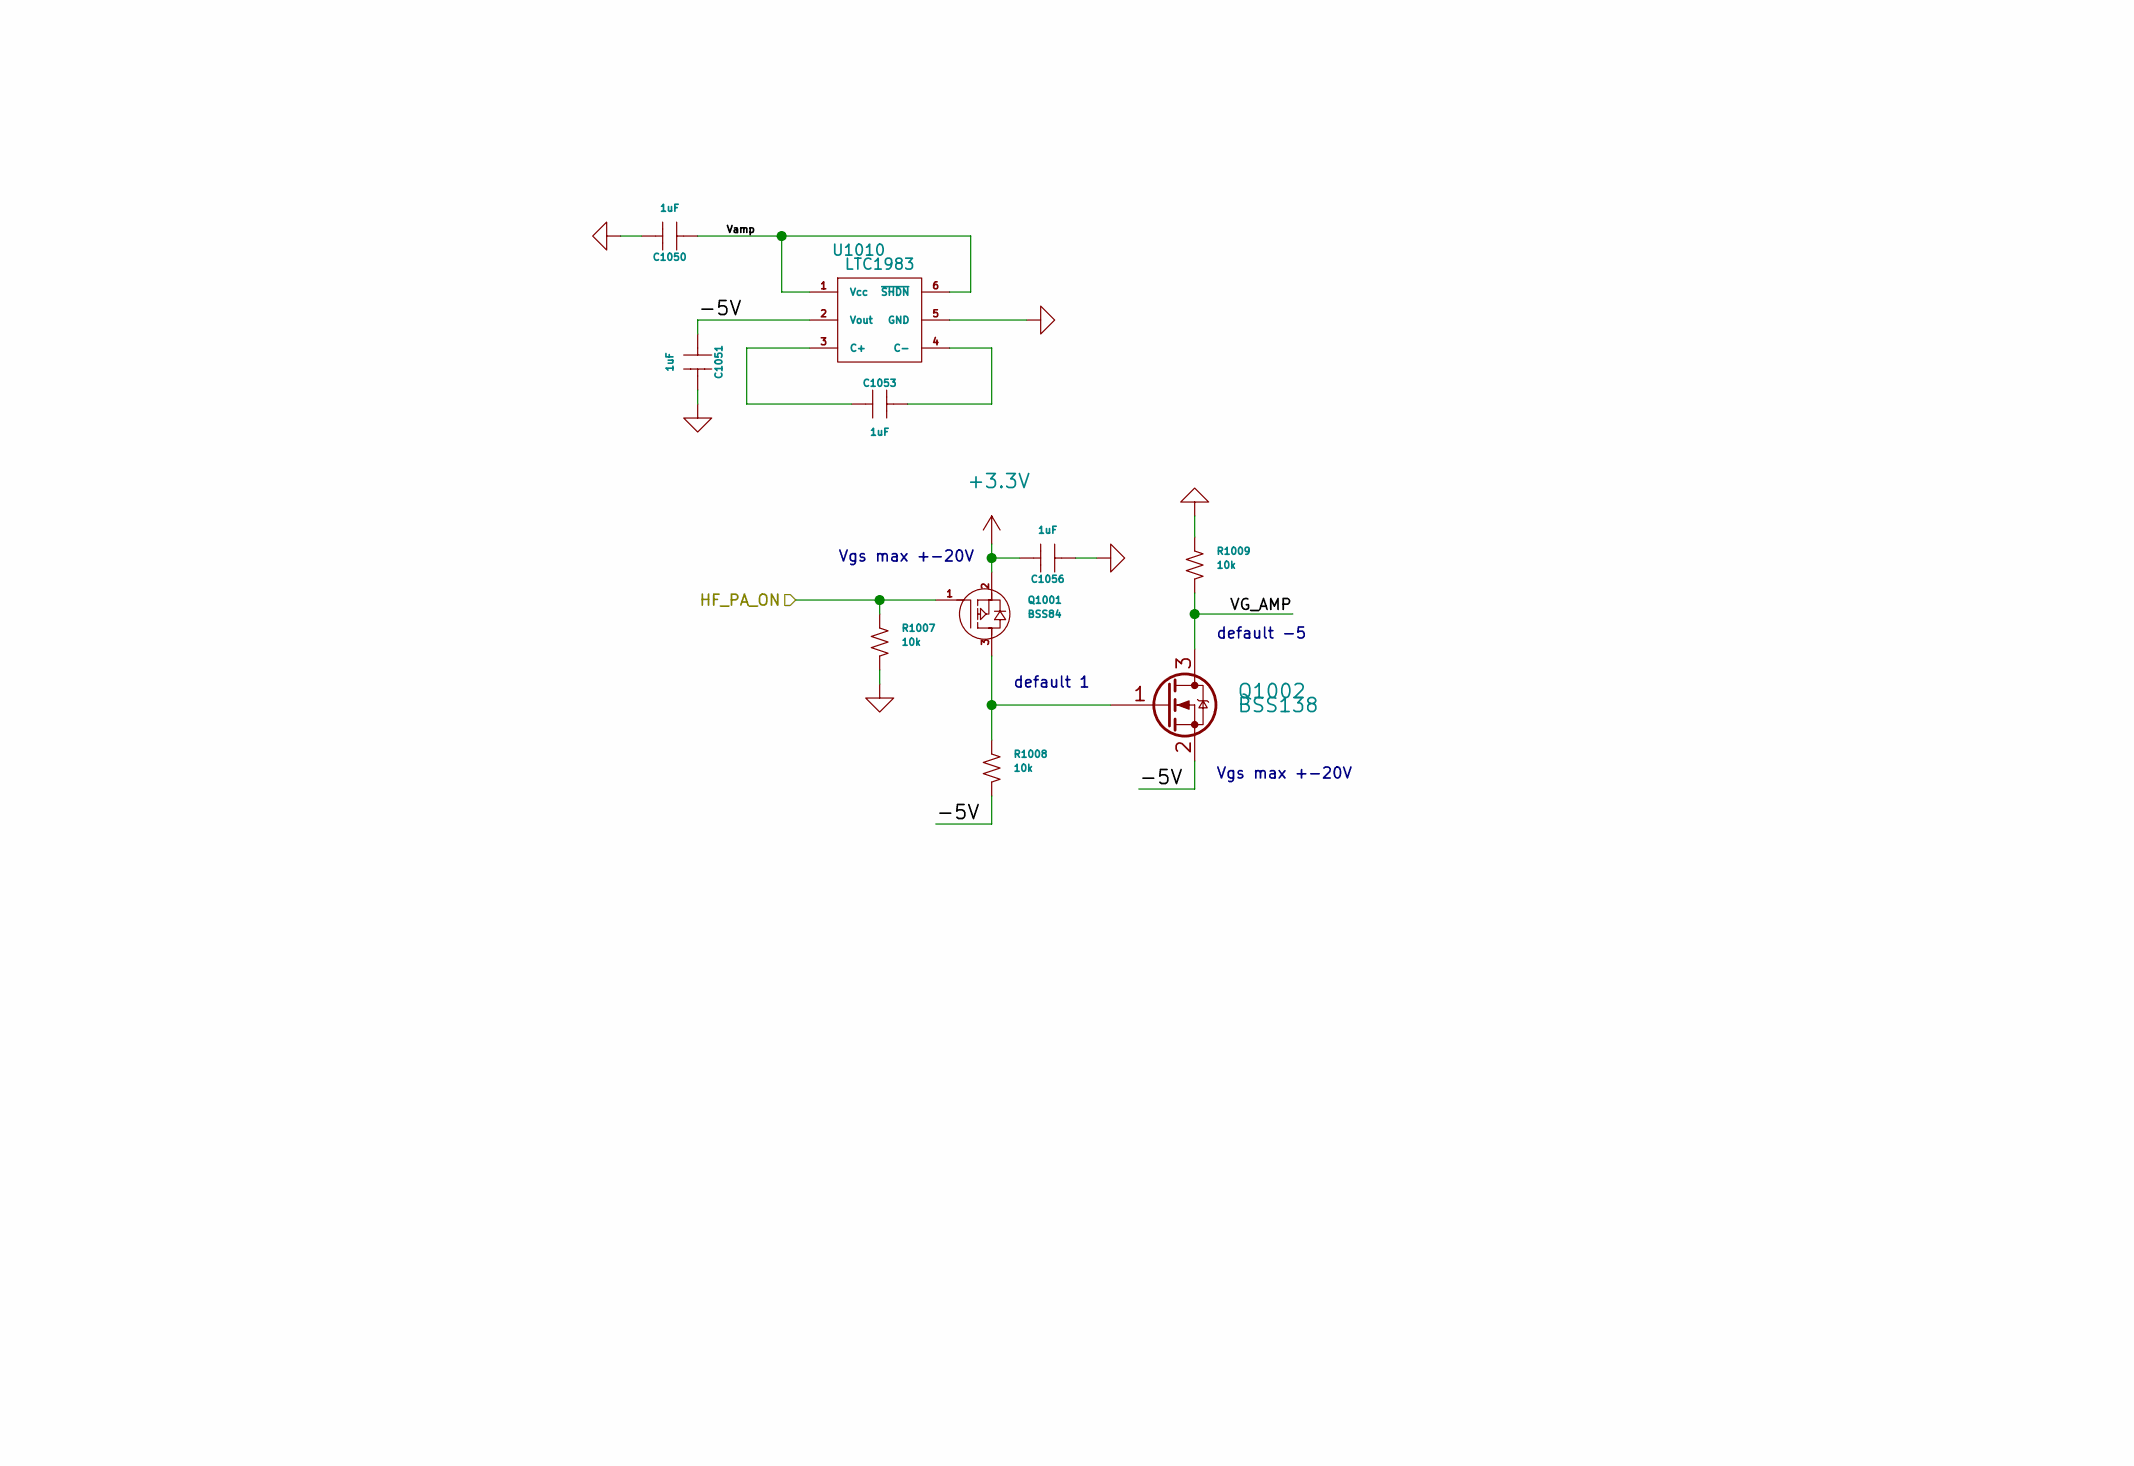
[picture p35: schematic ad5355.kicad_sch, part in row 2, column 2]

Parts:
C1001, C1003, C1015, C1021, C1022, C1028, C1032, C1034, C1041: 100nF; SM0402
C1002, C1004, C1005, C1016, C1027, C1031, C1033, C1036, C1037, C1040, C1055, C1059, C1060, C1061: 10pF; SM0402
C1006: 390pF; SM0402
C1007: 33nF; SM0402
C1008, C1009, C1010, C1011, C1023, C1024, C1025, C1026: 10uF; SM0805
C1012: 1500pF; SM0402
C1017, C1018, C1019, C1020: 1nF; SM0603
C1029, C1030, C1035, C1049, C1054: 22pF; SM0402
C1038, C1047, C1052, C1057: 47nF; SM0603
C1039, C1048, C1058: 22p; SM0402
C1042, C1043, C1046: 1nF; SM0402
C1044: 5.6pF; SM0402
C1045: 18pF; SM0402
C1050, C1051, C1053, C1056: 1uF; SM0805
F1001: LFCN-7200+; FV1206
F1002: LFCN-5000+; FV1206
J1001: DUT_OUT_1; CINCH_142-0701-881
J1002: DUT_OUT_2; CINCH_142-0701-881
K1001: TCM1-83X-1+; DB1627
L1001, L1002: 7.5nH; SM0402
L1003: NC; SM0402
L1004, L1005: IND_0805; SM0805
L1006: 33n; SM0603
Q1001: BSS84; SOT-23
Q1002: BSS138; SOT-23
R1001, R1002, R1005: 4.7k; SM0402
R1003: RES_0402; SM0402
R1004: 1k; SM0402
R1006: 38; SM0603
R1007, R1008, R1009: 10k; SM0402
U1001, U1002: ADM7170ACPZ-5.0; DFN8_3x3mm
U1003, U1004: ADM7170ACPZ-3.3; DFN8_3x3mm
U1005: ADF5355; QFN32_5x5mm_3.6mm
U1006, U1008: PE42553; QFN-16_EP_3x3_Pitch0.5mm
U1007: TSS-183A+; DQ849
U1009: SKY65013-70LF; SOT89-SKY65013-70
U1010: LTC1983; SOT23-6
U1011: PE42520; QFN-16_EP_3x3_Pitch0.5mm
U1012: EP2C+; QFN24_4x4_0.5mm

Connections:
+3.3VA: C1056.2, Q1001.2 (S); also elsewhere on the board
+6V: C1008.1, C1009.1, C1010.1, C1011.1, U1001.7 (Vin), U1001.8 (Vin), U1002.7 (Vin), U1002.8 (Vin), U1003.7 (Vin), U1003.8 (Vin), U1004.7 (Vin), U1004.8 (Vin); also elsewhere on the board
/ANALOG_EN: R1001.2, R1002.2, U1001.5 (EN), U1002.5 (EN), U1003.5 (EN), U1004.5 (EN); also elsewhere on the board
/FPGA/SIGGEN_CLK: U1005.1 (CLK); also elsewhere on the board
/FPGA/SIGGEN_DATA: U1005.2 (DATA); also elsewhere on the board
/FPGA/SIGGEN_LE: U1005.3 (LE); also elsewhere on the board
/FPGA/SIGGEN_LOCK: U1005.30 (MUXout); also elsewhere on the board
/OUTPUT_PA_ON: Q1001.1 (G), R1007.1; also elsewhere on the board
/PLL DUT/-5V: C1051.1, Q1002.2 (S), R1008.2, U1010.2 (Vout)
/PLL DUT/D1_0: C1060.2, J1001.1 (sig)
/PLL DUT/D1_1: C1060.1, U1012.19 (RF1)
/PLL DUT/D2_0: C1061.2, J1002.1 (sig)
/PLL DUT/D2_1: C1061.1, U1012.12 (RF2)
/PLL DUT/D_0: C1059.2, U1012.3 (RFS)
/PLL DUT/D_1: C1059.1, U1011.7 (RFC)
/PLL DUT/D_HB_0: C1055.2, U1011.11 (RF2)
/PLL DUT/D_HB_1: C1055.1, U1007.5 (RFOUT)
/PLL DUT/D_HB_2: C1040.2, U1007.2 (RFIN)
/PLL DUT/D_HB_3: C1037.2, C1040.1, L1003.1
/PLL DUT/D_HB_4: C1037.1, U1005.14 (RFoutB)
/PLL DUT/D_LB_0: C1054.2, U1011.2 (RF1)
/PLL DUT/D_LB_1: C1054.1, L1006.2, U1009.3 (OUT)
/PLL DUT/D_LB_2: C1049.2, U1009.1 (IN)
/PLL DUT/D_LB_3: C1049.1, U1008.7 (RFC)
/PLL DUT/D_LB_4: C1035.2, U1006.7 (RFC)
/PLL DUT/D_LB_5: C1035.1, K1001.3 (PDOT)
/PLL DUT/D_LB_H_0: F1001.3 (RFOUT), U1008.11 (RF2)
/PLL DUT/D_LB_H_1: F1001.1 (RFIN), U1006.2 (RF1)
/PLL DUT/D_LB_L_0: F1002.3 (RFOUT), U1008.2 (RF1)
/PLL DUT/D_LB_L_1: F1002.1 (RFIN), U1006.11 (RF2)
/PLL DUT/VG_AMP: C1043.1, L1005.2, Q1002.3 (D), R1009.2, U1007.4 (VG2)
/PLL DUT/Vamp: C1050.1, U1010.1 (Vcc), U1010.6 (~SHDN)
/PLL DUT/Vtune: C1006.1, R1003.1, U1005.20 (VTune)
/PLL DUT/Vvco: C1005.1, C1024.1, C1028.1, C1031.1, U1002.1 (Vout), U1002.2 (Vout), U1002.3 (Sense), U1005.6 (Vp), U1005.17 (Vvco), U1005.19 (Vregvco)
/PLL DUT/p_a_0_N: C1029.1, L1002.2, U1005.12 (RFoutA-)
/PLL DUT/p_a_0_P: C1030.2, L1001.2, U1005.11 (RFoutA+)
/PLL DUT/p_a_1_N: C1029.2, K1001.5 (SDOT)
/PLL DUT/p_a_1_P: C1030.1, K1001.4 (S)
/PLL DUT/pll_3v3: C1001.1, C1002.1, C1003.1, C1004.1, C1022.1, C1025.1, C1027.1, U1003.1 (Vout), U1003.2 (Vout), U1003.3 (Sense), U1005.4 (CE), U1005.5 (Avdd), U1005.16 (Avdd), U1005.26 (PDBrf), U1005.27 (Dvdd)
/PLL DUT/pll_vrf: C1016.1, C1026.1, L1001.1, L1002.1, U1004.1 (Vout), U1004.2 (Vout), U1004.3 (Sense), U1005.10 (Vrf)
/SIGGEN_BANDSEL: U1011.14 (CTRL); also elsewhere on the board
/SIGGEN_CLK_N: U1005.28 (REFinB); also elsewhere on the board
/SIGGEN_CLK_P: U1005.29 (REFinA); also elsewhere on the board
/SIGGEN_LB1: U1006.14 (CTRL); also elsewhere on the board
/SIGGEN_LB2: U1008.14 (CTRL); also elsewhere on the board
GND: C1001.2, C1002.2, C1003.2, C1004.2, C1005.2, C1006.2, C1008.2, C1009.2, C1010.2, C1011.2, C1012.2, C1015.2, C1016.2, C1017.2, C1018.2, C1019.2, C1020.2, C1021.1, C1022.2, C1023.2, C1024.2, C1025.2, C1026.2, C1027.2, C1028.2, C1031.2, C1032.2, C1033.2, C1034.2, C1036.2, C1038.1, C1039.1, C1041.2, C1042.2, C1043.2, C1044.2, C1045.2, C1046.2, C1047.1, C1048.1, C1050.2, C1051.2, C1052.1, C1056.1, C1057.1, C1058.1, F1001.2 (GND), F1001.4 (GND), F1002.2 (GND), F1002.4 (GND), J1001.2, J1002.2, K1001.2 (PGND), L1003.2, R1001.1, R1002.1, R1004.2, R1005.1, R1007.2, R1009.1, U1001.6 (GND), U1001.9 (PAD), U1002.6 (GND), U1002.9 (PAD), U1003.6 (GND), U1003.9 (PAD), U1004.6 (GND), U1004.9 (PAD), U1005.8 (CPgnd), U1005.9 (Agnd), U1005.13 (Agndrf), U1005.15 (Agndrf), U1005.18 (Agndvco), U1005.21 (Agndvco), U1005.31 (SDgnd), U1005.33 (PAD), U1006.1 (GND), U1006.3 (GND), U1006.4 (GND), U1006.5 (GND), U1006.6 (GND), U1006.8 (GND), U1006.9 (GND), U1006.10 (GND), U1006.12 (GND), U1006.13 (Vss_ext), U1006.15 (LS), U1006.17 (GND), U1007.1 (NC), U1007.6 (NC), U1007.9 (GND), U1008.1 (GND), U1008.3 (GND), U1008.4 (GND), U1008.5 (GND), U1008.6 (GND), U1008.8 (GND), U1008.9 (GND), U1008.10 (GND), U1008.12 (GND), U1008.13 (Vss_ext), U1008.15 (LS), U1008.17 (GND), U1009.2 (GND), U1009.4 (GND), U1010.5 (GND), U1011.1 (GND), U1011.3 (GND), U1011.4 (GND), U1011.5 (GND), U1011.6 (GND), U1011.8 (GND), U1011.9 (GND), U1011.10 (GND), U1011.12 (GND), U1011.13 (Vss), U1011.15 (LS), U1011.17 (PAD), U1012.1 (GND), U1012.2 (GND), U1012.4 (GND), U1012.5 (GND), U1012.6 (GND), U1012.7 (GND), U1012.8 (GND), U1012.9 (GND), U1012.10 (GND), U1012.11 (GND), U1012.13 (GND), U1012.14 (GND), U1012.15 (GND), U1012.16 (GND), U1012.17 (GND), U1012.18 (GND), U1012.20 (GND), U1012.21 (GND), U1012.22 (GND), U1012.23 (GND), U1012.24 (GND), U1012.25 (PAD); also elsewhere on the board
unnamed: C1007.1, C1012.1, R1003.2, U1005.7 (CPout)
unnamed: C1007.2, R1004.1
unnamed: C1015.1, U1005.32 (Creg2)
unnamed: C1017.1, U1001.4 (SS)
unnamed: C1018.1, U1002.4 (SS)
unnamed: C1019.1, U1003.4 (SS)
unnamed: C1020.1, U1004.4 (SS)
unnamed: C1021.2, U1005.25 (Creg1)
unnamed: C1032.1, C1033.1, U1005.23 (Vref)
unnamed: C1034.1, C1036.1, U1005.24 (Vbias)
unnamed: C1041.1, L1004.1, U1007.8 (VDD1)
unnamed: C1042.1, L1005.1, U1007.3 (VG1)
unnamed: C1053.1, U1010.3 (C+)
unnamed: C1053.2, U1010.4 (C-)
unnamed: L1006.1, R1006.2
unnamed: Q1001.3 (D), Q1002.1 (G), R1008.1
unnamed: R1005.2, U1005.22 (Rset)
VAMP: C1023.1, C1038.2, C1039.2, C1044.1, C1045.1, C1046.1, C1047.2, C1048.2, C1052.2, C1057.2, C1058.2, L1004.2, R1006.1, U1001.1 (Vout), U1001.2 (Vout), U1001.3 (Sense), U1006.16 (Vdd), U1007.7 (VDD2), U1008.16 (Vdd), U1011.16 (Vdd); also elsewhere on the board

Notes on the sheet:
Vgs max +-20V
default 1
default -5
Refer to PL-588
SKY65013-70LF

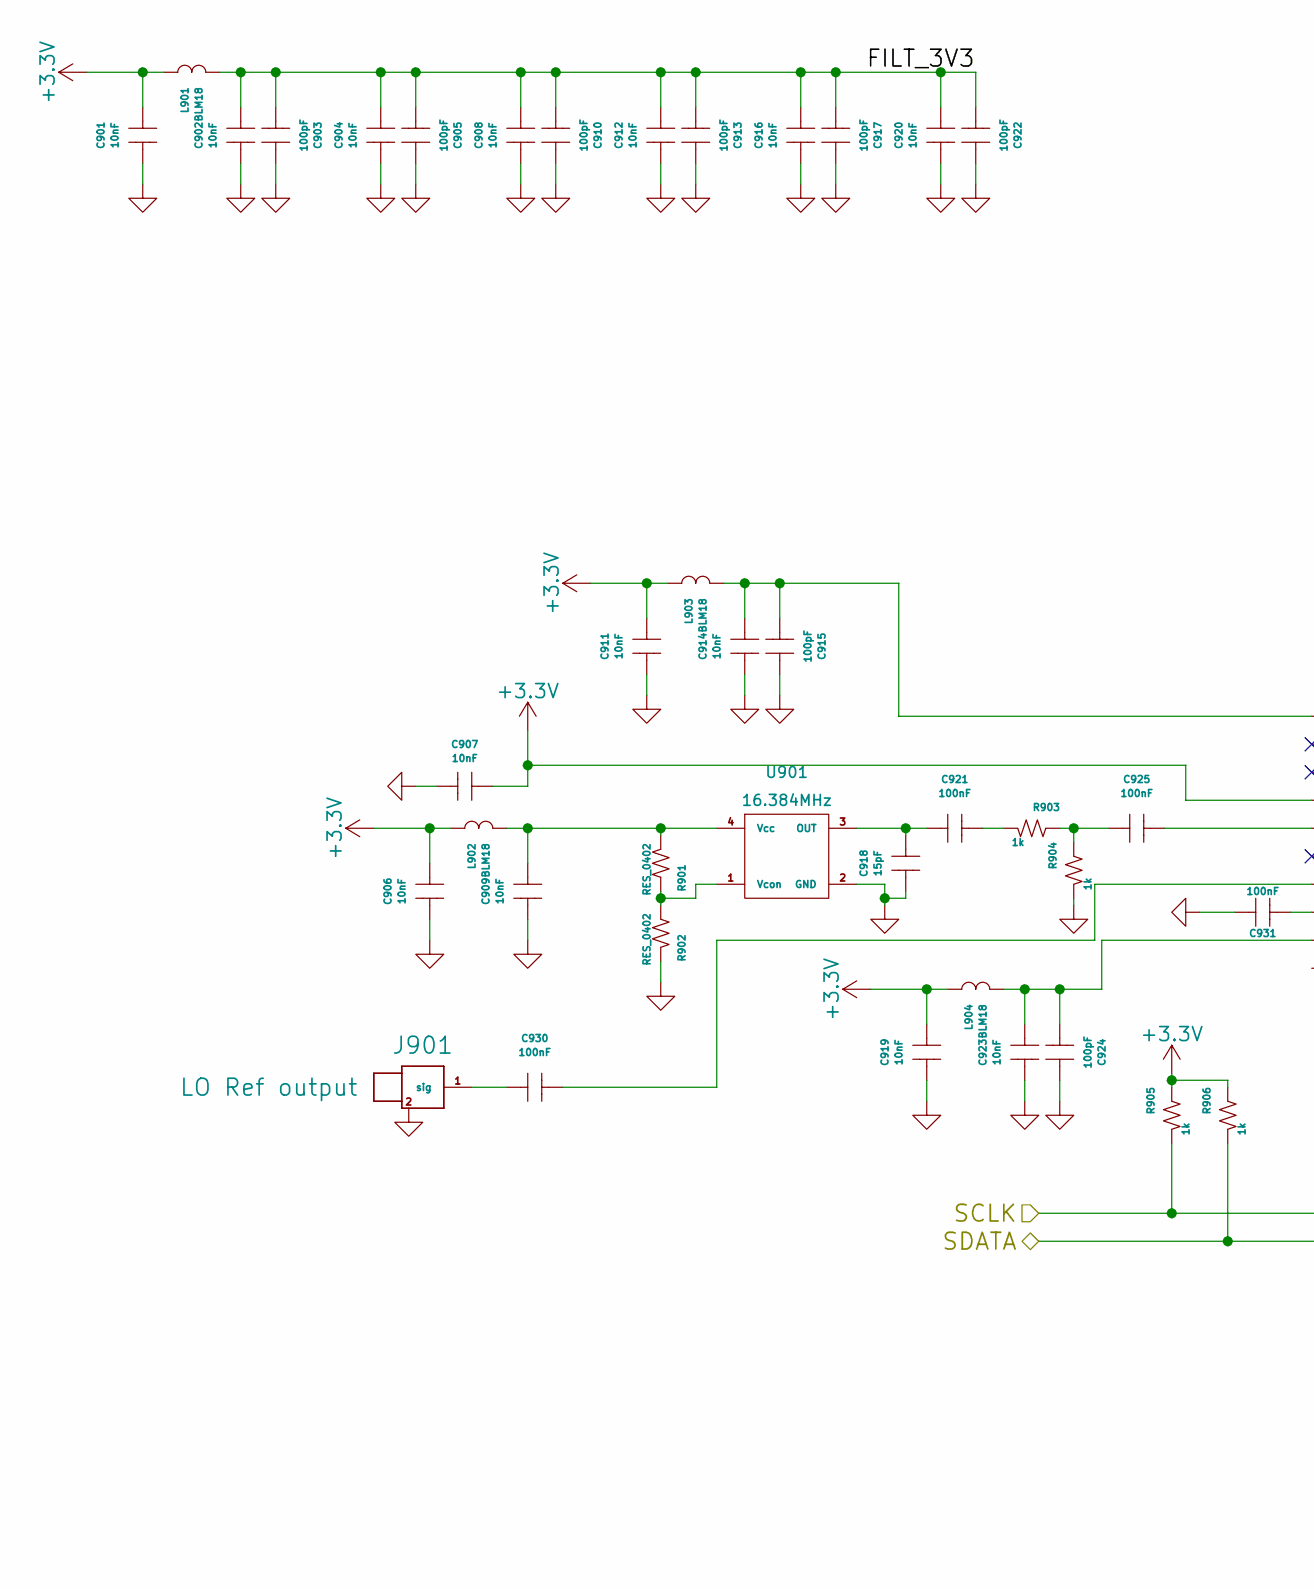
[picture p36: schematic clocking.kicad_sch, part in row 1, column 1]

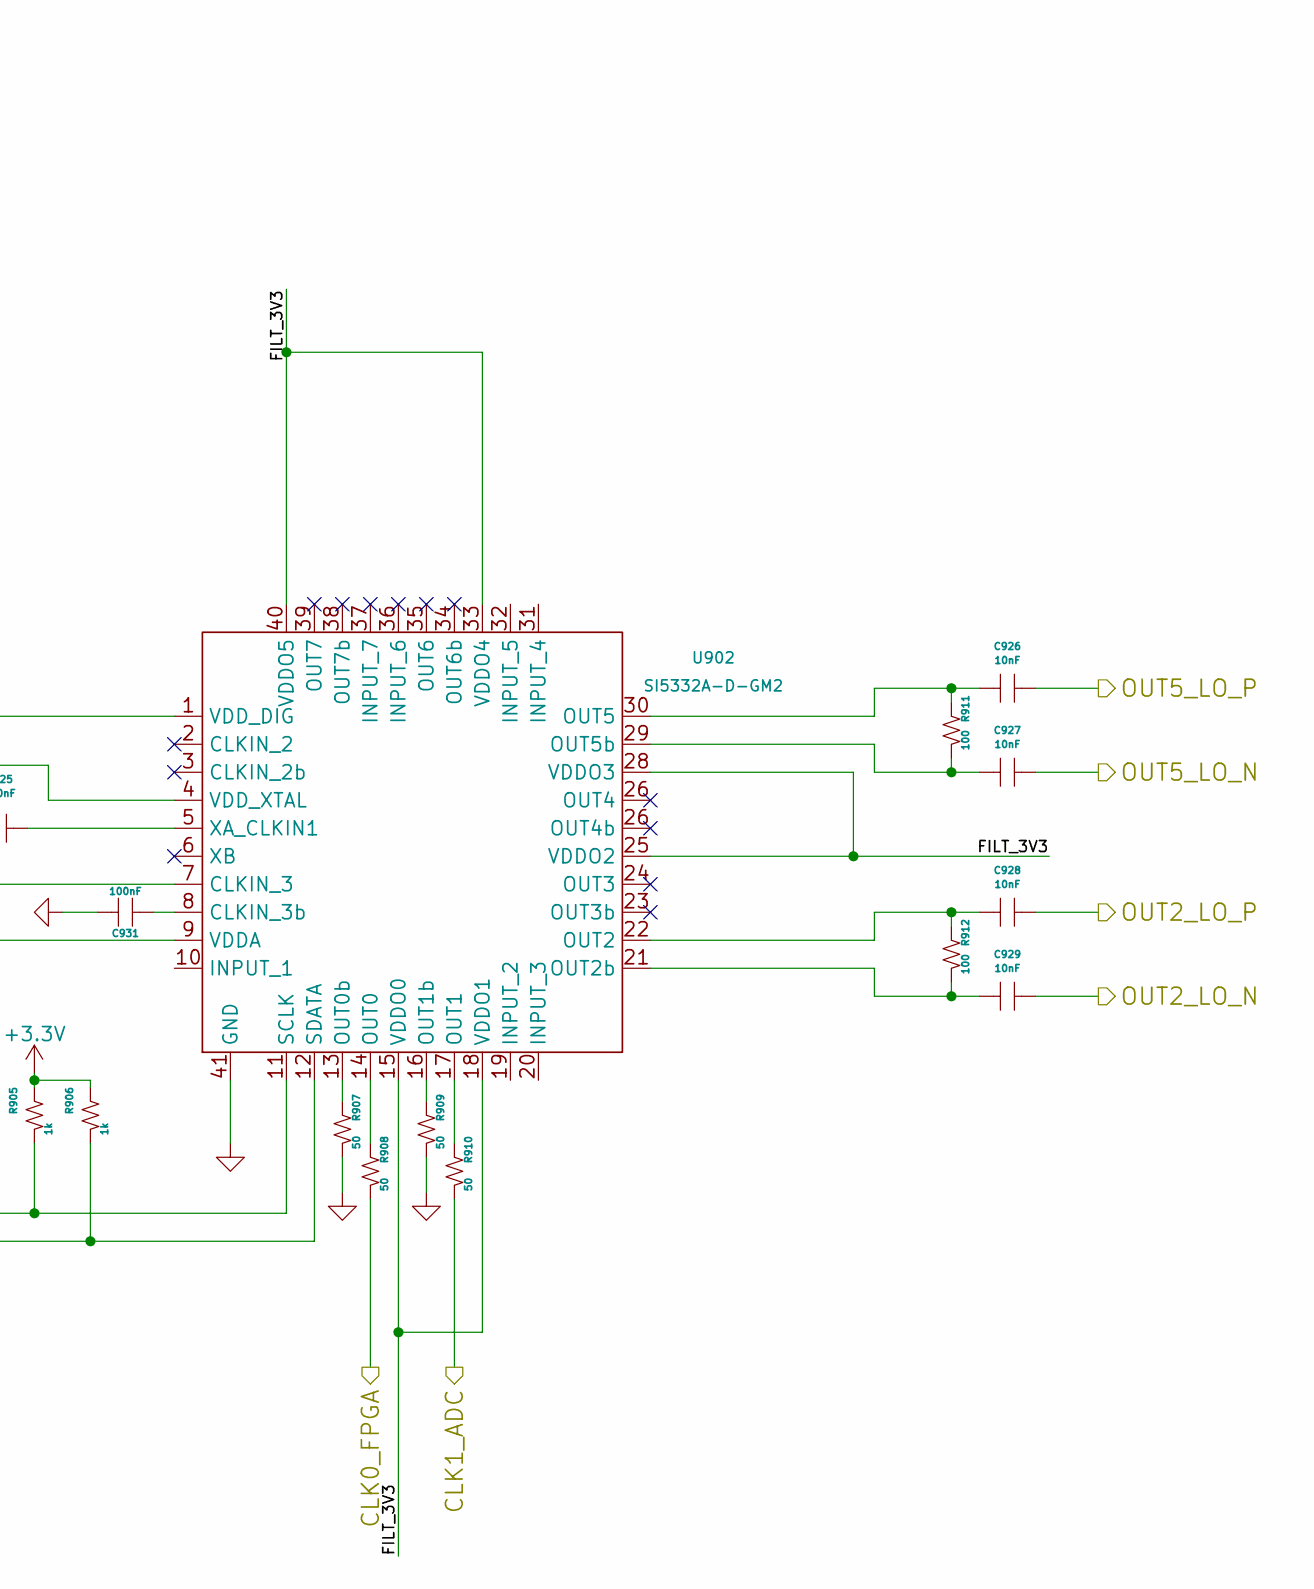
[picture p37: schematic clocking.kicad_sch, part in row 1, column 2]

Parts:
C901, C902, C904, C906, C907, C908, C909, C911, C912, C914, C916, C919, C920, C923, C926, C927, C928, C929: 10nF; SM0402
C903, C905, C910, C913, C915, C917, C922, C924: 100pF; SM0402
C918: 15pF; SM0402
C921, C925, C930, C931: 100nF; SM0402
J901: LO Ref output; SMA_AMP_132255-12
L901, L902, L903, L904: BLM18; SM0603
R901, R902: RES_0402; SM0402
R903, R904, R905, R906: 1k; SM0402
R907, R908, R909, R910: 50; SM0402
R911, R912: 100; SM0402
U901: 16.384MHz; IQD_CFPT-126
U902: SI5332A-D-GM2; SI5332A_QFN40_EP_5.9x5.9_Pitch0.5mm

Connections:
+3.3VA: C901.1, C906.1, C907.1, C911.1, C919.1, L901.2, L902.2, L903.2, L904.2, R905.1, R906.1, U902.4 (VDD_XTAL); also elsewhere on the board
/ADC_CLK: R910.2; also elsewhere on the board
/Clocking/FILT_3V3: C902.1, C903.2, C904.1, C905.2, C908.1, C910.2, C912.1, C913.2, C916.1, C917.2, C920.1, C922.2, L901.1, U902.15 (VDDO0), U902.18 (VDDO1), U902.25 (VDDO2), U902.28 (VDDO3), U902.33 (VDDO4), U902.40 (VDDO5)
/Clocking/SCLK: R905.2, U902.11 (SCLK); also elsewhere on the board
/Clocking/SDATA: R906.2, U902.12 (SDATA); also elsewhere on the board
/FPGA_CLK: R908.2; also elsewhere on the board
/PLL/XO_N: C927.2; also elsewhere on the board
/PLL/XO_P: C926.2; also elsewhere on the board
/SIGGEN_CLK_N: C929.2; also elsewhere on the board
/SIGGEN_CLK_P: C928.2; also elsewhere on the board
GND: C901.2, C902.2, C903.1, C904.2, C905.1, C906.2, C907.2, C908.2, C909.2, C910.1, C911.2, C912.2, C913.1, C914.2, C915.1, C916.2, C917.1, C918.2, C919.2, C920.2, C922.1, C923.2, C924.1, C931.1, J901.2, R902.2, R904.2, R907.2, R909.2, U901.2 (GND), U902.41 (GND); also elsewhere on the board
unnamed: C909.1, L902.1, R901.2, U901.4 (Vcc)
unnamed: C914.1, C915.2, L903.1, U902.1 (VDD_DIG)
unnamed: C918.1, C921.1, U901.3 (OUT)
unnamed: C921.2, R903.2
unnamed: C923.1, C924.2, L904.1, U902.9 (VDDA)
unnamed: C925.1, R903.1, R904.1
unnamed: C925.2, U902.5 (XA_CLKIN1)
unnamed: C926.1, R911.1, U902.30 (OUT5)
unnamed: C927.1, R911.2, U902.29 (OUT5b)
unnamed: C928.1, R912.1, U902.22 (OUT2)
unnamed: C929.1, R912.2, U902.21 (OUT2b)
unnamed: C930.1, J901.1 (sig)
unnamed: R901.1, R902.1, U901.1 (Vcon)
unnamed: R907.1, U902.13 (OUT0b)
unnamed: R908.1, U902.14 (OUT0)
unnamed: R909.1, U902.16 (OUT1b)
unnamed: R910.1, U902.17 (OUT1)
unnamed: C930.2, U902.7 (CLKIN_3)
unnamed: C931.2, U902.8 (CLKIN_3b)
