natsfr/VNAV1.2/board/VNAV1/adccore.kicad_pcb

## KiCad design board/VNAV1/adccore.kicad_pcb (continued)

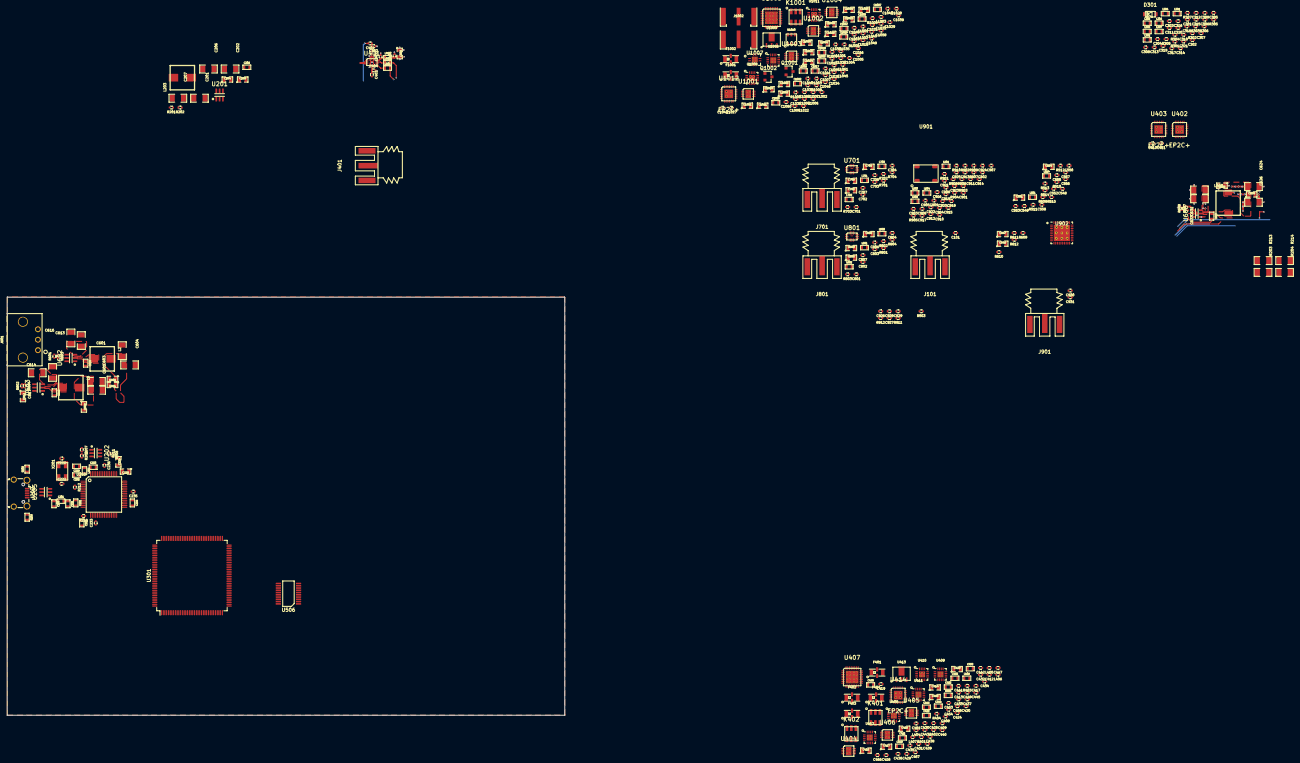
[picture p38: board adccore.kicad_pcb from above]

Board: 4 copper layers, 160.0 x 120.0 mm, 419 parts (1 on the bottom side), 264 nets.

Other parts of the board:
C701, C702, C703, C704, C706, C707, C801, C802, C803, C804, C806, C807: CAP_0402; SM0402
C705, C805: CAP_0805; SM0805
C708, C709, C808, C809: 100uF; SM0805
J701, J801: SMA_PCB; SMA_AMP_132255-12
L701, L702, L703, L801, L802, L803: IND_0603; SM0603
R701, R702, R801, R802: 25; SM0402
R703, R803: DNI; SM0402
R704, R804: 0; SM0402
U701, U801: LTC5548; QFN12_2x3mm_UDB_LT

Their connections:
+3.3VA: C705.2, C706.2, C805.2, C806.2, L701.2, L801.2, R703.1, R803.1; also elsewhere on the board
/ADC/A0_N: C809.2, R802.1; also elsewhere on the board
/ADC/A0_P: C808.2, R801.2; also elsewhere on the board
/ADC/A1_N: C709.2, R702.1; also elsewhere on the board
/ADC/A1_P: C708.2, R701.2; also elsewhere on the board
/Mixer DUT1/dut_lo: C701.2, C702.1, U701.11 (LO)
/Mixer DUT1/dut_rf: C703.2, C704.2, U701.5 (RF)
/Mixer DUT1/dut_rf_0: C703.1, J701.1 (sig)
/Mixer DUT1/mx_d_3v3: C707.2, L701.1, U701.9 (Vcc)
/Mixer DUT2/dut_lo: C801.2, C802.1, U801.11 (LO)
/Mixer DUT2/dut_rf: C803.2, C804.2, U801.5 (RF)
/Mixer DUT2/dut_rf_0: C803.1, J801.1 (sig)
/Mixer DUT2/mx_d_3v3: C807.2, L801.1, U801.9 (Vcc)
/PLL/LO_1: C701.1; also elsewhere on the board
/PLL/LO_3: C801.1; also elsewhere on the board
GND: C702.2, C704.1, C705.1, C706.1, C707.1, C802.2, C804.1, C805.1, C806.1, C807.1, J701.2, J801.2, R704.1, R804.1, U701.1 (GND), U701.4 (GND), U701.6 (GND), U701.10 (GND), U701.12 (GND), U701.13 (PAD), U801.1 (GND), U801.4 (GND), U801.6 (GND), U801.10 (GND), U801.12 (GND), U801.13 (PAD); also elsewhere on the board
unnamed: C708.1, U701.2 (IF_P)
unnamed: C709.1, U701.3 (IF_N)
unnamed: C808.1, U801.2 (IF_P)
unnamed: C809.1, U801.3 (IF_N)
unnamed: L702.1, U701.7 (EN)
unnamed: L703.1, U701.8 (X2)
unnamed: L802.1, U801.7 (EN)
unnamed: L803.1, U801.8 (X2)
unnamed: R701.1, R702.2, R703.2, R704.2
unnamed: R801.1, R802.2, R803.2, R804.2
